sykeisuke/asic_rd/docs/HANDOFF.md

# Project handoff — design-team onboarding

Date: 2026-09-18 (architecture revision; first version 2026-08-31)

Audience: new design-team members joining the Tape-out 1 effort (first
reader: the first design-team member starting September 2026).

## 1. What this project is

A waveform-sampling ASIC prototype with an on-chip Wilkinson ADC on the
GF180MCU 180 nm process, targeting the **wafer.space GF180MCU Run 3** MPW.
Tape-out 1 is deliberately small — the goal is a reproducible end-to-end flow
(spec → schematic → simulation → layout → signoff → fabrication →
measurement), not performance:

```text
1 analog channel
-> 4 bottom-plate sampling cells (54.5 fF MIM each)
-> 1 broadcast ramp applied to the capacitors, 1 comparator per cell
   (fixed-reference trip; no analog MUX)
-> shared 8-bit Gray counter, 4 parallel captures
-> four 8-bit registers
-> 32-bit synchronous serial readout
```

The long-term objective (multi-GSa/s, 8 channels, 12-bit — an IRSX-class
sampler for physics instrumentation) is documented in the specification but
is explicitly **not** a Tape-out 1 pass/fail criterion.

## 2. Hard deadlines (wafer.space Run 3, reconfirm at purchase)

| Milestone | Date |
| --- | --- |
| Early-bird pricing | missed (2026-09-30) — slot changed to `1x0.5`, $6,500 incl. COB (2026-10-02) |
| Slot purchase deadline | 2026-12-09 |
| Clean-GDS submission deadline | **2026-12-16** |
| Silicon delivered | Q2 2027 |

## 3. Read these, in this order

1. [`PROTOTYPE_SPECIFICATION.md`](PROTOTYPE_SPECIFICATION.md) — the controlled
   scope: architecture, Must/Target/Stretch requirements, frozen technology
   choices.
2. [`lecture/ASIC_Lab_Handbook_EN.md`](lecture/ASIC_Lab_Handbook_EN.md) — the
   hands-on lab sequence. **Start at Lab 0 and satisfy each acceptance check
   before moving on**; it walks through the exact tools and circuits of this
   project.
3. [`VERIFICATION_MATRIX.md`](VERIFICATION_MATRIX.md) — what is verified and
   the exact `make` target that reproduces each result.
4. [`ROADMAP.md`](ROADMAP.md) — phase status; Phase 0 (external constraints)
   is essentially closed, Phases 2–3 are where design work continues.
5. [`PDK_PAD_SUPPLY_FREEZE.md`](PDK_PAD_SUPPLY_FREEZE.md) — frozen technology
   baseline (PDK commit, 3.3 V libraries, pads) and how each provider
   question was resolved.
6. [`TAPEOUT_BLOCKERS.md`](TAPEOUT_BLOCKERS.md) — the non-optional work
   between here and tape-out.
7. [`decisions/`](decisions/) — why each major choice was made (ADR style).

## 4. State of the project (2026-09-18)

**Architecture revision 2026-09-18** (design review with the collaborating
IC-design group; spec 0.6-draft): analog MUX removed, comparator per cell
with parallel conversion, 54.5 fF MIM hold capacitor, bottom-plate sampling
with the ramp applied to the capacitor, 8-bit ADC. The RTL and its tests are
updated (`make parallel-controller`, `make digital-top`); a transistor-level
cell method study on the exploration branch `keisuke/analog-explore` established that the comparator must
sense the plate whose switch opened first (constant pedestal, no parasitic
gain error) — see that branch's `simulations/gf180_bottom_plate_cell/RESULTS.md`. The
analog blocks (cell, comparator, ramp) are being re-derived against the new
spec; the v0.5 blocks listed below remain as legacy references.

**Done and reproducible** (all pre-layout, typical corner):

- GF180 transistor-level simulations of the v0.5 analog blocks (legacy):
  sampling cell, 4-cell array, analog MUX, ramp generator, comparator (NMOS
  and PMOS variants), single Wilkinson slice, 8-point transfer, and 4-cell
  sequential conversion. Each has a numeric pass/fail check and a `make`
  target. New (0.6): the bottom-plate 54.5 fF cell study.
- Synthesizable RTL (0.6): shared 8-bit Gray counter with four
  comparator-edge capture channels and parallel controller, 32-bit serial
  readout, integrated `asic_digital_top` — self-checking testbenches, GF180
  mapping, 20 MHz pre-layout STA. The sequential 6-bit controller is kept for
  the legacy co-simulations.
- File-based mixed-signal co-verification: measured SPICE comparator timings
  drive the real RTL; a ±2 ns clock-phase sweep identified cell 2 as having
  only ~500 ps of CDC margin (known open issue).
- A complete RTL-to-GDS LibreLane flow of the 8-bit digital top with zero
  DRC/LVS/timing/antenna violations at 3.3 V (`gf180mcu_as_sc_mcu7t3v3`).
- CI (GitHub Actions): every PR runs the RTL/co-simulation suite in the
  pinned container; the full analog regression runs weekly and on demand.

**Gate A (provider constraints) — resolved 2026-08:**

- wafer.space issues no written confirmations and no design support; the
  authority is the automated precheck and CoB checks on
  <https://platform.wafer.space>. Community help: the provider Discord
  (public archive at <https://discord.wafer.space>).
- Frozen baseline (revised 2026-11-01): PDK/Ciel commit `792ef670`, template release 1.6.0 (`d99f6e1b`),
  `gf180mcu_as_sc_mcu7t3v3` cells + `gf180mcu_ocd_io` pads, everything 3.3 V,
  `1x0.5` slot + chip-on-board (COB) packaging (changed from `0.5x1` on
  2026-10-02 when the other slots sold out; ADR 0004 addendum).
- **All grounds are common on the default COB breakout** → only `AVDD` can be
  separately measured. A padring experiment (template fork, branch
  `avdd-core-pair-experiment`) re-typed two bidir positions into a second
  core `vdd/vss` pair and **passed the platform's CoB pad-mask check and all
  DRC** (platform Check #800; the "Not Manufacturable" verdict is only the
  empty-core minimum-density artifact, resolved by fill in a real build).
  Experiment GDS: [release `padring-experiment-v1`](https://github.com/sykeisuke/asic_rd/releases/tag/padring-experiment-v1).
- Analog pad ESD: `asig` pads carry HBM diodes to DVDD/DVSS only. Design
  rule adopted from the GF180 DRM: add local CDM secondary protection (diode
  perimeter > 25 um, series poly R > 50 ohm) at every gate-connected pad.
- Platform project exists: Manufacturing ID `G803UHWS` (0.5x1, CoB, private) — to be re-created for `1x0.5`.

## 5. Highest-priority open work (proposed order)

0. **Pin list, top-level schematic and test plan first** (review 2026-10-02):
   fix the chip context before fine-grained block design. Then keep a script
   that generates the full-chip GDS at any time, with dummy blocks where
   needed, and run it as a nightly regression (`mixed_signal/top_placement`
   is the intended home). Missing commits matter: `main` must build.

1. ~~Retarget the digital physical flow to 3.3 V~~ — done 2026-09-25: every
   digital script and the physical flow use `gf180mcu_as_sc_mcu7t3v3`
   (fetched into `.eda-tools/pdk` by `make pdk`; the container image ships
   only the 5 V cells). `make digital-physical` is clean at 3.3 V.
2. **Comparator re-derivation for the fixed-reference trip** (design team;
   review guidance 2026-10-02: matched current sources, balanced output
   inverter, ~5 um fingers, width parameter is per finger, fix the delay
   result, expected offset sigma ~5 mV; latch the output inside the cell)
   — with the ramp
   applied to the capacitor, offset accuracy across 0.5-2.0 V is no longer
   required; the pair must stay functional while the sensed node moves to the
   ~2.0 V trip (spec 5.3). Re-derive the spec (noise via **transient-noise**
   simulation against kT/C = 275 uV at 54.5 fF, delay spread, power, area),
   then Monte Carlo and PVT on the chosen topology. The v0.5 NMOS/PMOS
   variants and the widened-window sweep on the exploration branch `keisuke/analog-explore` are reference material.
3. **Dense transfer test** before any no-missing-code claim.
4. **Analog layout** (bottom-plate cells with the on-chip switch-order
   delay, four comparators, ramp driving the cell bus, VREF, bias, test
   access) with DRC/LVS/PEX and post-layout simulation — the critical-path
   item for the December deadline. The v0.5 block layouts on
   `keisuke/analog-explore` (see its EXPLAINER) are reference material for
   the generators and the DRC/LVS flow, not for the circuit. Layout generation uses **gdsfactory**
   (in the pinned container, with the `gf180mcu` PDK plugin installed by
   `make tools`) so layouts are parametric Python under version control;
   signoff stays on the frozen PDK's KLayout DRC, Magic DRC, Netgen LVS, and
   Magic PEX. Pilot block: the sampling cell.
5. **Test-MUX truth table freeze** — the logical interface exceeds the six
   true analog pads; monitor/bias functions must be multiplexed (see
   [`TOP_LEVEL_INTERFACE.md`](TOP_LEVEL_INTERFACE.md)).
6. ~~Gray-capture metastability characterization~~ — no longer needed in
   the digital block (synchronous capture); the latch's aperture is
   characterized in `mixed_signal/latch` (SPEC S7).
7. **Ramp generator** for the capacitor load (4 x ~60 fF now, tens of pF to
   nF in later tape-outs), kept simple for Tape-out 1 (current source into a
   capacitor, possibly external); together with `V_BL`/`VREF`, ramp range and
   direction under the over-voltage constraint (spec 5.3).
8. ~~Synchronous capture option~~ — **adopted 2026-10-09, interface fixed
   2026-10-28** (ADR 0010): the digital top now matches
   `mixed_signal/Analog_top` (`q[3:0]` from the cells' `dfxtn_2` latches,
   `cnt_clk`, `ramp_rst` at TS_3 + 300 ns). Since 2026-11-03 (Analog_top
   v7, ADR 0027) the cell switch sequence is made inside the macro by
   `mixed_signal/sample_seq` from the digital top's acquire level `acq`;
   the digital delay lines are retired, which closes the PVT question on
   them. Open: a mixed-signal co-simulation of `tb_analog_top` with the
   RTL (the RTL reproduces the bench's latch rule by construction).
9. **Mixed-signal co-simulation of the new path**: bottom-plate cell crossing
   times into the parallel controller (replacing the legacy MUX co-sim).
10. **Digital-on-top integration** (review recommendation) — two implementations
   now exist and should converge: the design team's
   `mixed_signal/top_placement/` (in this repository: wrapper generator
   `macros.py`, hand-drawn analog pad wires `analog_routes.tcl`, full-chip
   run clean at 5 V / `fd_io`, see its README and RESULTS) and the
   template-fork run described below (3.3 V / `ocd_io`, `bi_a` pads,
   provider precheck). Proposed home: `mixed_signal/top_placement`, with
   the 3.3 V library set and the precheck added. Since PR #17 (2026-10-08)
   `mixed_signal/top_placement` builds from a clean checkout — verified
   2026-10-09 with the nightly sequence `make tools && make layout gf-inverter
   && ./scripts/sim.sh top-placement` (pass, 0 DRC/LVS/antenna/density
   errors, 8-bit digital top, analog pad wires drawn). The nightly CI job
   `nightly-chip` runs the same sequence. `mixed_signal/unit_cell_floorplan`
   still references inputs that are not in `main` (`comparator_unit_cell`,
   `simulations/gf180_sampling_unit_cell`, `EIGHT_BIT_RETARGET.md`). The recipe for
   turning a generator layout into a LibreLane hard macro and the seven
   pitfalls met on the way are recorded in
   `experiments/digital_on_top/RESULTS.md` on the exploration branch
   `keisuke/analog-explore` (clean P&R/DRC/LVS/STA with one
   analog macro, 2026-09-25), and the full-chip version (pad ring, 3.3 V,
   template fork branch `digital-on-top-chip-core`) is clean too. **Watch
   out:** the template's `asig_5p0` analog pads are not routable by the
   digital router and LVS passes even with the macro inputs floating; the
   experiment uses `bi_a` pads with a patched Liberty. Pad type for the real
   chip is an open decision (spec says `asig`). Next: the real cell /
   comparator macros.

## 6. Environment and daily workflow

Everything runs in one pinned Docker container (IIC-OSIC-TOOLS 2026.07,
pinned by tag **and** digest in `scripts/eda-common.sh`) — macOS or Linux
hosts both work; no tool installation beyond Docker:

```sh
./scripts/check-host.sh   # host sanity (macOS)
make check                # verify the pinned EDA environment
make tools                # once per checkout: pinned gdsfactory GF180 PDK plugin into .eda-tools/
make pdk                  # once per checkout: 3.3 V cells + pads not in the image, into .eda-tools/pdk
make nmos-dc              # first GF180 simulation (Lab 0)
make course-regression    # everything pre-layout
make vnc                  # browser-based Xschem/Magic desktop (see README)
```

Workflow rules (see README "Working agreement"):

- The English specification is the controlled scope; update the verification
  matrix when a requirement changes.
- Develop on a branch; merge to `main` only through a reviewed PR. CI must
  be green.
- Every change ships with its reproducing command, acceptance criterion, and
  evidence.
- Never commit PDK files, `work/`, `runs/`, RAW files, or credentials.
- The repository is released under Apache-2.0 (decided 2026-08-31, full open
  publication); contributions are accepted under the same license.

## 7. Channels

- GitHub issues/PRs in this repository — primary technical record.
- wafer.space Discord (<https://discord.gg/43y2t53jpE>): `#cob`, `#analog`,
  `#digital`, `#questions`, `#project-template`. Searchable public archive:
  <https://discord.wafer.space>. Two questions are currently posted (pad
  re-typing precedent in `#cob`; `asig_5p0` silicon experience in `#analog`).
- platform.wafer.space — automated precheck/CoB checks (the project lead
  holds the account).
