sykeisuke/asic_rd/mixed_signal/unit_cell_floorplan/physical/final_views/report.html

gf180mcuD · slope-ADC unit cell · comparator sized into its own hold capacitor · DCIC layout rules · DRC clean · no routing · 2026-09-18

# Re-sizing the comparator into a small hold capacitor shrinks the cell and makes it worse. The MIM still rides free; the MOM now costs 20 %.

Four to-scale floorplans of switch + hold capacitor + comparator for the per-cell-comparator slope ADC, each built around a 5T comparator re-sized into that cell's own capacitor by the same gm/Id tool that produced the recorded design, then measured on a mux-free bench. Laid out to the matching rules of Pretl's Design of Complex ICs and signed off on the PDK's KLayout deck.

UC_MIM · 54.5 fF over the tail

627

µm² · was 716 with the 1 pF-sized comparator · DRC 0

UC_MOM · 15.6 fF band under the p-well row

753

µm² · +20 % vs UC_MIM · DRC 0

UC_MIM_125 · 125 fF over the tail

614

µm² · was 716 · DRC 0

UC_MOM_125 · 8 × MOMU beside

922

µm² · +50 % vs UC_MIM_125 · DRC 0

Calibrated residual, best

0.059

LSB8 · the 1 pF-sized comparator on 54.5 fF · re-sized: 0.44

## 0 · What is being designed, against which spec

The project replicates the IRSX signal path — a switched-capacitor sampling array in which every storage cell carries its own comparator and one Wilkinson ramp converts all cells in parallel — scaled down for a first tape-out and meant to grow back to the IRSX class.

| Tape-out 1 as frozen | Studied here (8-bit retarget) | IRSX-class target
Resolution | 6 bit | 8 bit, 1 LSB = 5.859 mV | 12 bit, 1 LSB = 366 µV
Input range | 0.4–1.6 V | 0.5–2.0 V, the IRSX conversion window | same window
Sampling rate | 25 MSa/s | 25 MSa/s baseline; 100 MHz is the most the 8-bit cell holds; 200 MHz drawn | multi-GSa/s, 2.2 GSa/s quoted, 500 MHz analog bandwidth
Storage cell | 4 cells behind a mux | comparator per cell, no mux | 128+ cells × 8 channels
Hold capacitor | 1 pF | smallest that works: MIM floor 54.5 fF or MOM 15.6 fF | IRSX used 14 fF at 12 bits; here 125 fF for kT/C ≤ ½ LSB12
Comparator | shared, sized into 1 pF | re-sized into the cell's capacitor (this revision) | a 12-bit per-cell comparator, different design

## 1 · The comparator, sized into its own capacitor

comparator/size_p5t.py samples 40 000 gm/Id operating points and derives every width as current over current density from the gm/Id tables. Its kickback proxy is calibrated to the reference design's measured kick into 1 pF, so the hold capacitance cancels out of it and the proxy reads "millivolts into 1 pF" for any geometry. Sizing into another capacitor is therefore one budget change, made in ../comparator_unit_cell/size_uc.py without touching the tool: KICK_BUDGET = 1.465 mV × C_hold / 1 pF, the quarter-LSB as charge. Everything else — range, clock, headroom margin, drift and spread budgets, seed — is the tool's own.

Sized into | Input pair | Mirror load | Tail | Bias | C_in of the pair | Predicted kick into C_hold
17 fF (MOMU + its substrate plate) · mom16 | 12.4 µm / 0.4, nf 3, gm/Id 18.7 | 21.4 µm / 0.6, nf 5, gm/Id 22.1 | 49.6 µm / 1.0, nf 12 | 2.31 µA · I_REF 1.87 µA · 2.48:1 | 18.1 fF | 28.34 mV = 4.84 LSB
54.5 fF (5 × 5 µm MIM) · mim55 | 12.4 µm / 0.4, nf 3, gm/Id 18.7 | 21.4 µm / 0.6, nf 5, gm/Id 22.1 | 49.6 µm / 1.0, nf 12 | 2.31 µA · I_REF 1.87 µA · 2.48:1 | 18.1 fF | 8.85 mV = 1.51 LSB
125 fF (12-bit capacitor) · mim125 | 8.9 µm / 0.5, nf 2, gm/Id 16.7 | 4.5 µm / 0.5, nf 1, gm/Id 18.6 | 74.1 µm / 1.0, nf 19 | 2.30 µA · I_REF 1.24 µA · 3.70:1 | 15.9 fF | 3.89 mV = 0.66 LSB
1 pF (recorded cmp_p5t_8b) | 30.8 µm / 0.5, nf 8, gm/Id 17.5 | 12.4 µm / 0.5, nf 3, gm/Id 18.6 | 90.5 µm / 1.0, nf 20 | 6.30 µA · I_REF 2.78 µA · 4.52:1 | ≈ 45 fF | 1.59 mV into 1 pF

### Why the devices came out this way

- The tool found no feasible design at any capacitor and fell back to its minimax rule, the design whose worst budget ratio is smallest: 19× (kick) at 17 fF, 6× (kick) at 54.5 fF, 2.8× (spread) at 125 fF. Kickback ∝ W_in and delay spread ∝ 1/(W_in · I_D/W): the pair's width serves both budgeted terms in opposite directions, so the topology has no feasible point.
- At 17 and 54.5 fF the pair went to the matching floor and stopped: 12.4 µm at L = 0.4 µm is the narrowest device satisfying the tool's 4 µm² gate-area floor at the shortest L in its grid, where I_D/W is highest and the width for a given current smallest. Both capacitors get the same design because once kick dominates the minimax its argmin does not depend on the budget's scale. The kick charge floor of this topology is about 0.45 fC.
- The mirror load went wide (21.4 µm, gm/Id 22) at 17–54.5 fF: a higher (gm/Id)_load lowers the diode-node swing that Cgd couples onto the hold node — the second kick lever — at the price of C_outa and speed. The bench exposed the price: 131 ns of spread against a predicted 42 ns; the tool's spread model was validated only up to gm/Id_load ≈ 19.
- At 125 fF the kick ratio no longer dominates and the minimax moves to a balanced design: L = 0.5, a small load (4.5 µm), a longer tail at lower I_REF.
- Finger counts are the tool's nf = clip(round(W / 4 µm), 1, 20): 4 µm fingers, the DCIC "a few µm" rule. The tail is drawn as two halves of the same finger; BUF2, whose nf = 1 is hard-coded in the tool and whose width follows the sampled inverter ratio, is drawn with the same 4 µm rule (a single 9.9 µm finger would be a 10 µm tall device). BUF1/3/4 are inherited, unchanged.
- Currents fell to 2.3 µA per branch because at fixed gm/Id a narrower device carries less current; the tail followed as a mirror ratio, so the bias reference of mixed_signal/bias_reference (2.78 µA into a 20 µm diode leg) would be re-sized with it.

### Measured on the mux-free bench, five levels 0.5–2.0 V

Each sized-into comparator on its own capacitor, and the 1 pF-sized cmp_p5t_8b on the same capacitors as the control. "Calibrated residual" is what survives the per-cell straight-line (gain + offset) calibration the specification requires; "kick span" is how much the kickback changes with level, the part a constant cannot remove.

Comparator on capacitor | kick, max | kick span | delay spread (budget 12.5 ns) | code error | calibrated residual
mom16 on 17 fF, sized into it | 21.5 mV = 3.67 LSB | 2.35 LSB | 137 ns = 10.9× | 3 | 0.472 LSB
cmp_p5t_8b on 17 fF, sized into 1 pF | 44.4 mV = 7.58 LSB | 5.05 LSB | 33 ns = 2.6× | 1 | 0.085 LSB
mim55 on 54.5 fF, sized into it | 8.5 mV = 1.45 LSB | 0.85 LSB | 131 ns = 10.5× | 3 | 0.437 LSB
cmp_p5t_8b on 54.5 fF | 22.5 mV = 3.84 LSB | 2.36 LSB | 30 ns = 2.4× | 1 | 0.067 LSB
mim125 on 125 fF, sized into it | 4.0 mV = 0.69 LSB | 0.39 LSB | 69 ns = 5.5× | 1 | 0.159 LSB
cmp_p5t_8b on 125 fF | 11.7 mV = 1.99 LSB | 1.15 LSB | 30 ns = 2.4× | 1 | 0.059 LSB

Kickback is mostly calibratable; delay spread is not. On 54.5 fF the 1 pF-sized comparator kicks 3.8 LSB, yet 90 % of that is a constant plus a 0.3 % gain error and its calibrated residual is 0.067 LSB. The re-sized comparator kicks 2.6× less but its crossing delay walks 131 ns across the range, INL that survives the fit as 0.44 LSB. The tool's absolute-kick budget is the wrong objective for a per-cell comparator that will be calibrated; the right objectives are kick span and delay spread. For a calibrated cell, keep cmp_p5t_8b on either capacitor, or change topology (a source follower in front of the pair), not size.

## 2 · The four floorplans

Same placement rules in all four: a matched core on a vertical symmetry axis — tail halves over the ABBA input pair in one n-well, the mirror load under it in one p-well — the switch on the input side, the two inverters on the output side, a wiring channel between the wells, supply rails on the well rings. Device sizes, finger counts, the switch and the capacitor come from the sizing files.

### UC_MIM · 54.5 fF MIM on top

5 × 5 µm FuseTop over TAIL A/B in M4 / FuseTop / M5; hold node 72.7 fF with the pair's 18.1 fF.

22.10 × 28.36 µm = 627 µm² · comparator mim55 · switch WN/WP 0.52/1.04 µm · DRC 0

### UC_MOM · 15.6 fF MOM band under the p-well row

MOMU finger cap, M1–M4, inside the p-well ring; hold node 35.2 fF: the pair's 18.1 fF doubles the capacitor.

22.14 × 34.02 µm = 753 µm² · comparator mom16 · switch WN/WP 0.25/0.50 µm · DRC 0

### UC_MIM_125 · 125 fF MIM on top

7.69 × 7.69 µm FuseTop over the tail, inside the PMOS block's outline; hold node 141 fF.

22.34 × 27.50 µm = 614 µm² · comparator mim125 · switch WN/WP 1.00/2.00 µm · DRC 0

### UC_MOM_125 · 8 × MOM beside

Two abutted rows of four MOMU, a band under the p-well row; hold node 152 fF.

23.74 × 38.82 µm = 922 µm² · comparator mim125 · switch WN/WP 1.00/2.00 µm · DRC 0

PMOS, one n-wellNMOS, one p-wellhold capacitorsupply rail on the well ringwell outline · MIM keep-out · symmetry axis

## 3 · Where the silicon goes

Bars on a common scale, silicon only. The MIM's M4/M5 plate and keep-out (78 µm² at 54.5 fF, 133 µm² at 125 fF) is not on the bar because it costs no silicon; it costs the routing layers over the tail.

UC_MIM

269

353

627 µm²

UC_MOM

269

453

753 µm²

UC_MIM_125

260

347

614 µm²

UC_MOM_125

260

220

434

922 µm²

comparator devices (incl. 4 dummy fingers)switchcapacitor on siliconrings, wells, channel, slack

| UC_MIM | UC_MOM | UC_MIM_125 | UC_MOM_125
Comparator | mim55 | mom16 | mim125 | mim125
Hold capacitor | 5 × 5 µm MIM, 54.5 fF | 1 MOMU, 15.62 fF | 7.69 µm MIM, 125 fF | 8 MOMU, 125 fF
Hold node incl. the pair's gate | 72.7 fF | 35.2 fF | 141 fF | 152 fF
Capacitor silicon | 0 | 27.5 µm², band under the p-well row | 0 | 219.6 µm²
M4/M5 footprint with keep-out | 77.9 µm² | — | 132.7 µm² | —
Switch WN/WP, 200 MHz, 8 bits | 0.52 / 1.04 µm | 0.25 / 0.50 µm | 1.00 / 2.00 µm | 1.00 / 2.00 µm
Device area, 10 devices + dummies | 273.9 | 272.8 | 267.5 | 267.5
Cell, PR boundary | 22.10 × 28.36 = 626.8 µm² | 22.14 × 34.02 = 753.2 | 22.34 × 27.50 = 614.4 | 23.74 × 38.82 = 921.6
Same cell around the 1 pF-sized comparator | 716 µm² | 735 | 716 | 1048
MOM / MIM | | 1.202 (+126 µm²) | | 1.500 (+307 µm²)
kT/C at 300 K, on C_hold | 276 µV · 0.047 LSB8 · 0.75 LSB12 | 515 µV · 0.088 LSB8 · 1.41 LSB12 | 182 µV · 0.031 LSB8 · 0.50 LSB12 | same
DRC, gf180mcu.drc minus density | 0 | 0 | 0 | 0

### What the numbers say

1. The smaller comparator shrinks the cell 12 % and takes the MOM's free ride with it. Around the 1 pF-sized comparator the MOM fit in the p-well row's spare width; around the mim55 comparator the mirror row is the widest thing in the cell and the MOM costs its own 126 µm², 20 %. The MIM is free in every version, at 54.5 fF and at 125 fF.
2. The comparator's own gate is a hold capacitor. 18 fF of pair Cgg on the 17 fF MOM; the "15 fF cell" is a 35 fF node, its switch and its kT/C follow the sum, and the recorded comparator's 45 fF would have made it a 62 fF node.
3. Smaller is not better here. The re-sized comparators halve the kick and quadruple the delay spread, and after calibration leave 5–7× the residual of the 1 pF-sized one on the same capacitors (section 1). The area the resize saves buys nothing the cell can use.
4. At the 12-bit capacitor the MIM wins on area outright: eight MOM units add 307 µm², 50 %, while the 125 fF MIM grows over the tail inside the PMOS block's outline.
5. The switch follows the node, not the capacitor. Sized on C_hold + C_in at 200 MHz: 0.25 µm on the MOM node, 0.52 µm on the 54.5 fF node, 1.00 µm on the 125 fF node; all clamp at 0.22 µm at 25 MHz.

## 4 · The switch, sized on the node

τ = (T_track − T_edge) / ((N+1) ln 2), Ron_max = τ / C_node, WN = 2710 Ω·µm / Ron_max (the measured worst-case Ron·W of the 1:2 gate over 0.5–2.0 V), WP = 2 WN, clamp at 0.22 µm. The last column is the bandwidth view a GSa/s write-window cell sizes to instead, 1 / (2π Ron C_node) ≥ 500 MHz.

Node | C_hold + C_in = C_node | 8 b, 25 MHz | 8 b, 100 MHz | 8 b, 200 MHz (drawn) | 12 b, 200 MHz | 500 MHz bandwidth
MOM, mom16 | 17.0 + 18.1 = 35.2 fF | 0.22* | 0.22* | 0.25 | 0.36 | 0.30
MIM 54.5 fF, mim55 | 54.5 + 18.1 = 72.7 fF | 0.22* | 0.26 | 0.52 | 0.74 | 0.62
MIM 125 fF, mim125 | 125.0 + 15.9 = 140.9 fF | 0.22* | 0.49 | 1.00 | 1.44 | 1.20

WN in µm; * clamped at the minimum. At 2.2 GSa/s half-period settling would ask for 2–7 µm gates whose injection the sampling study already ruled out at 200 MHz; the GSa/s cell tracks over a long write window and is sized to bandwidth.

## 5 · The floorplan, rule by rule

From section 4.5 of Design of Complex ICs (iic-jku.github.io/design-complex-ic). The book's sentence, then what the floorplan does with it.

DCIC | In this floorplan
4.5.1 "A transistor with a large W should be split into multiple parallel devices (fingers) … of limited length (a few µm)" | the tool's 4 µm fingers, kept; BUF2 fingered by the same rule
4.5.2 "The devices are constructed from identical unit devices … of equal width (and equal L)" | INP/INN: one diffusion row of identical fingers; LOADD/LOADM: one diffusion row of identical fingers
"oriented in the same direction, and the current flow in all matched devices has the same direction — avoid mirroring" | every finger vertical, every row's current top to bottom; the tail halves stacked, not mirrored
"surrounded by similar structures; for edge devices, spend dummy elements (fig. 50)" | one dummy finger at each end of the pair and of the mirror, each with its own tie pad
"M1 and M2 share the centre source diffusion … directly usable as a differential pair or a current mirror" | the pair's tail node and the mirror's vss are the shared diffusions of their rows
"use common-centroid arrangements (fig. 52 b, linear ABBA)" | pair fingers DABBAABD (odd counts get the closest mirror-symmetric order), A gates on a top bar, B gates on a bottom bar; the mirror shares one gate net, so its A/B split is in the drain straps
"avoid low-level metal routing over sensitive devices" | the MIM sits over the tail halves, never over the pair
4.5.3 "Locations of pins and interfaces; distribution of VDD and VSS; wiring channels for signal buses" | input side left (TG N under TG P), output side right (BUF2/BUF4 over BUF1/BUF3), ramp to the pair's right end, pbias from the top; VDD rail on the n-well ring, VSS rail on the p-well ring; a 2 µm channel between the wells
4.3.4 MOM: "the lower metal layers should be skipped if the parasitic capacitance to the substrate is a concern" | MOMU is the M1–M4 unit as characterized (8 % of its charge to substrate)
4.3.4 MIM: "higher specific capacitance and low parasitics at extra cost" | 2.0 fF/µm² against 0.57; the cost here is M4/M5 over the tail

History of this cell: dense placement of the 1 pF-sized comparator, no matching rules, 615 µm² for either capacitor; DCIC rules around the same comparator, 716 µm² (+16 %); DCIC rules around the comparator sized into its capacitor, 627 µm² for the MIM cell — smaller, and electrically worse.

## 6 · Does the cell carry to 12 bits and 2.2 GSa/s?

Term | 8 bits, 25–100 MHz, now | 12 bits, GSa/s, target
kT/C | irrelevant at any C here (≤ 0.09 LSB8) | 15.6 fF: 1.41 LSB12; 54.5 fF: 0.75; 125 fF: 0.50. IRSX's 14 fF at 12 bits is counter resolution, not accuracy
Capacitor area | MOM +20 %, MIM 0 | MIM 0, MOM +50 %
Switch | 0.22–0.52 µm on the node | bandwidth-sized 0.3–1.2 µm, write-window timing; injection becomes a per-cell pedestal to calibrate
Comparator | the 1 pF-sized 5T, calibrated residual 0.06–0.09 LSB8 on 17–125 fF; the re-sized one 0.16–0.47 | a 12-bit per-cell comparator is a different design; a source follower in front of the pair removes the kick-charge floor; the rows and channel carry over, the widths will not
Array | — | 128 × 8 × 83 µW = 85 mW of comparators always on; power gating or a lower tail current, and the tail shrinks with it
Upper metals | MIM takes 78–133 µm² of M4/M5 per cell, both plates out through M5 (MIMTM.10) | array buses route around a MIM per cell; MOM leaves M5 free but takes M1–M4 of its own footprint

Verdict for the IRSX-class cell: MIM, 125 fF, over the tail, with the comparator selected on kick span and delay spread rather than absolute kick. No silicon for the capacitor at either resolution, a switch under 1.2 µm, and the only cost to the array is M4/M5 over 22 % of the cell.

## 7 · What had to be fixed to reach zero violations

Every violation found on the way was inside the PDK's transistor generator or in a placement collision, and each is now handled in floorplan.py; drc_devices.py checks every primitive standalone so a failure is attributed to a device, not a cell.

- M1.3, M1.2a · the generator's poly-contact M1 caps are under the M1 minimum area and, on L = 0.28 µm devices, 0.175 µm from the S/D M1 → the generator draws fingers and S/D contacts only, and the gate bars (poly, contacts, M1) are drawn here, 0.24 µm clear of the active.
- M1.3 on the switch · S/D pads on a 0.22–0.52 µm finger under the minimum area → stretched to 0.15 µm².
- OFFGRID · a 2.5 nm bbox half-extent moved whole instances off the 5 nm grid → every move snapped.
- CO.4 · a ring size on the 5 nm grid left one bar 0.065 µm over its contacts → ring sizes a multiple of 10 nm.
- PL.3a · on the ABBA pair the other net's poly ends sit 0.085 µm from a gate bar → two-bar devices place their bars 0.40 µm clear.
- CO.1/CO.3/CO.7/NP.5a/PL.4 · with the small comparator the mirror row is wider than the pair row and the switch NMOS, placed under the switch PMOS, landed on the mirror → it now stands clear of the mirror as well.
- The plugin's cap_mim draws the MIM-A stack on M2/M3 whatever its arguments say; the MIM is drawn from the MIMTM rules.

## 8 · Open

- No routing. Placement, wells, rings and gate bars only; the areas are floors.
- Re-state the sizing objective as kick span + delay spread and re-run; the tool computes everything needed except the span. That edit belongs to the comparator block.
- Topology: a source follower between the hold node and the pair (sfbuf) removes the 0.45 fC kick floor; its floorplan adds one PMOS row.
- Bias reference: the re-sized designs want 1.2–1.9 µA into the 20 µm diode leg; bias_reference was sized for 2.78 µA.
- LVS needs a routed netlist; the MIM's device recognition needs its MIM_L_MK checked; the MOM has no device.
- One corner, no mismatch, no PEX, ideal ramp, ideal reference. The negative result does not depend on any of those; the 125 fF numbers do.

Built by mixed_signal/unit_cell_floorplan/run.sh and mixed_signal/comparator_unit_cell/run.sh: gdsfactory 9.40.2 + gf180mcu 1.0.0 device generator, KLayout gf180mcu.drc variant gf180mcuD deep, ngspice 46; reusing comparator/size_p5t.py, analog_layout/mom_cap.py, analog_layout/signoff.py and the switch rule of gf180_sampling_unit_cell/design_cell.py by path.
