sykeisuke/asic_rd/chip_integration/flow/fig11_digital_on_top.png

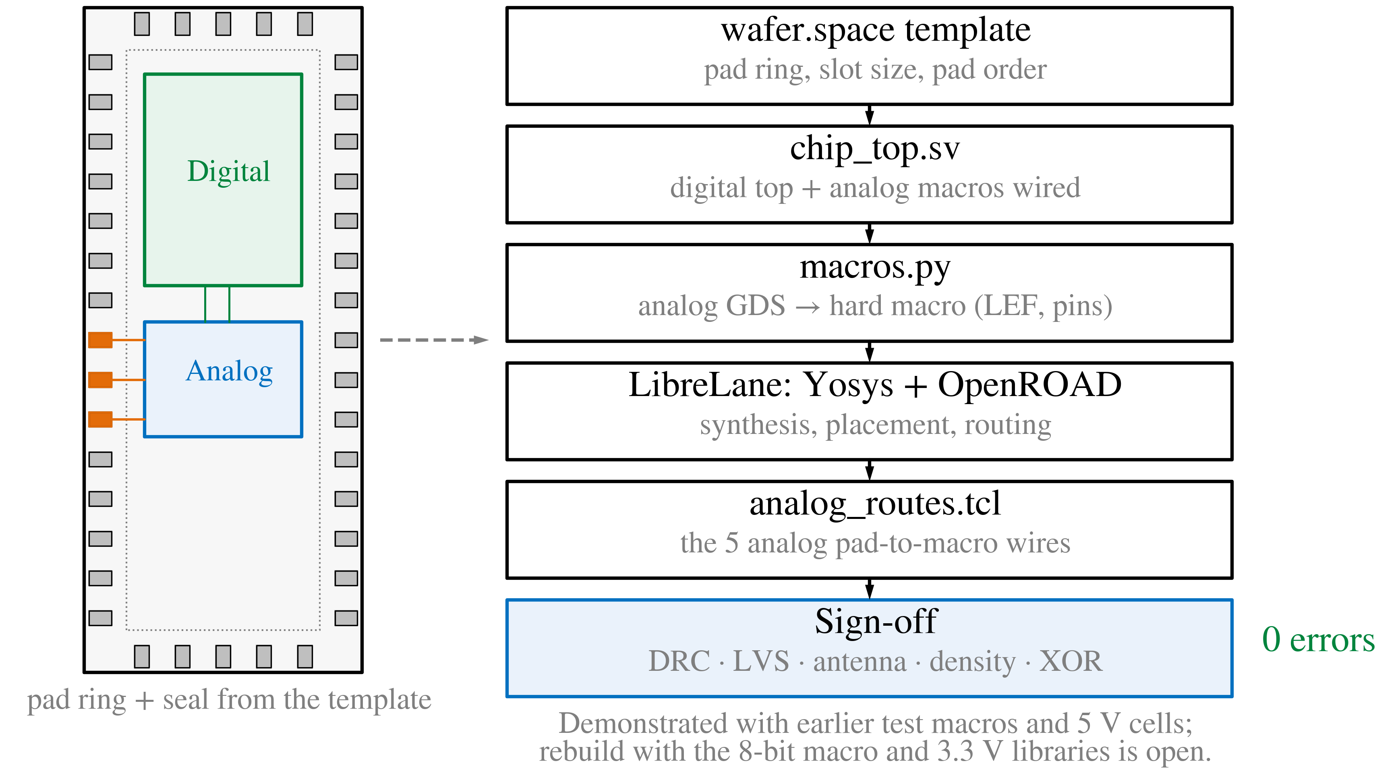
chip_integration/flow/fig11_digital_on_top.png
