sykeisuke/asic_rd/chip_integration/renders/00a_input_analog_gds.png

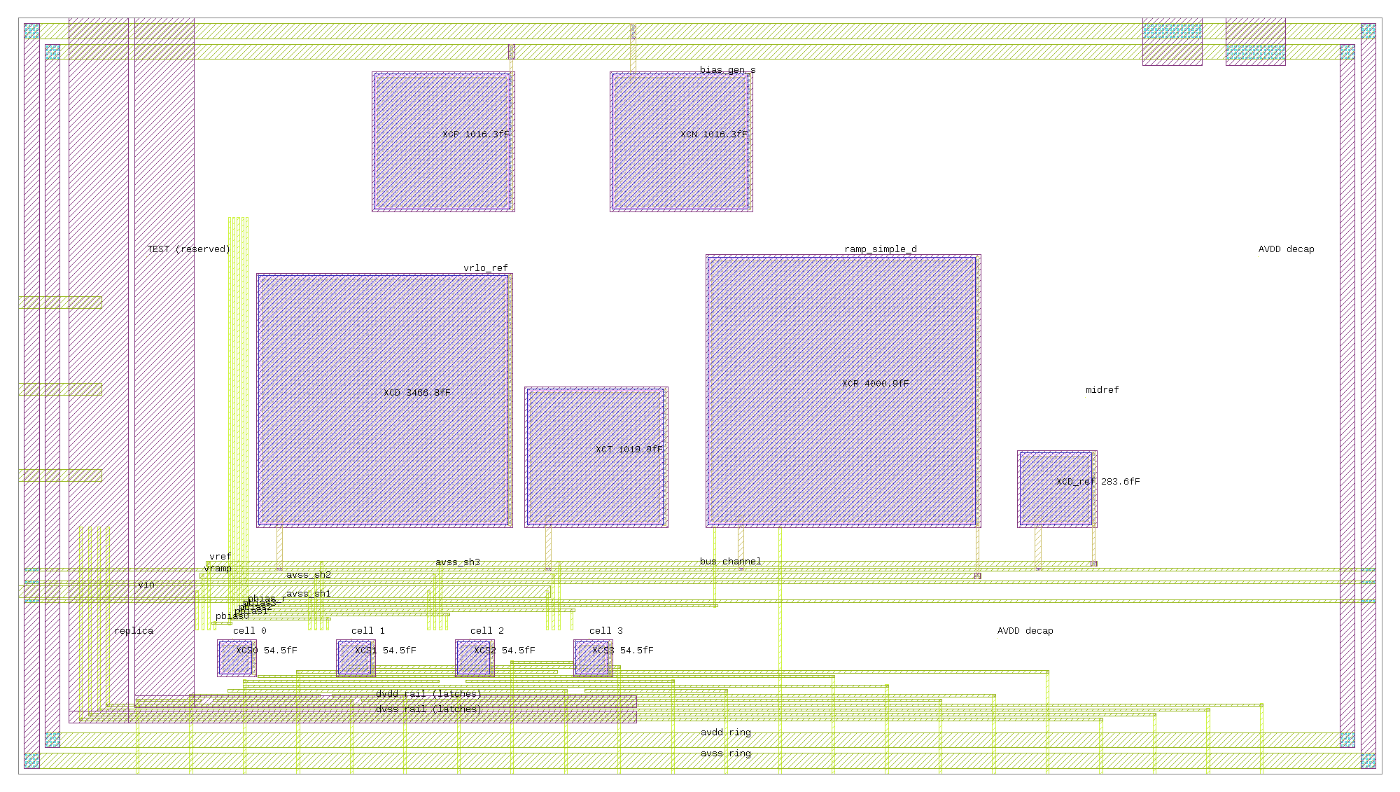
chip_integration/renders/00a_input_analog_gds.png
