sykeisuke/asic_rd/chip_integration/renders/00c_input_template_ip.png

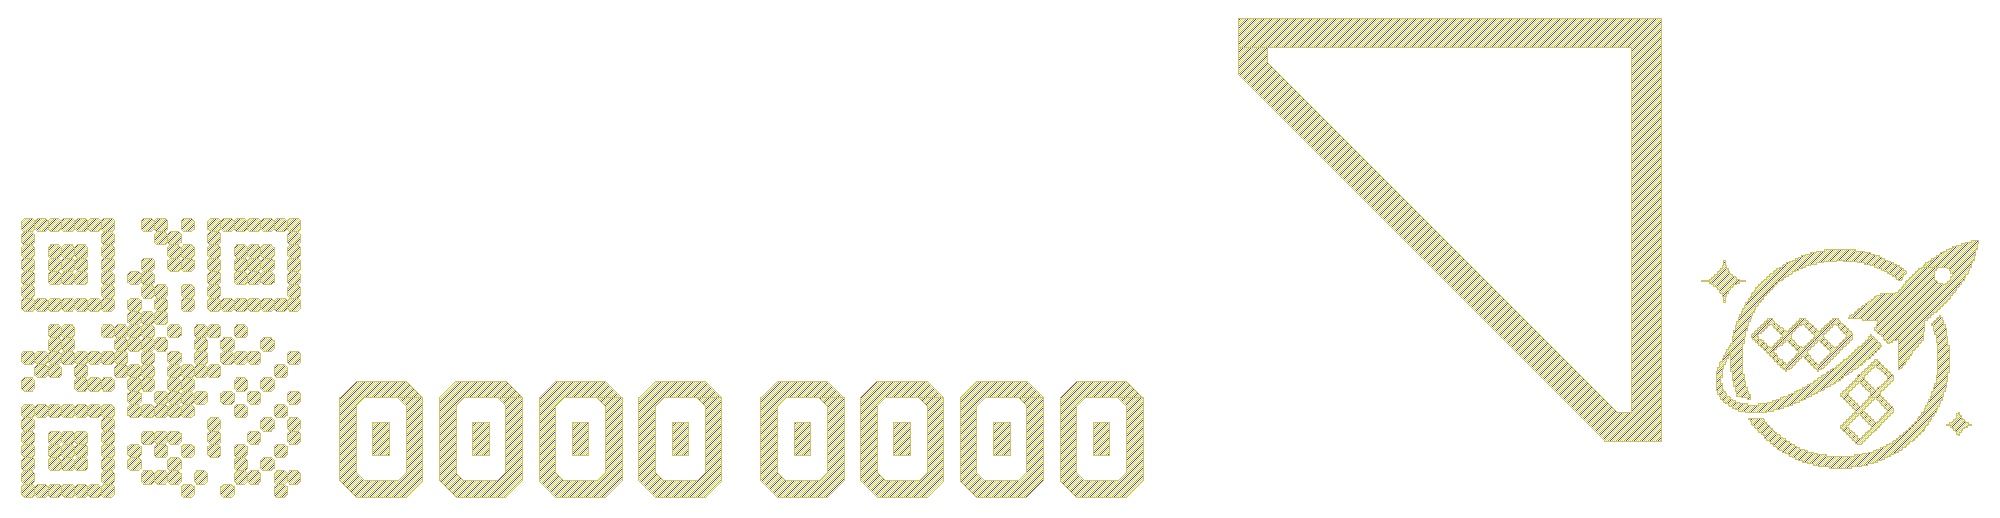
chip_integration/renders/00c_input_template_ip.png
