sykeisuke/asic_rd/chip_integration/renders/03a_analog_macro_lef.png

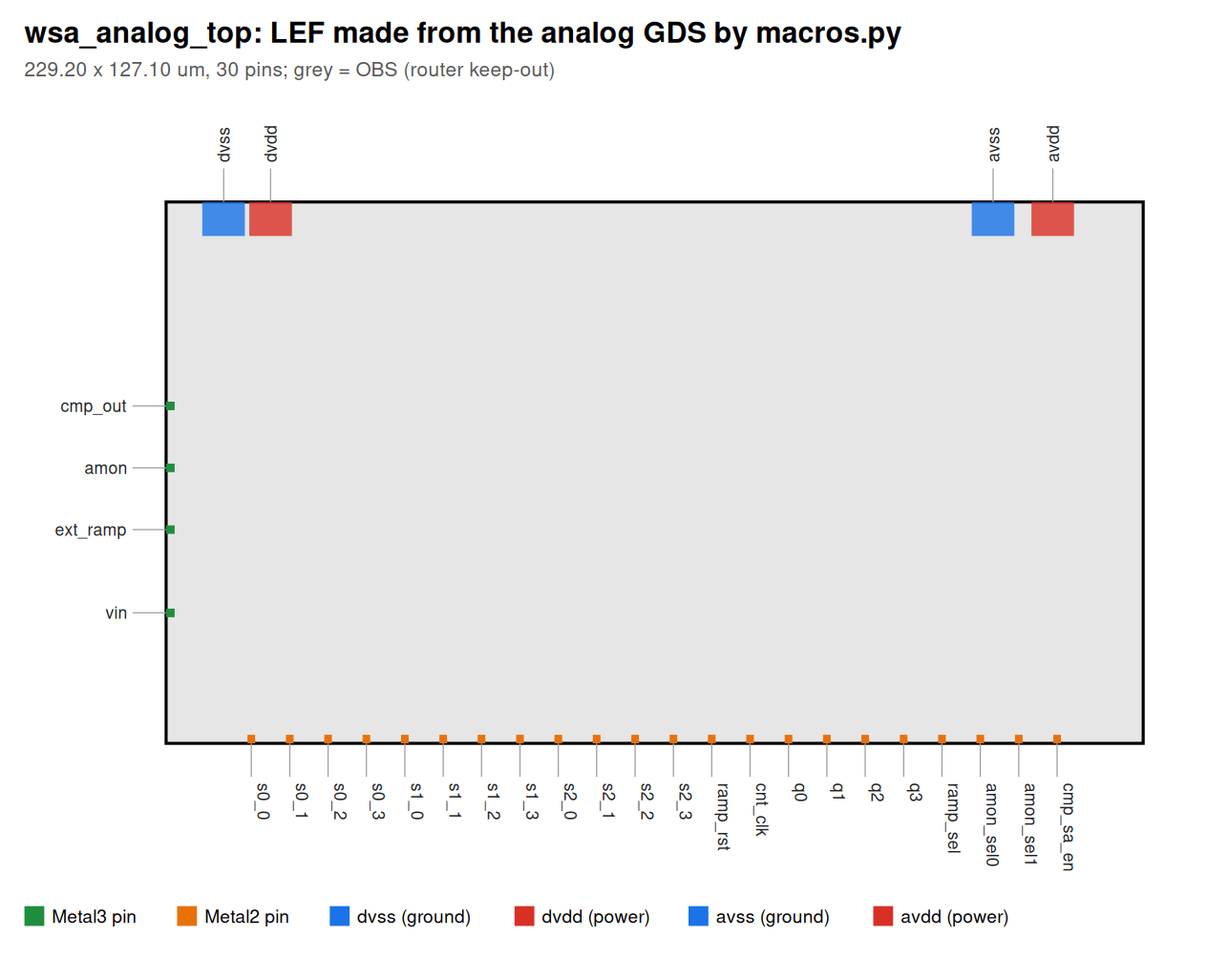
chip_integration/renders/03a_analog_macro_lef.png
