sykeisuke/asic_rd/chip_integration/renders/03b_digital_macro_lef.png

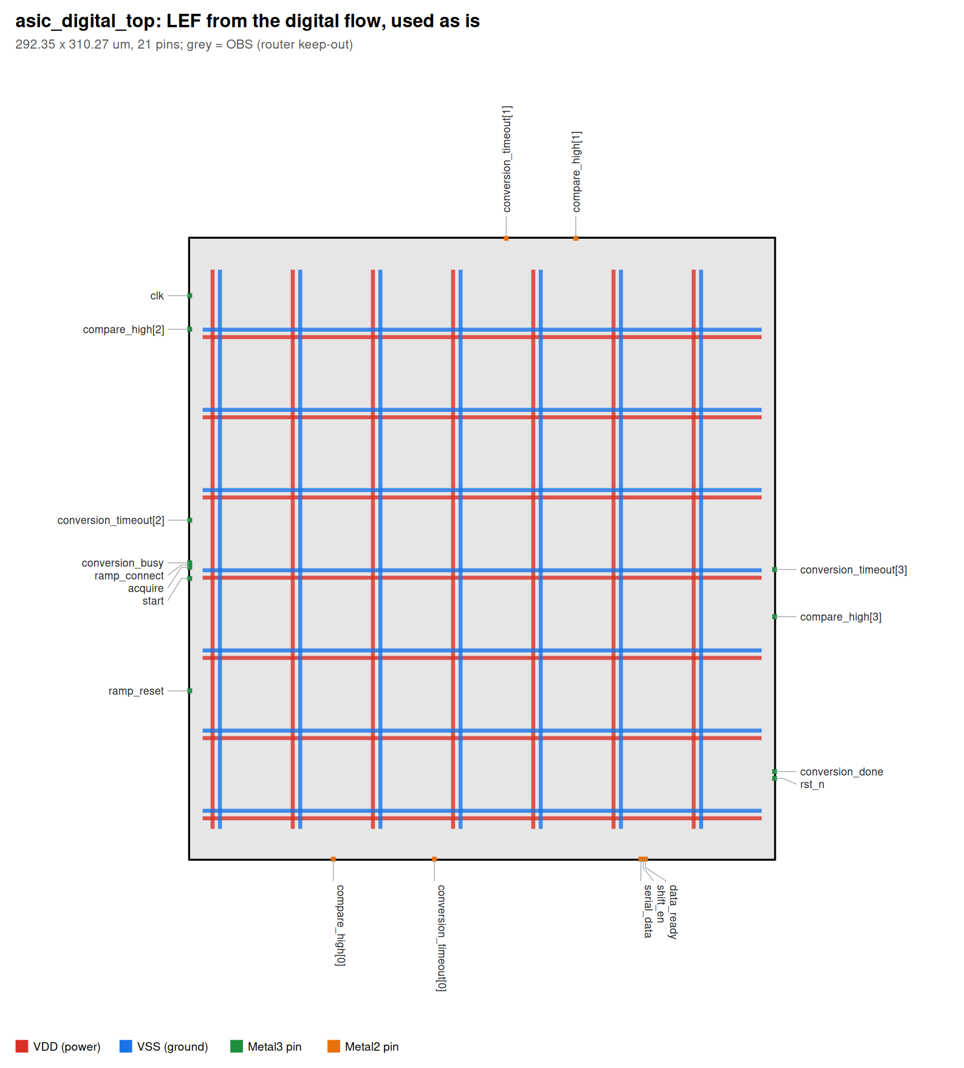
chip_integration/renders/03b_digital_macro_lef.png
