sykeisuke/asic_rd/chip_integration/renders/04c_placement_cts.png

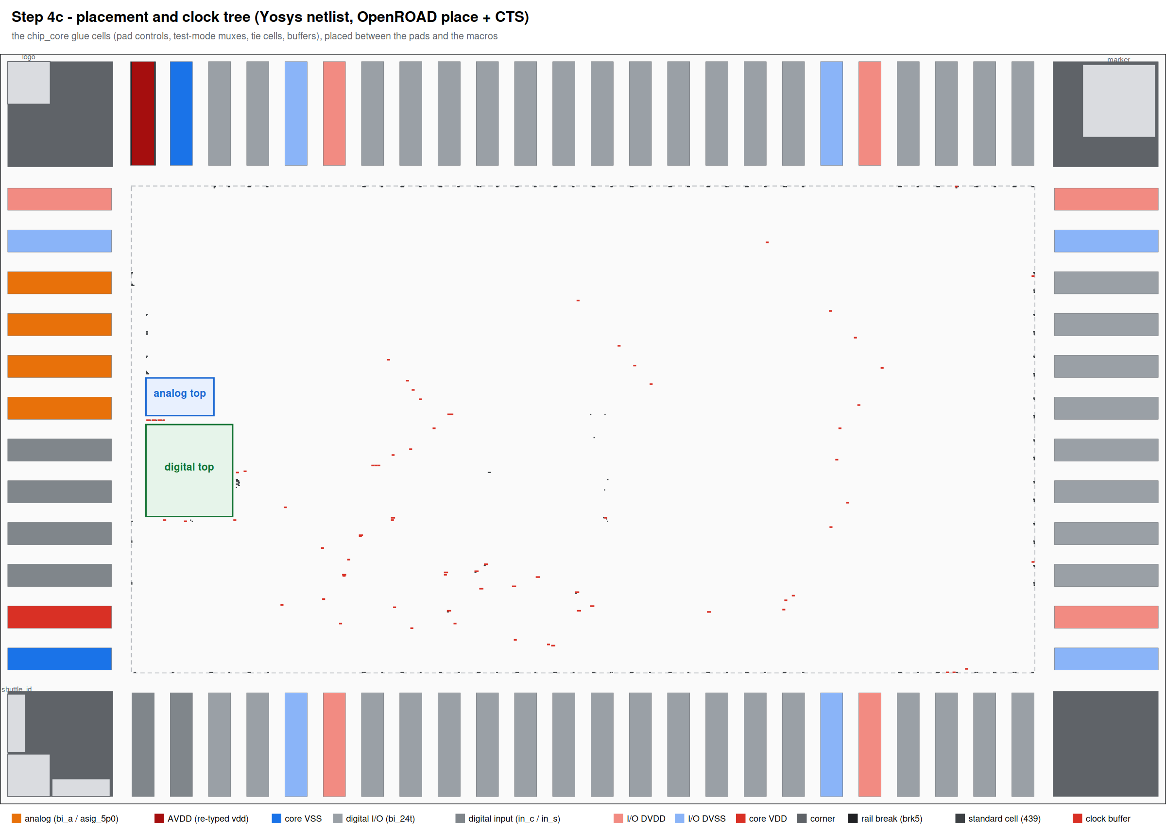
chip_integration/renders/04c_placement_cts.png
