sykeisuke/asic_rd/chip_integration/renders/06c_chip_analog_wires_zoom.png

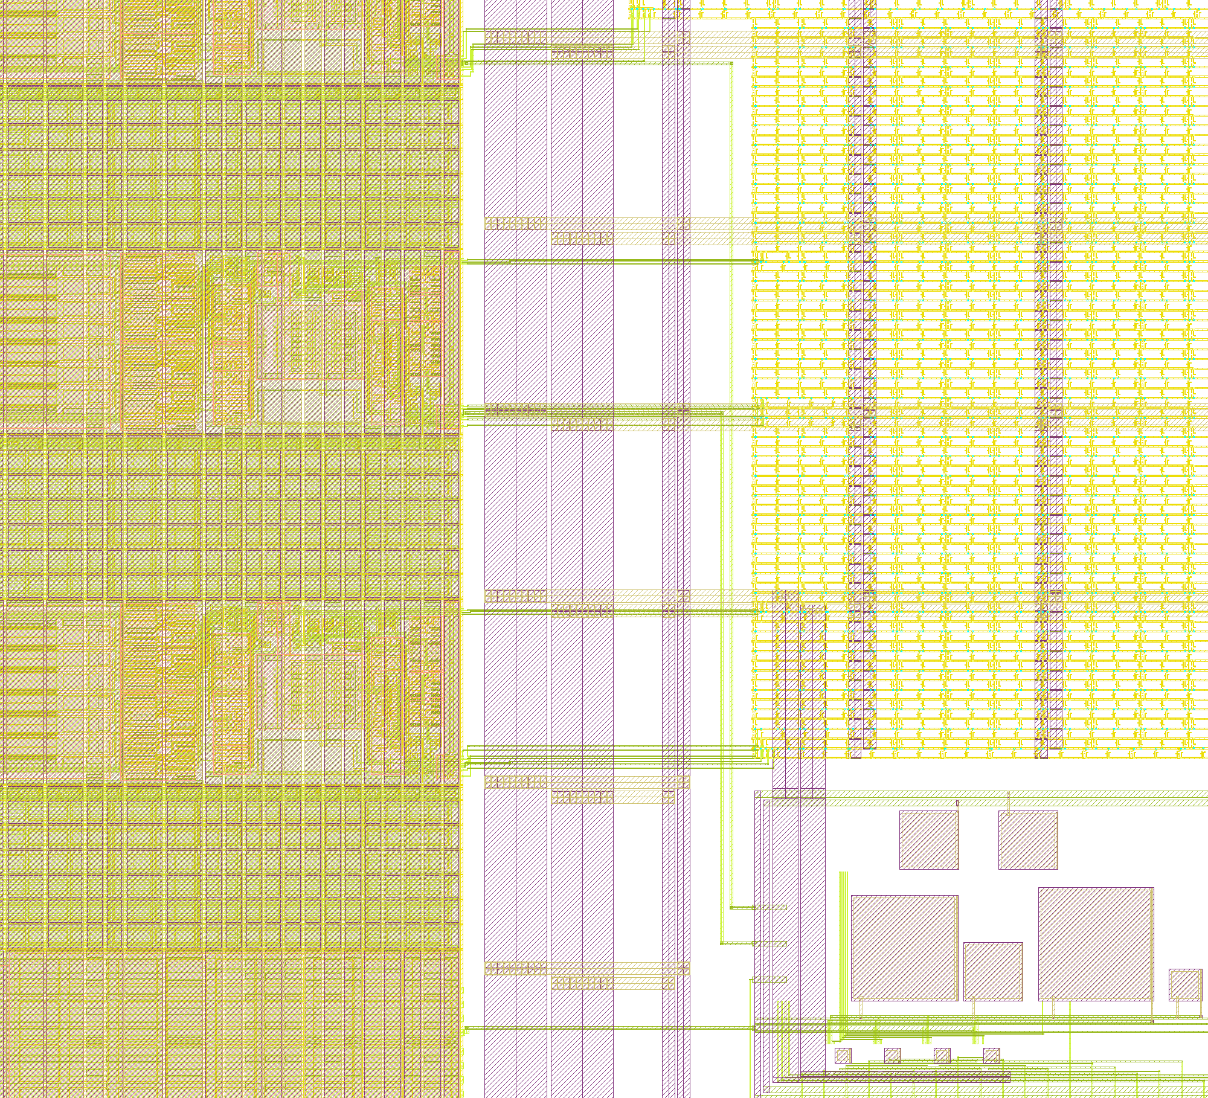
chip_integration/renders/06c_chip_analog_wires_zoom.png
