sykeisuke/asic_rd/digital/asic_digital_top/physical/final_views/render/asic_digital_top.png

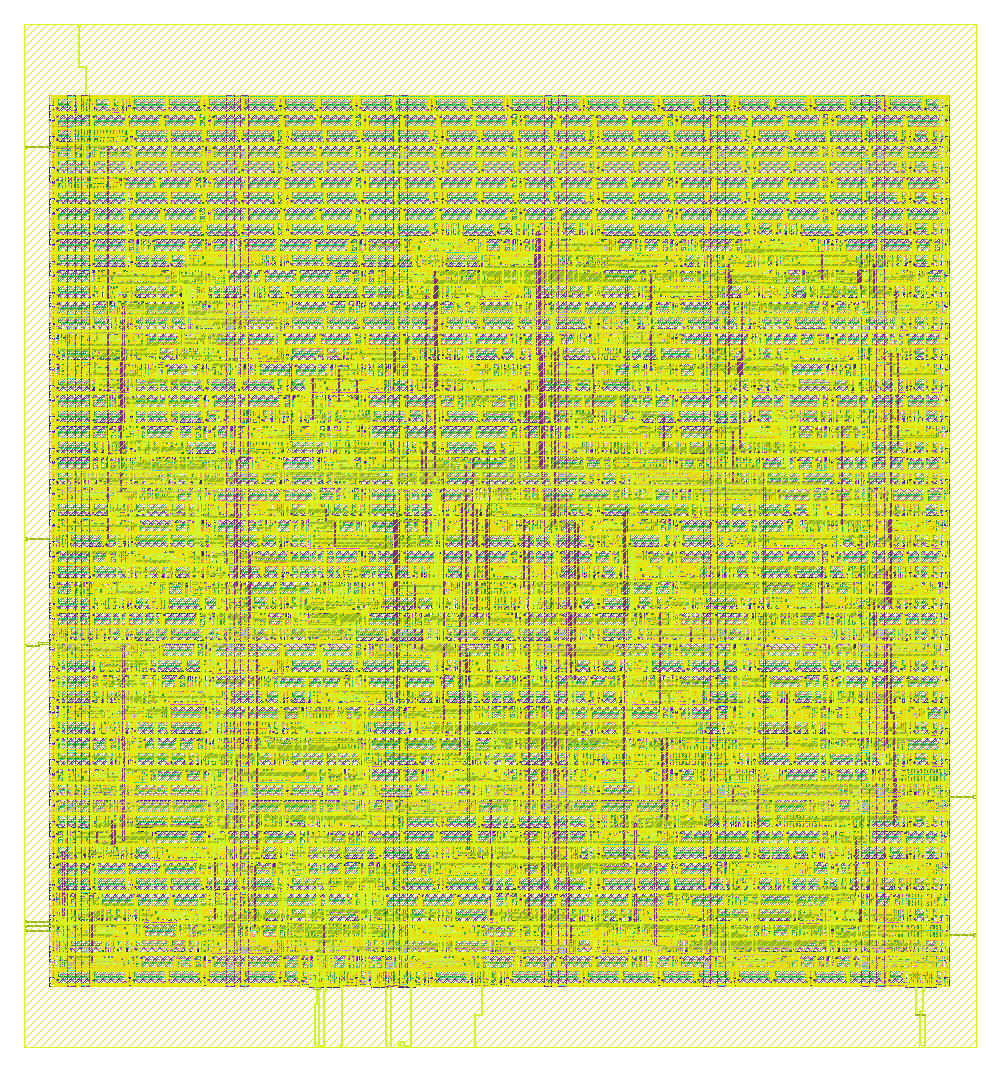
digital/asic_digital_top/physical/final_views/render/asic_digital_top.png
