sykeisuke/asic_rd/mixed_signal/analog_layout/physical/final_views/render/CMP.png

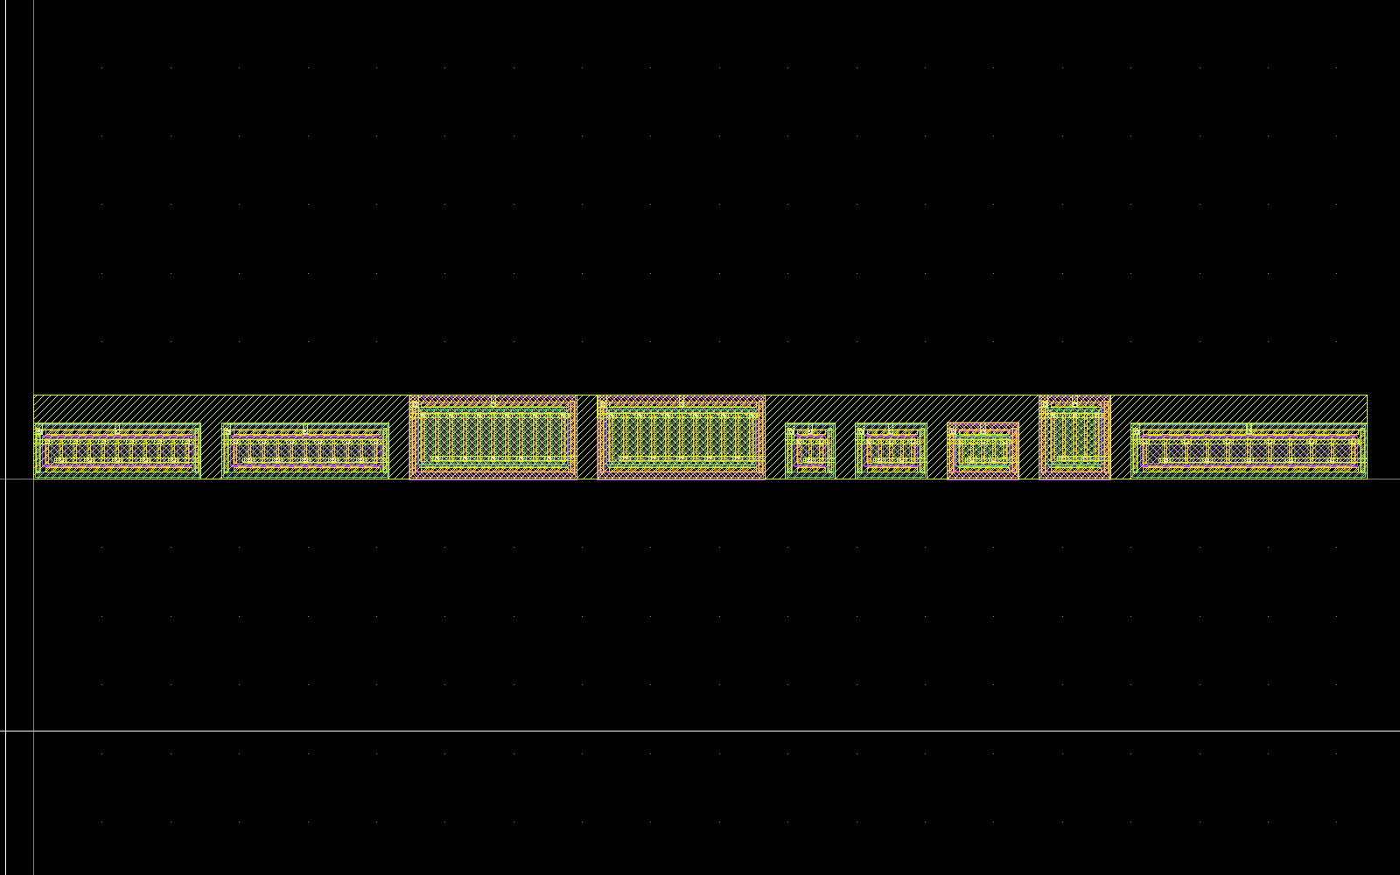
mixed_signal/analog_layout/physical/final_views/render/CMP.png
