sykeisuke/asic_rd/mixed_signal/analog_layout/physical/final_views/render/INV.png

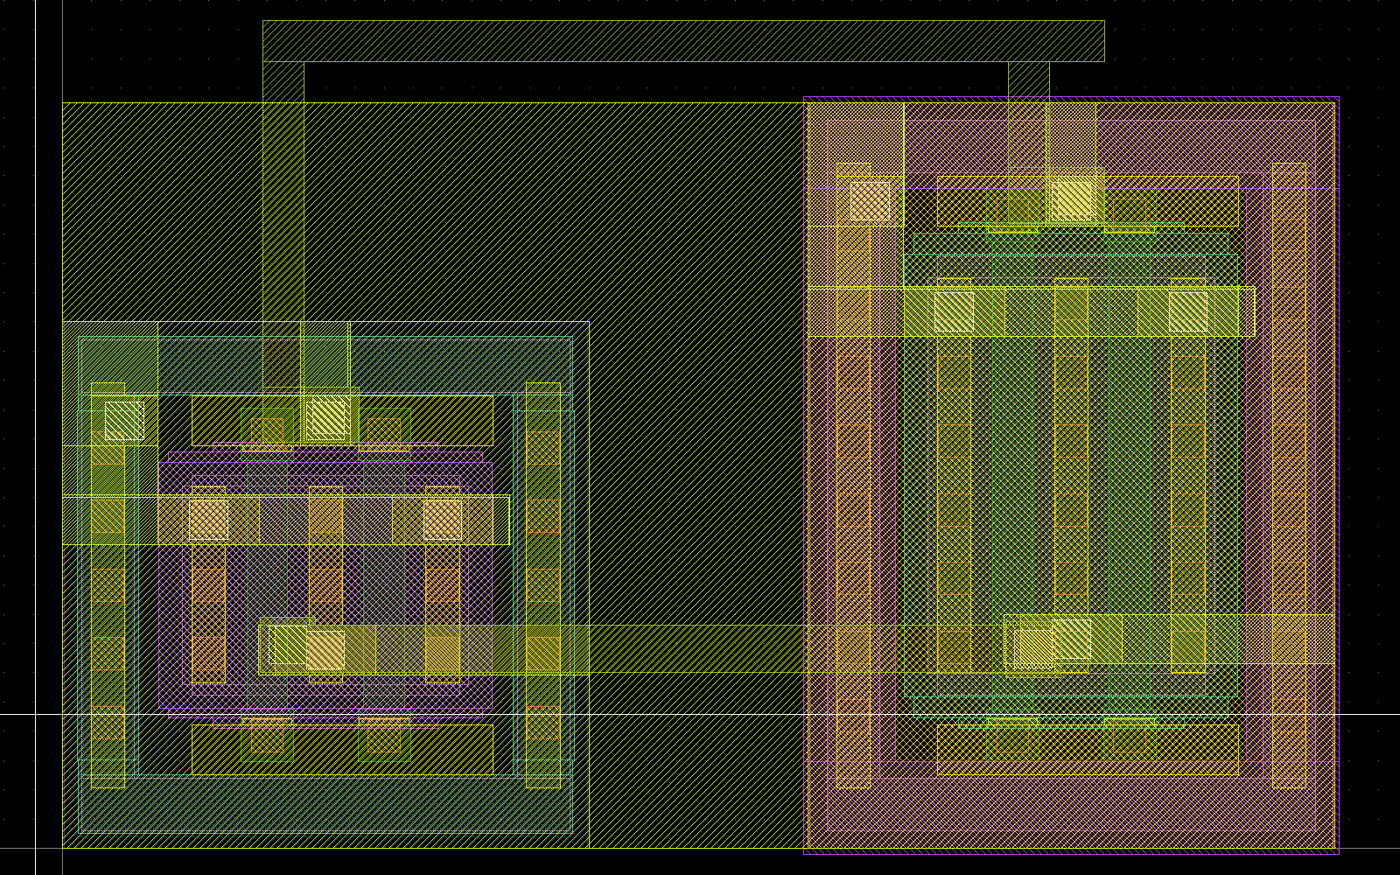
mixed_signal/analog_layout/physical/final_views/render/INV.png
