sykeisuke/asic_rd/mixed_signal/Analog_top/assets/bias_gen_s.png

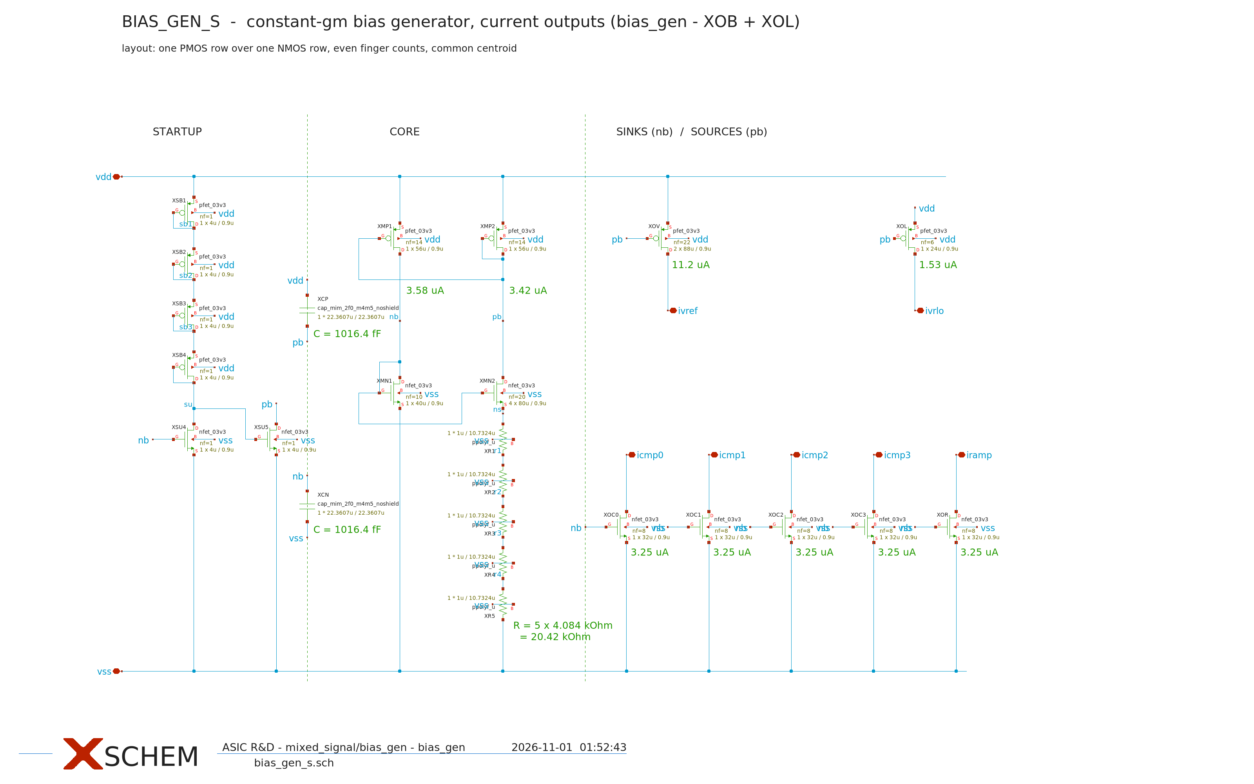
mixed_signal/Analog_top/assets/bias_gen_s.png
