sykeisuke/asic_rd/mixed_signal/Analog_top/assets/func_overview.png

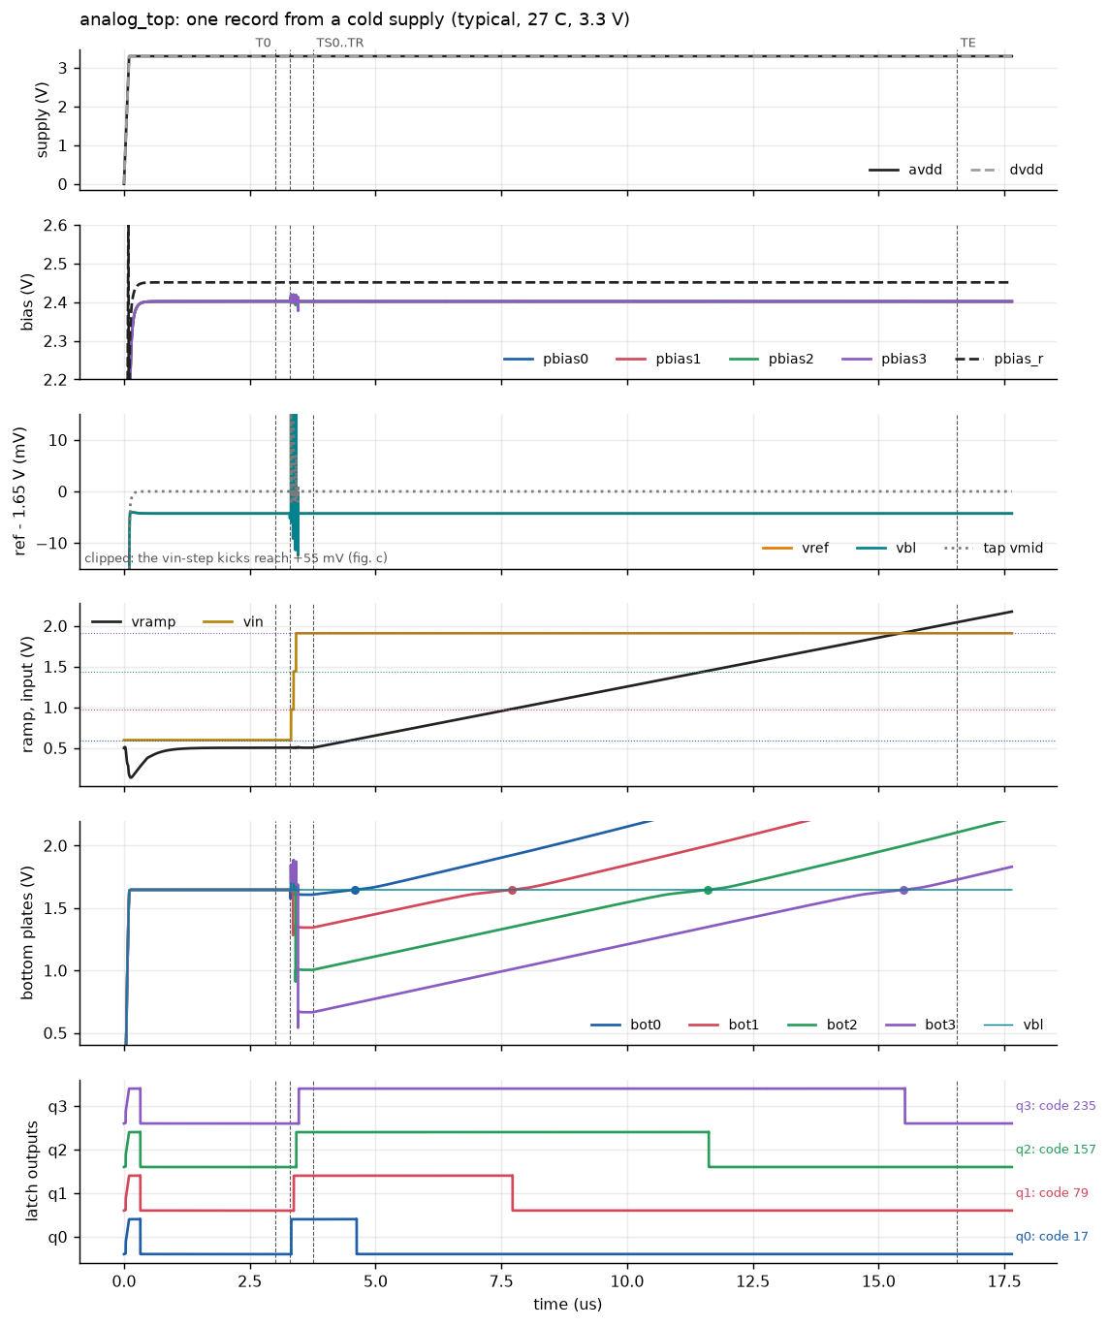
mixed_signal/Analog_top/assets/func_overview.png
