sykeisuke/asic_rd/mixed_signal/Analog_top/assets/func_sampling.png

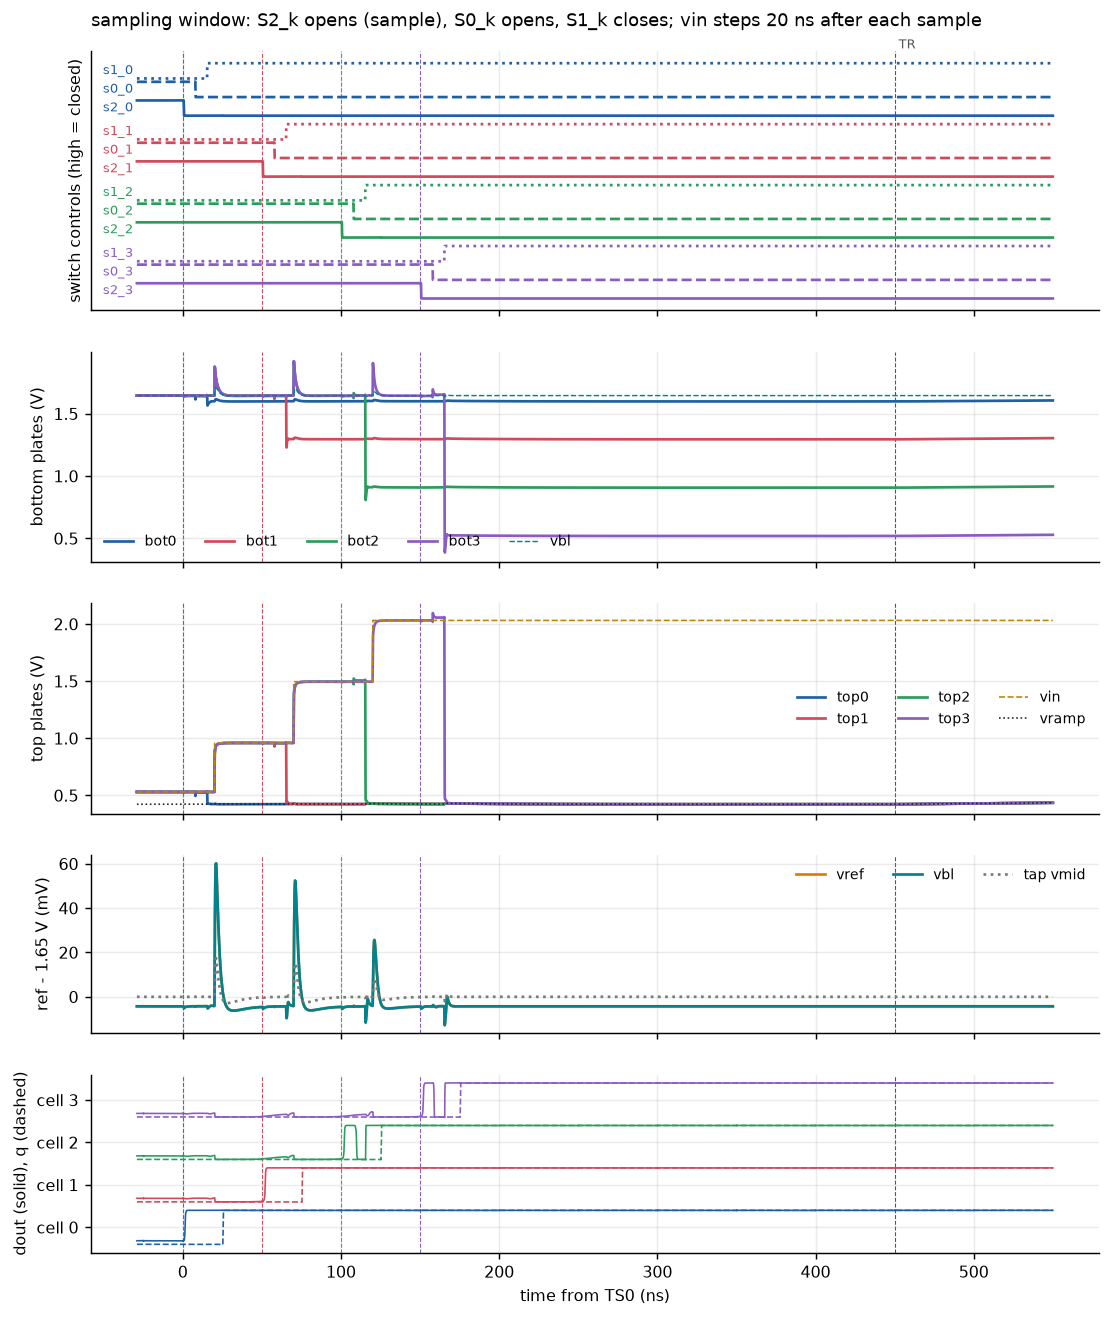
mixed_signal/Analog_top/assets/func_sampling.png
