sykeisuke/asic_rd/mixed_signal/Analog_top/assets/func_trips.png

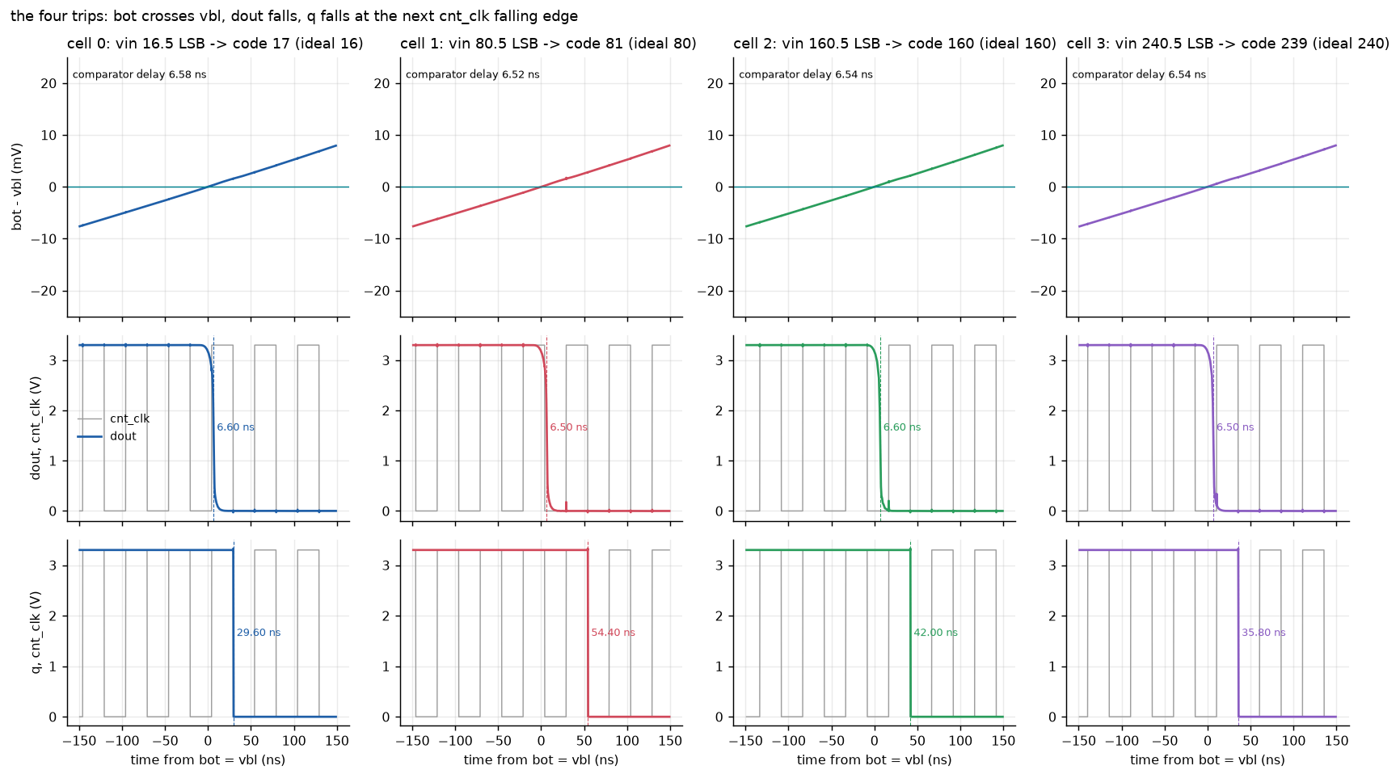
mixed_signal/Analog_top/assets/func_trips.png
