sykeisuke/asic_rd/mixed_signal/Analog_top/assets/pwr_profile.png

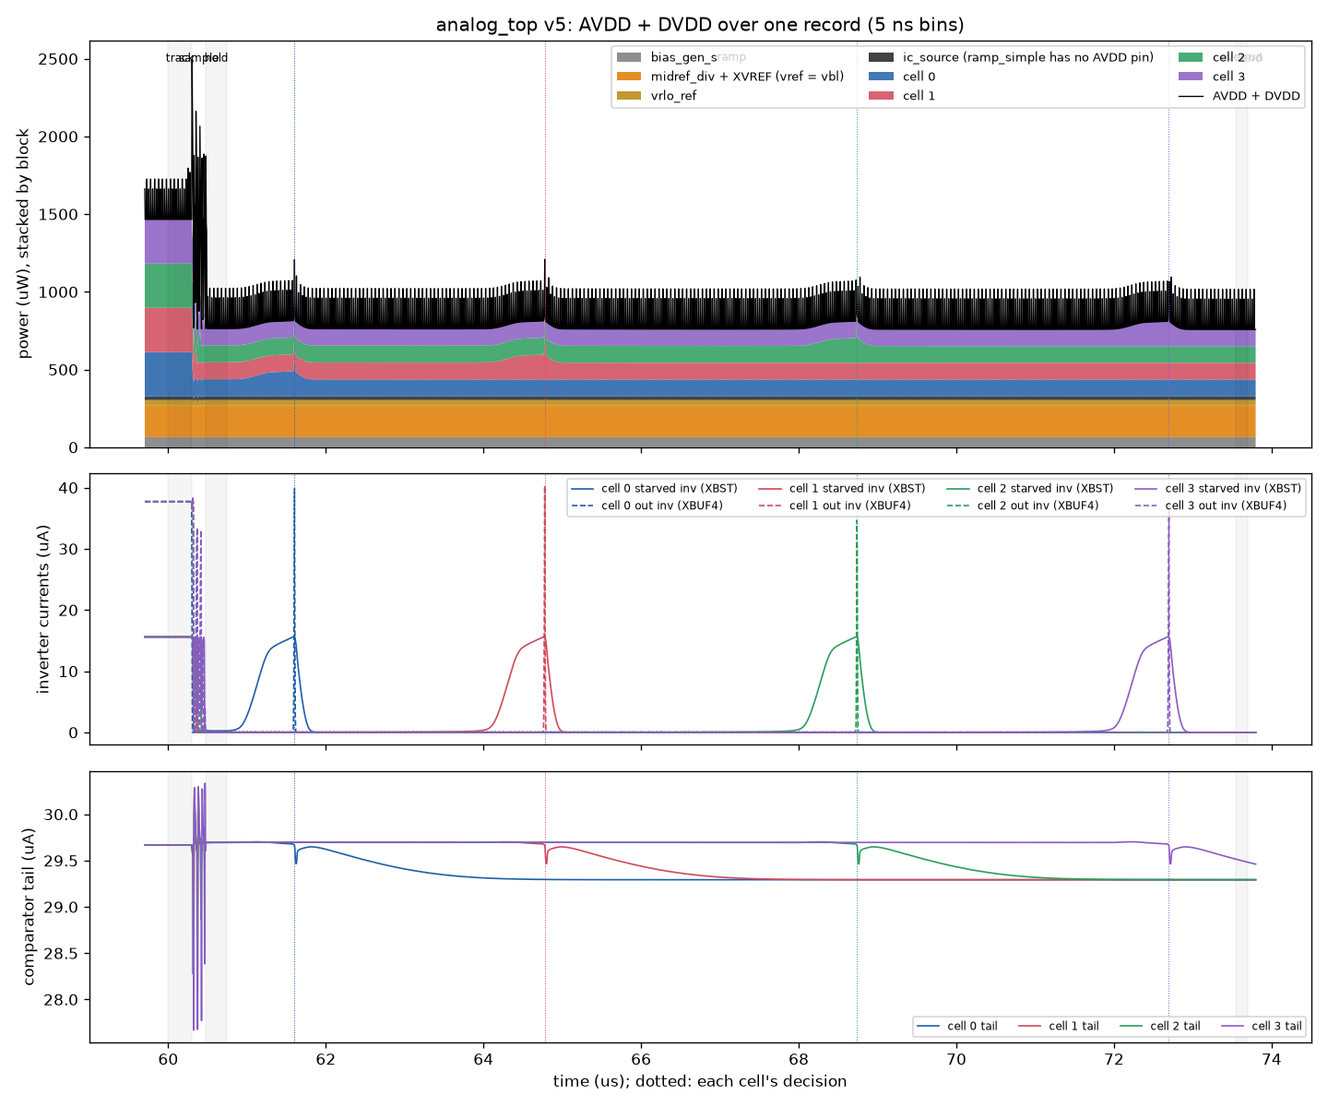
mixed_signal/Analog_top/assets/pwr_profile.png
