sykeisuke/asic_rd/mixed_signal/Analog_top/assets/sw_s0.png

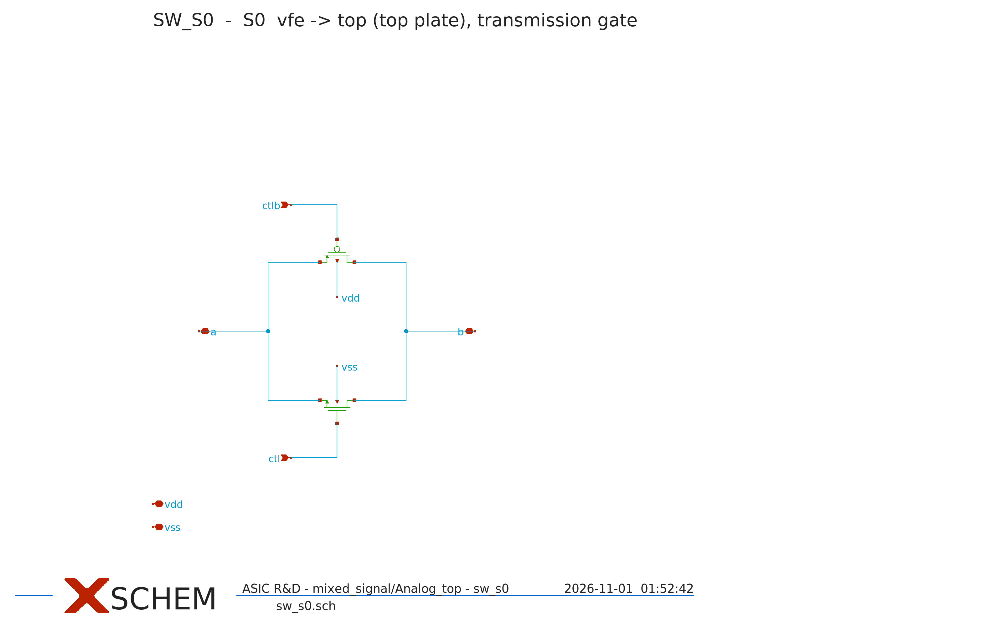
mixed_signal/Analog_top/assets/sw_s0.png
