sykeisuke/asic_rd/mixed_signal/Analog_top/assets/sw_s2.png

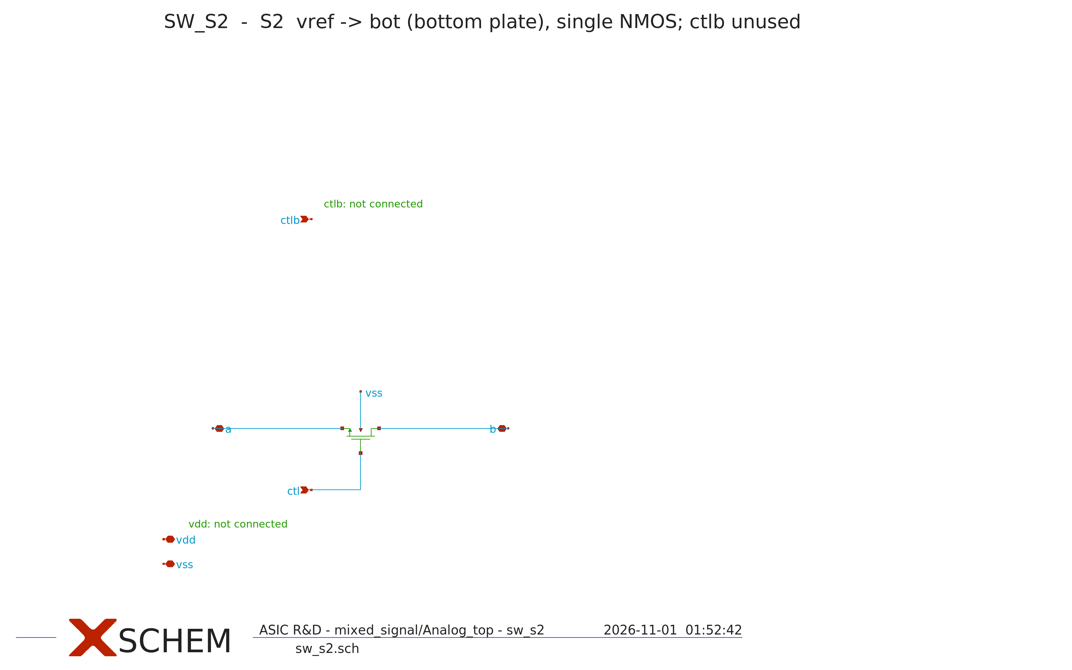
mixed_signal/Analog_top/assets/sw_s2.png
