sykeisuke/asic_rd/mixed_signal/Analog_top/assets/symbol_gallery.png

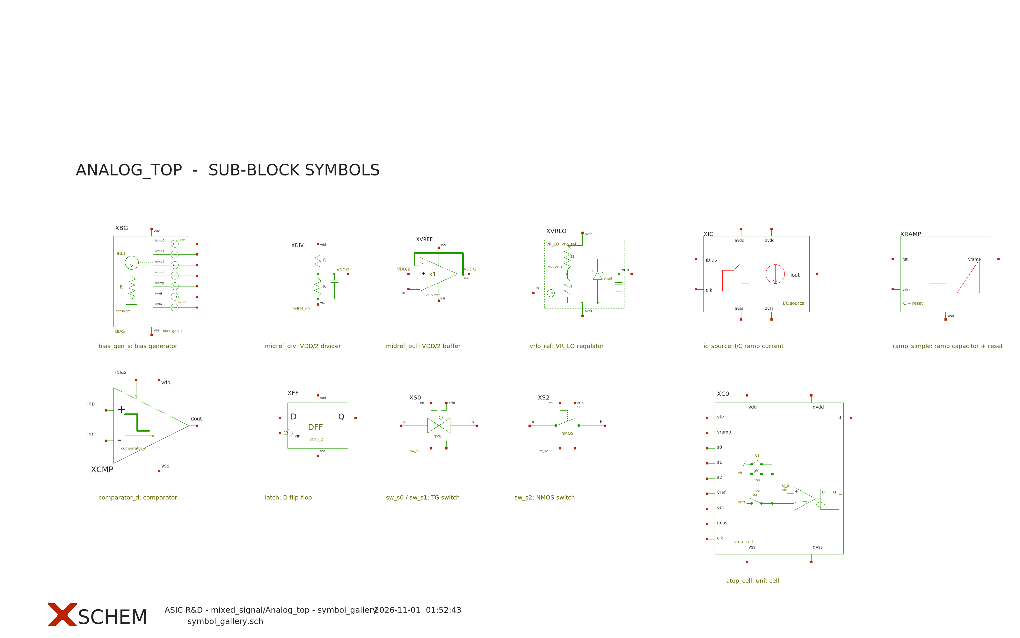
mixed_signal/Analog_top/assets/symbol_gallery.png
