sykeisuke/asic_rd/mixed_signal/Analog_top/assets/tb_analog_top.png

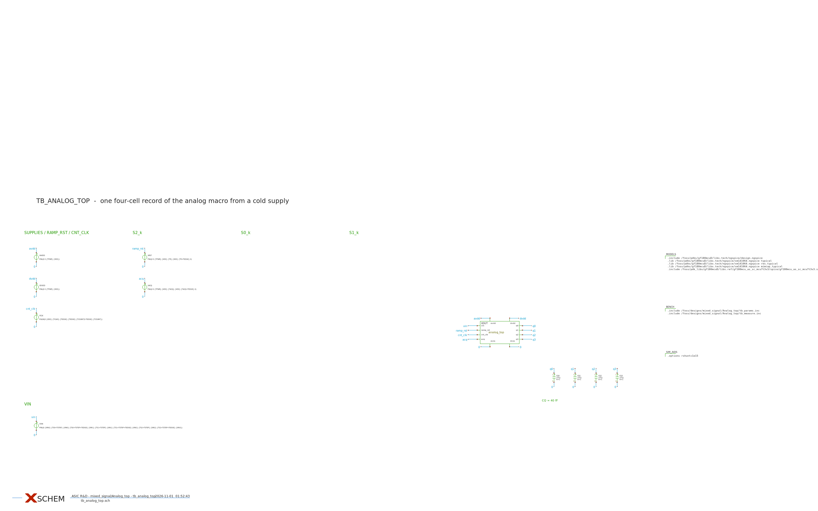
mixed_signal/Analog_top/assets/tb_analog_top.png
