sykeisuke/asic_rd/mixed_signal/bias_gen/assets/tb_mc.png

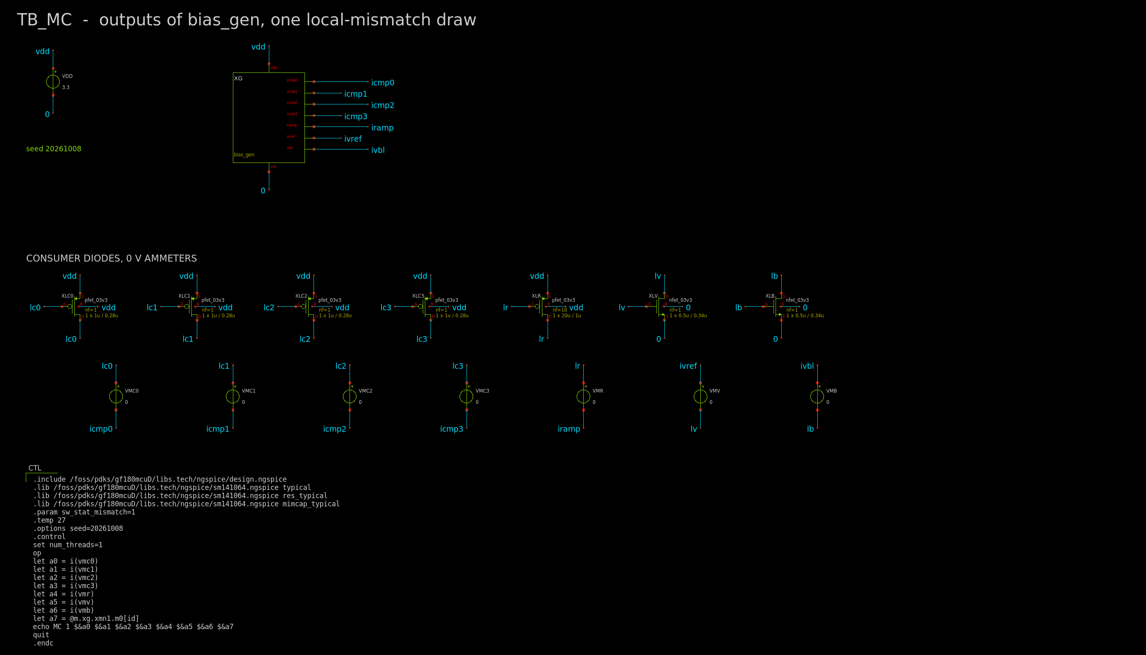
mixed_signal/bias_gen/assets/tb_mc.png
