sykeisuke/asic_rd/mixed_signal/bias_gen/assets/tb_noise.png

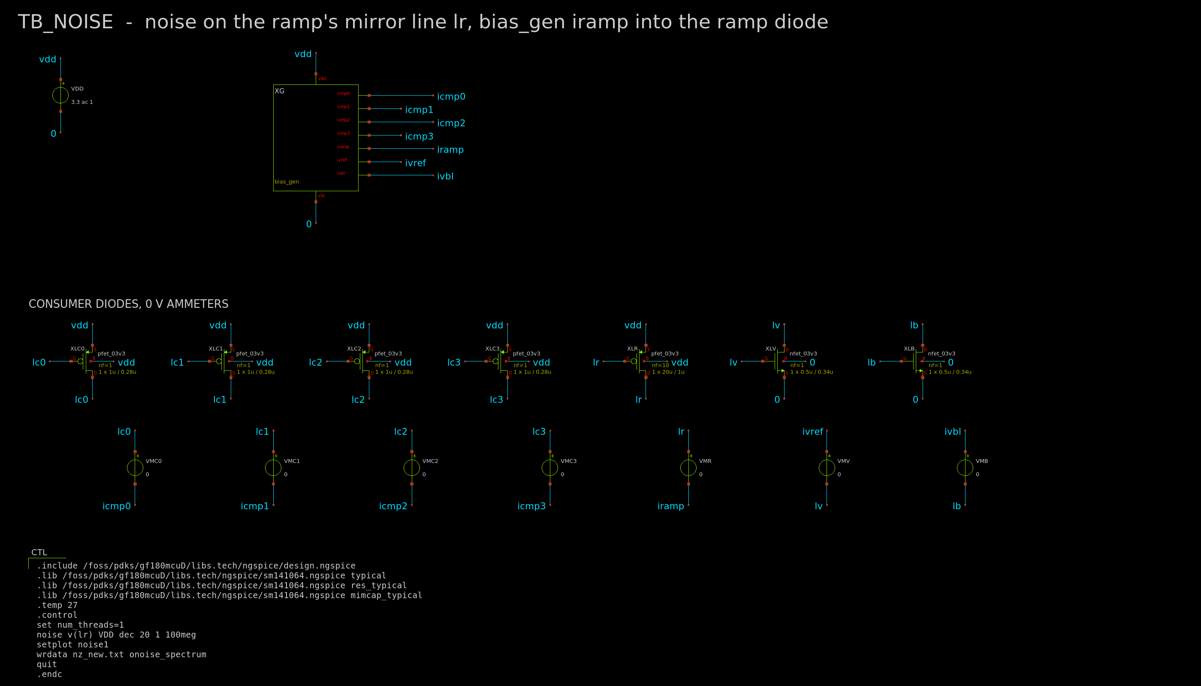
mixed_signal/bias_gen/assets/tb_noise.png
