sykeisuke/asic_rd/mixed_signal/bias_gen/assets/tb_startup.png

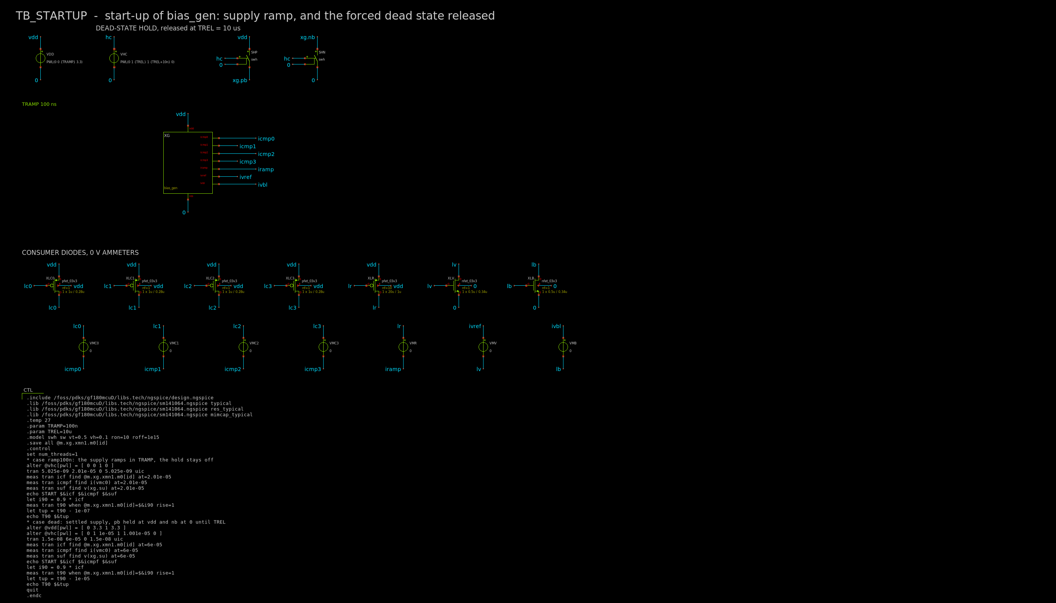
mixed_signal/bias_gen/assets/tb_startup.png
