sykeisuke/asic_rd/mixed_signal/bias_gen/assets/tb_xtalk.png

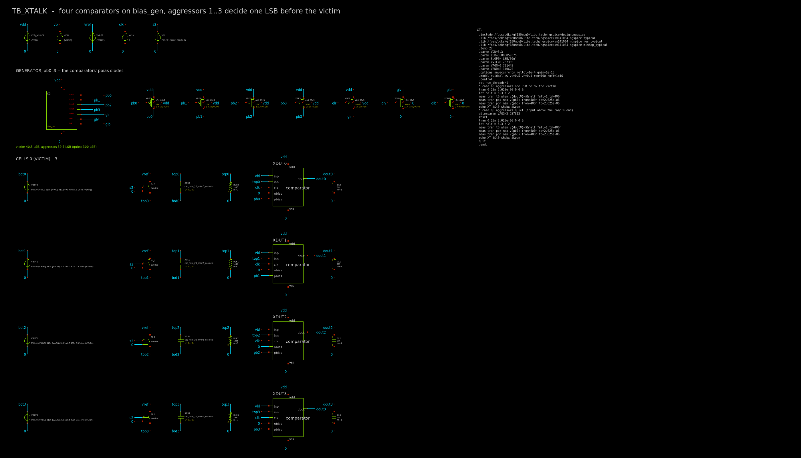
mixed_signal/bias_gen/assets/tb_xtalk.png
