sykeisuke/asic_rd/mixed_signal/cell_trannoise/assets/tb_cell_tn_xschem.png

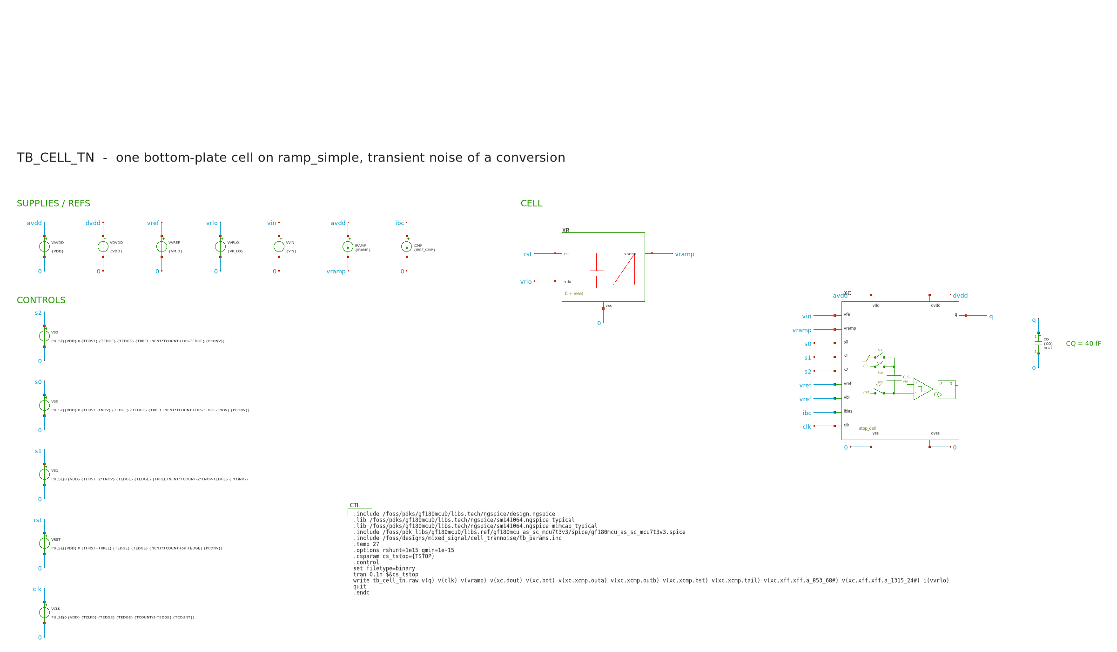
mixed_signal/cell_trannoise/assets/tb_cell_tn_xschem.png
