sykeisuke/asic_rd/mixed_signal/chip_floorplan/assets/chip_floorplan.png

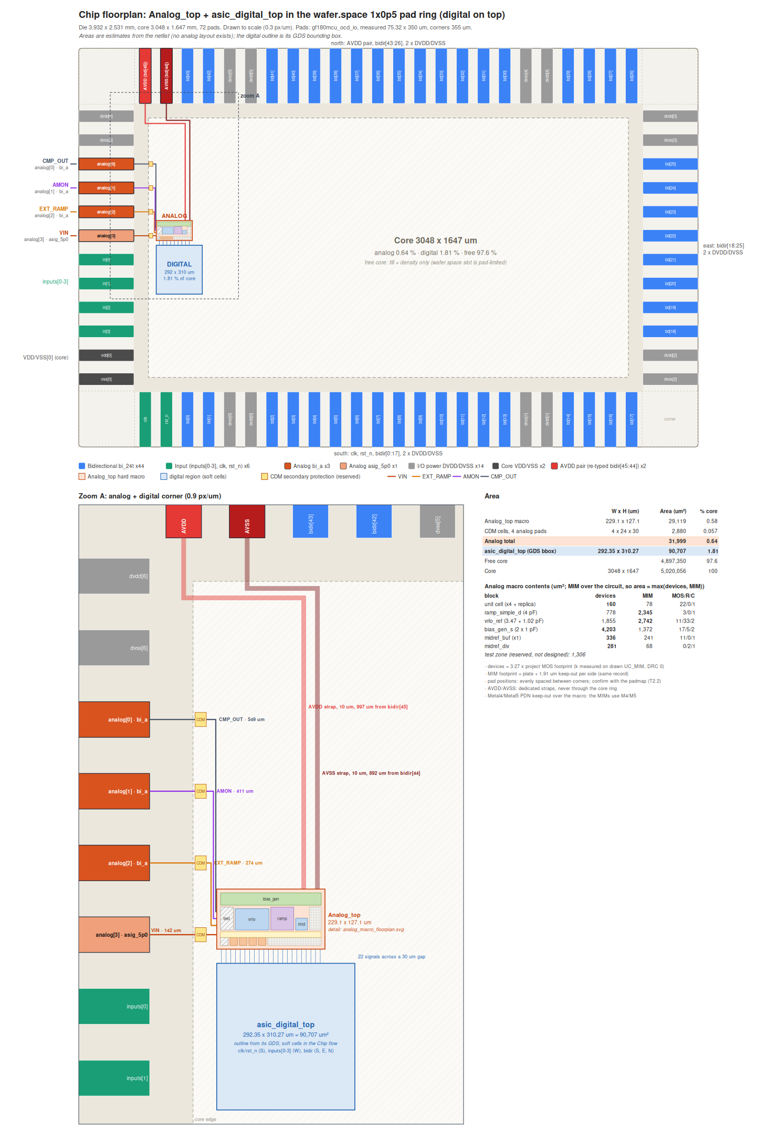
mixed_signal/chip_floorplan/assets/chip_floorplan.png
