sykeisuke/asic_rd/mixed_signal/comparator/assets/comparator_trannoise_psd.png

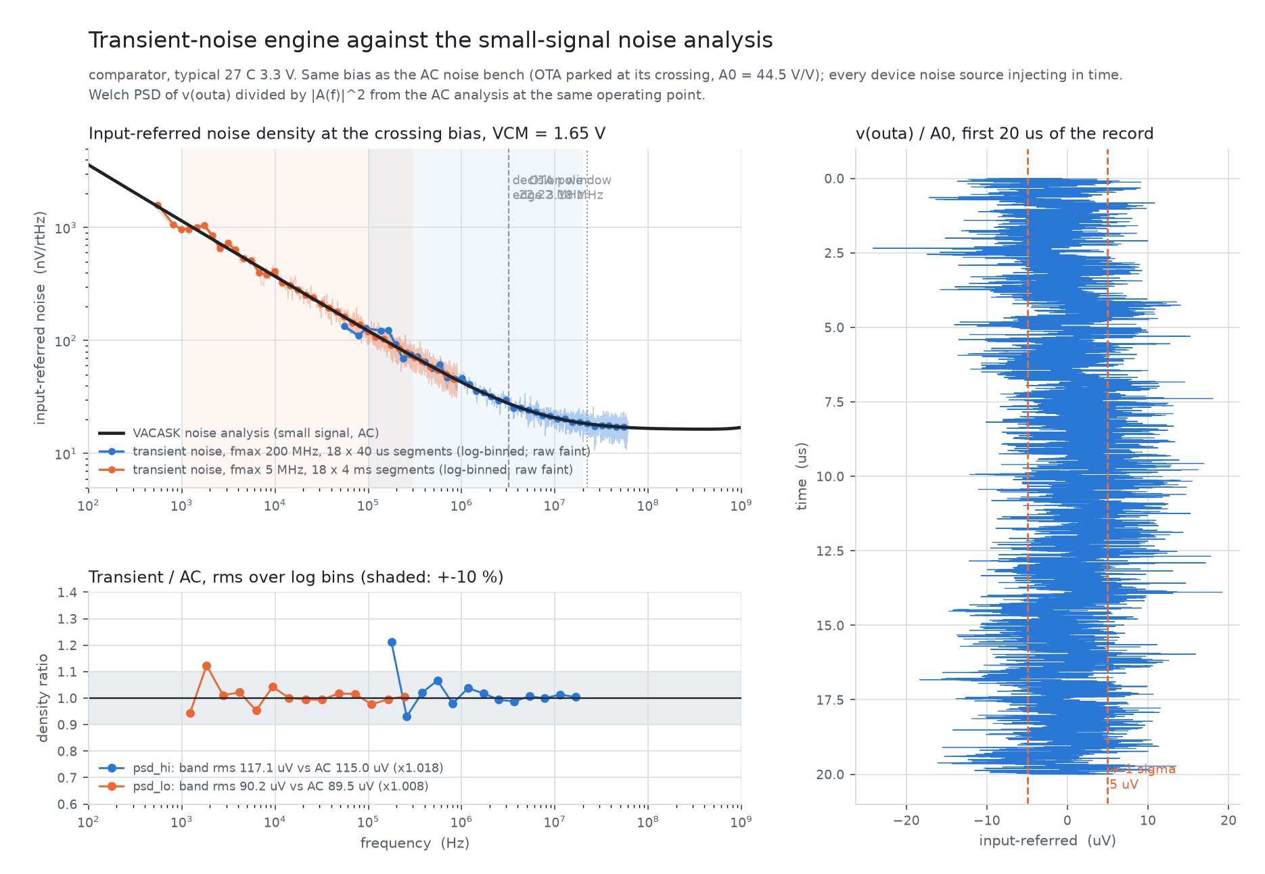
mixed_signal/comparator/assets/comparator_trannoise_psd.png
