sykeisuke/asic_rd/mixed_signal/comparator/assets/comparator_xschem.png

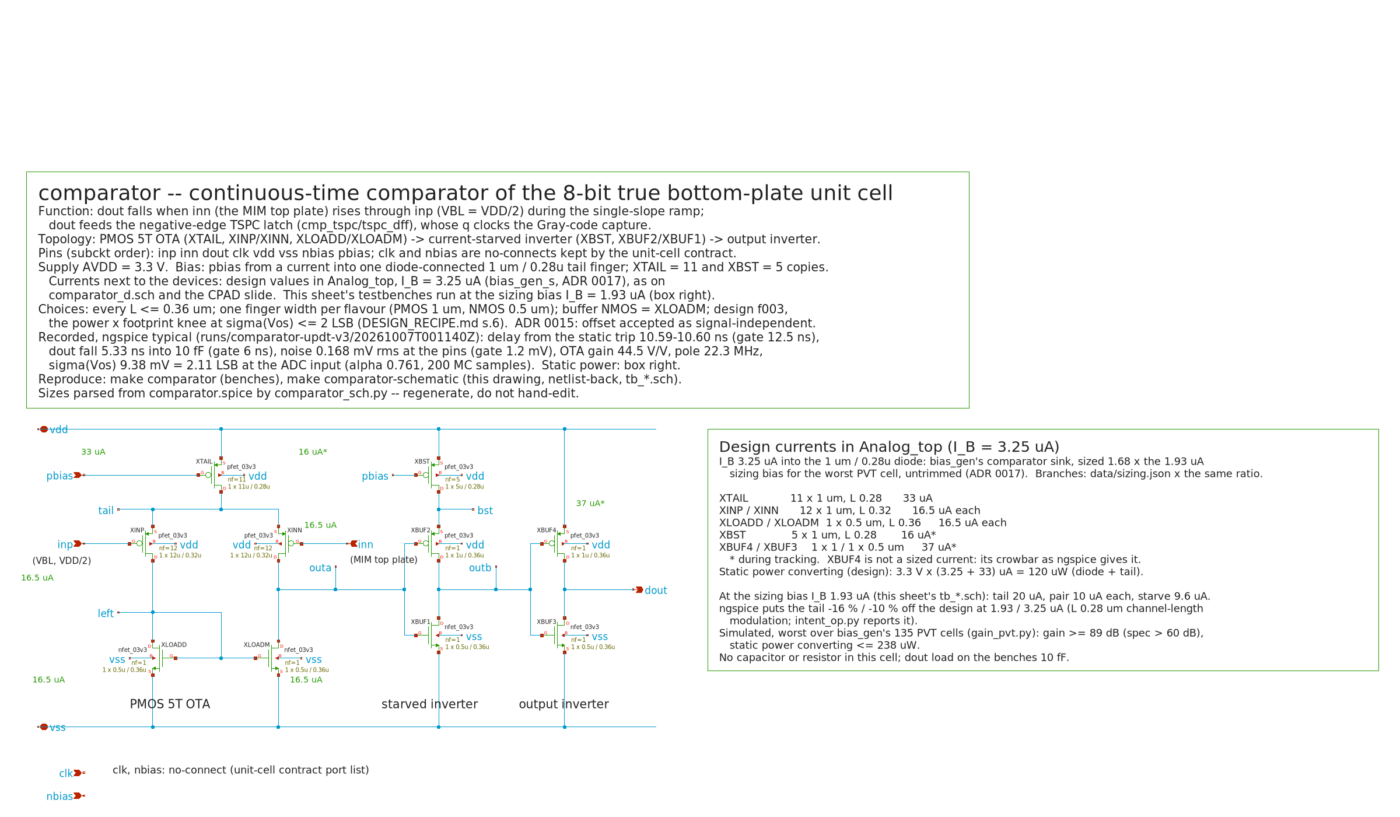
mixed_signal/comparator/assets/comparator_xschem.png
