sykeisuke/asic_rd/mixed_signal/comparator/assets/fig_bias_req.png

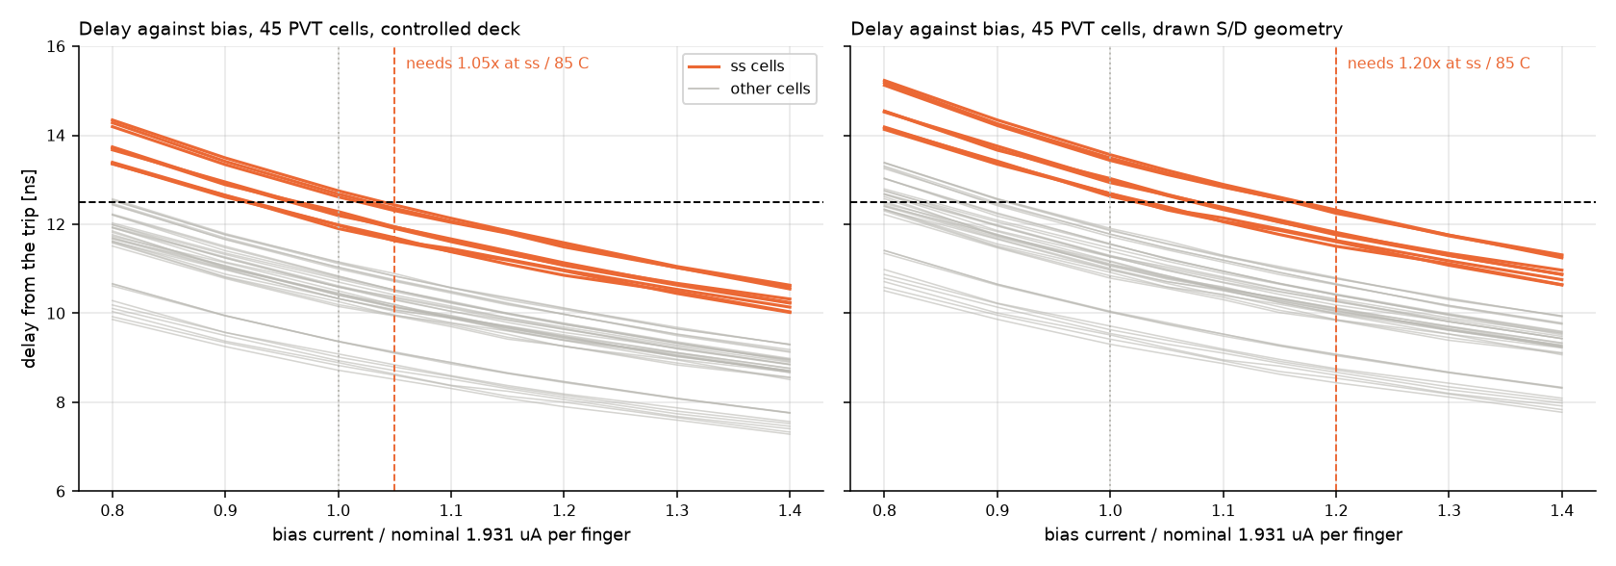
mixed_signal/comparator/assets/fig_bias_req.png
