sykeisuke/asic_rd/mixed_signal/comparator/assets/fig_delay_power.png

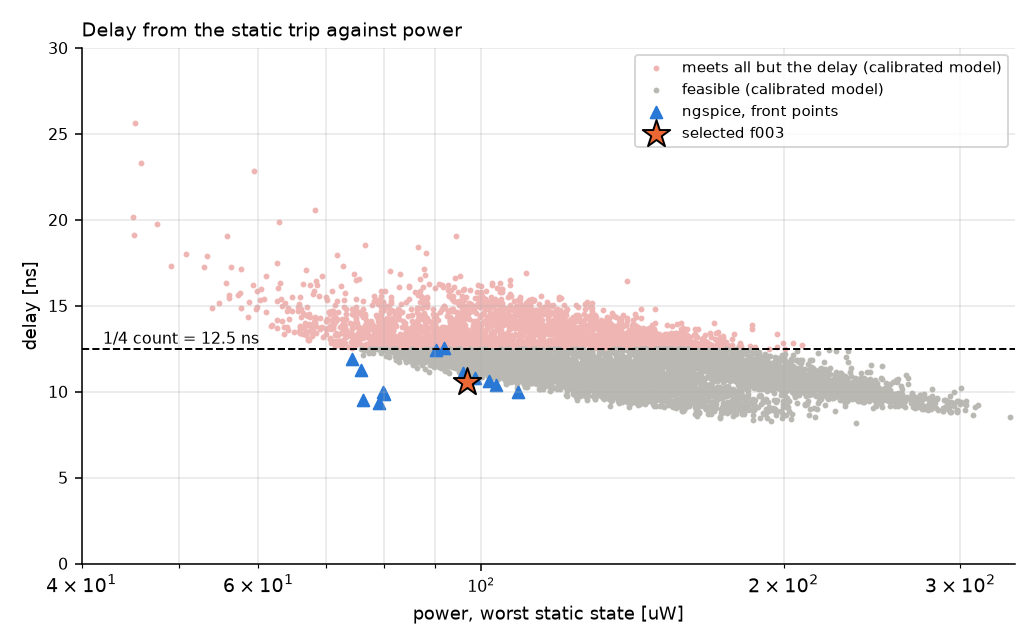
mixed_signal/comparator/assets/fig_delay_power.png
