sykeisuke/asic_rd/mixed_signal/comparator/assets/fig_device_noise.png

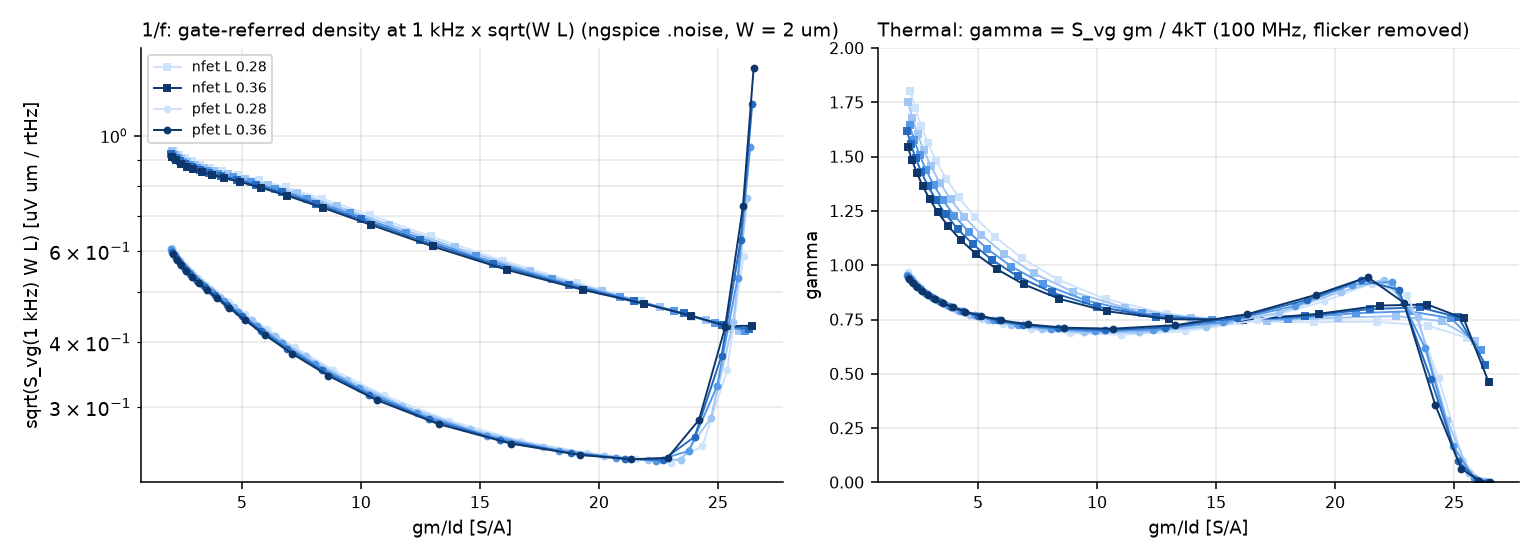
mixed_signal/comparator/assets/fig_device_noise.png
