sykeisuke/asic_rd/mixed_signal/comparator/assets/fig_gmid_sizing.png

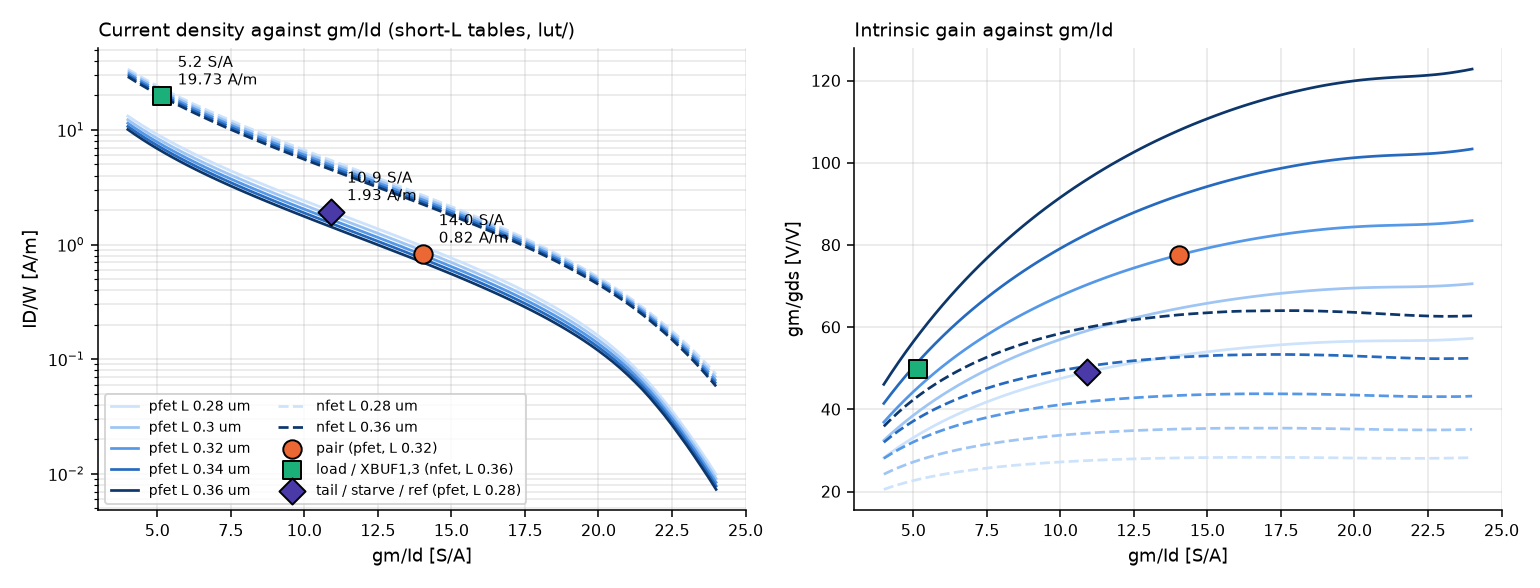
mixed_signal/comparator/assets/fig_gmid_sizing.png
