sykeisuke/asic_rd/mixed_signal/comparator/assets/fig_mc.png

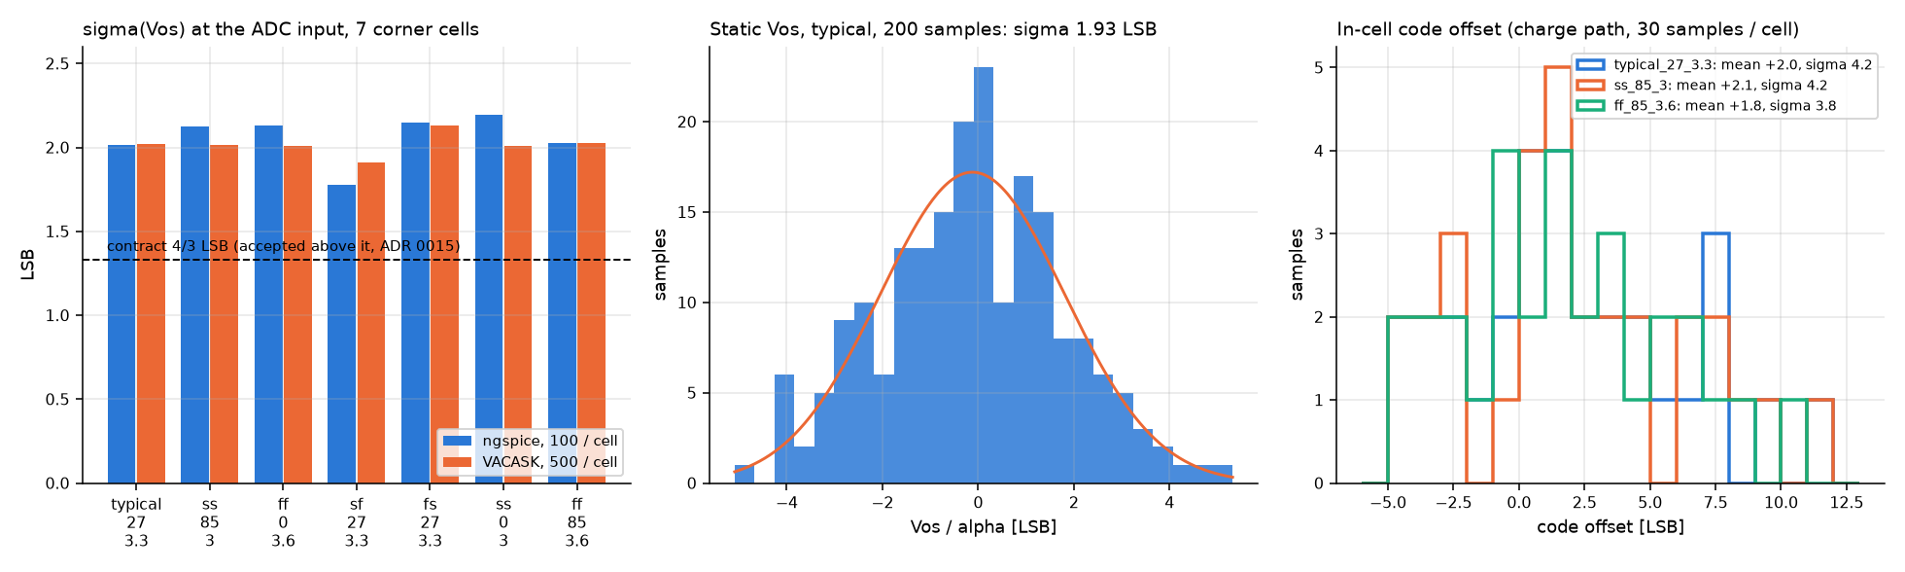
mixed_signal/comparator/assets/fig_mc.png
