sykeisuke/asic_rd/mixed_signal/comparator/assets/fig_offset_lin.png

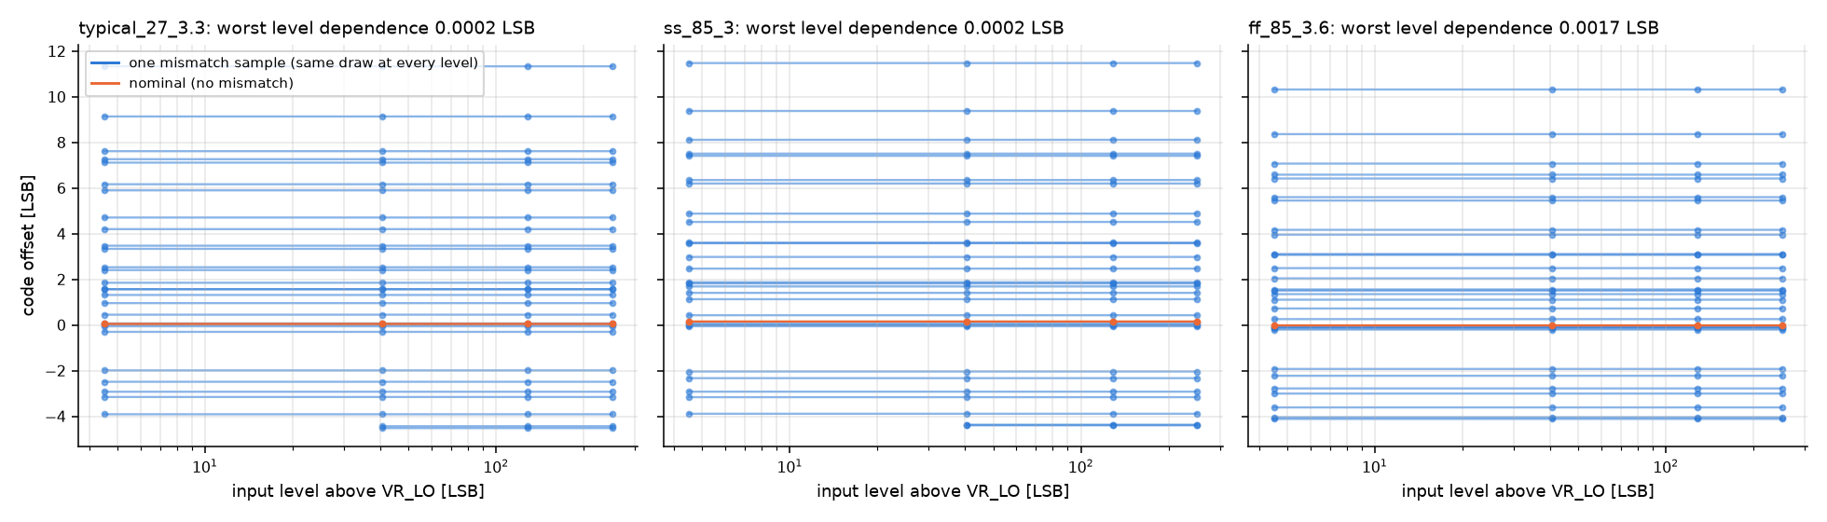
mixed_signal/comparator/assets/fig_offset_lin.png
