sykeisuke/asic_rd/mixed_signal/comparator/assets/pareto_power_area.png

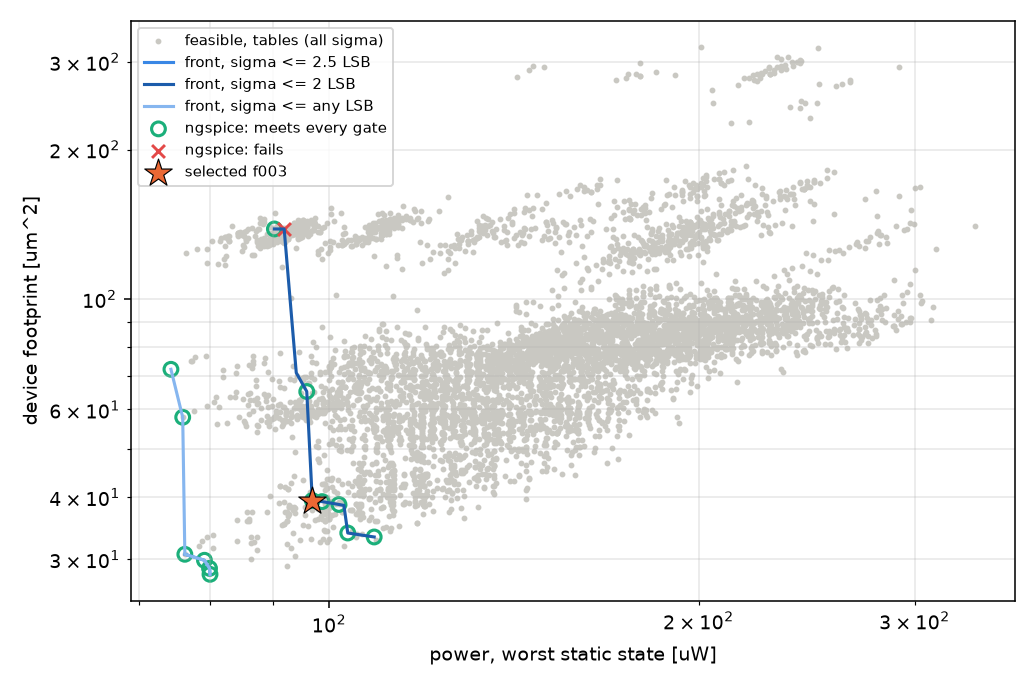
mixed_signal/comparator/assets/pareto_power_area.png
