sykeisuke/asic_rd/mixed_signal/comparator/assets/tb_delay_xschem.png

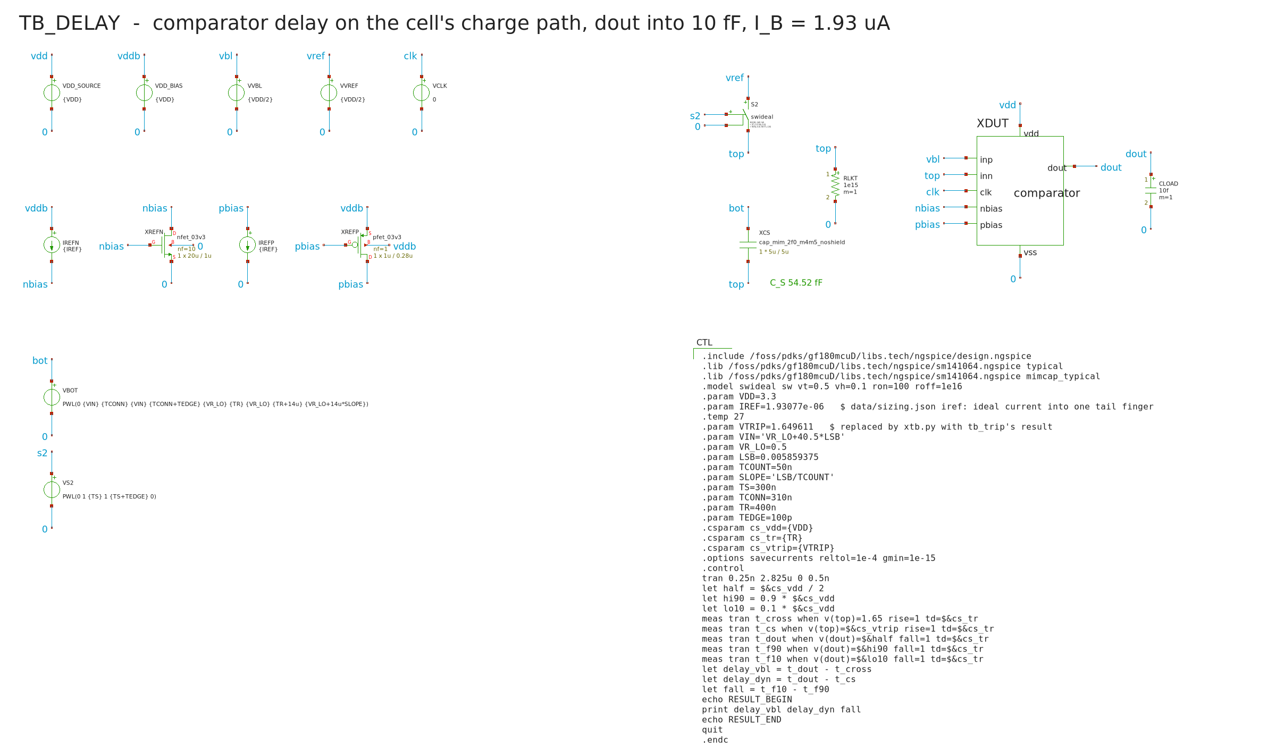
mixed_signal/comparator/assets/tb_delay_xschem.png
