sykeisuke/asic_rd/mixed_signal/comparator/assets/tb_noise_xschem.png

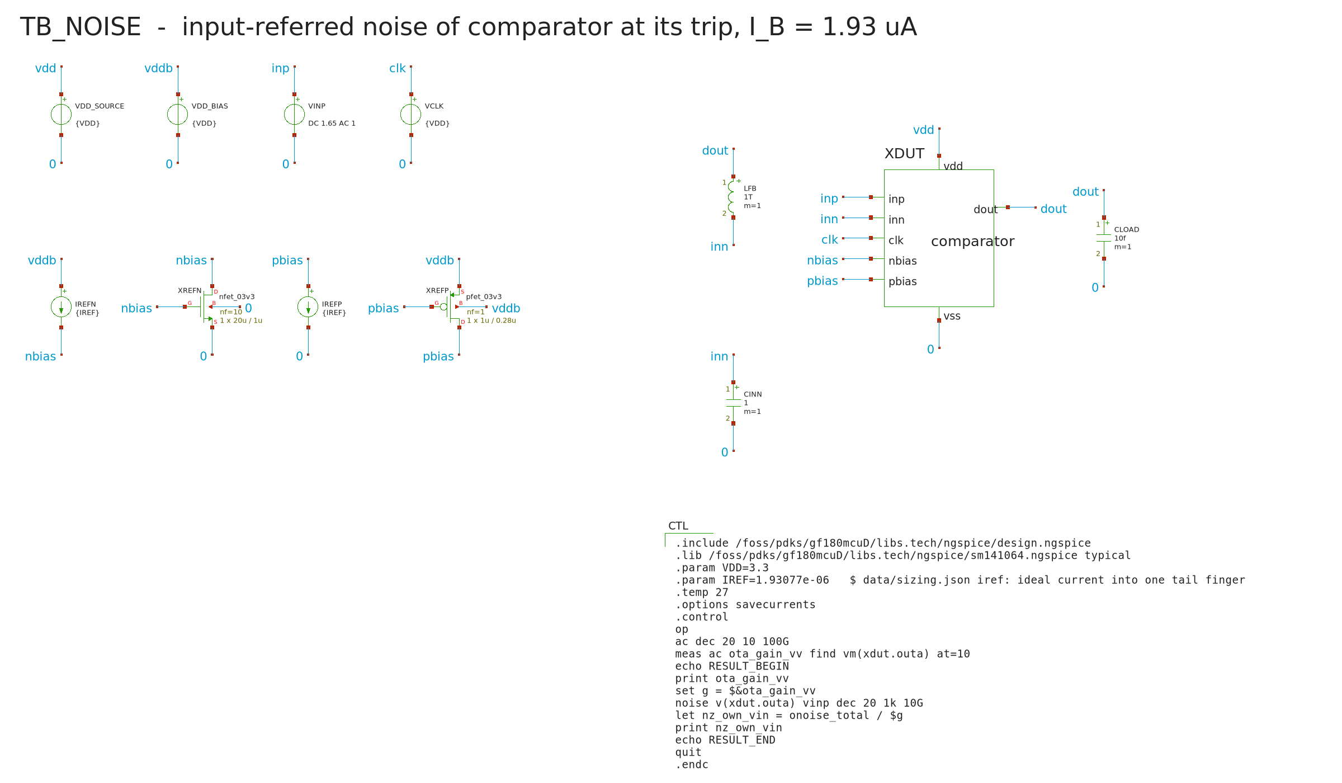
mixed_signal/comparator/assets/tb_noise_xschem.png
