sykeisuke/asic_rd/mixed_signal/comparator/assets/tb_trip_xschem.png

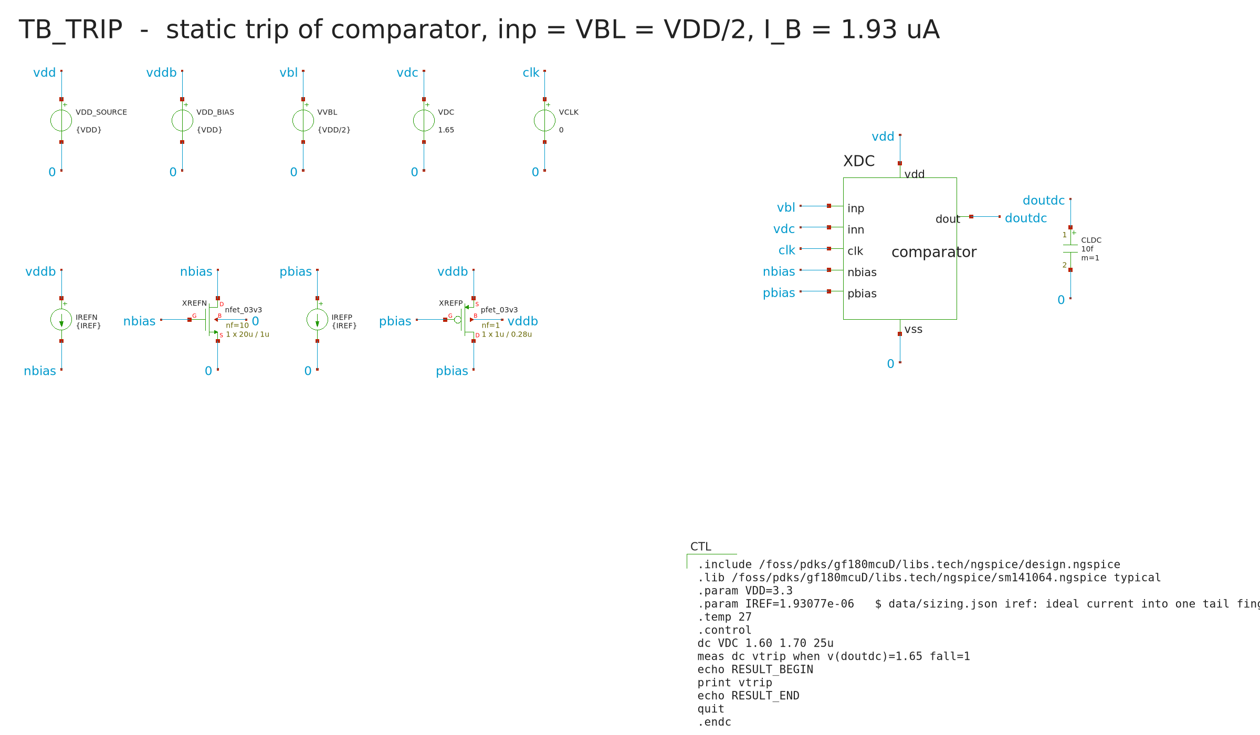
mixed_signal/comparator/assets/tb_trip_xschem.png
