sykeisuke/asic_rd/mixed_signal/ic_source/assets/ic_source_xschem.png

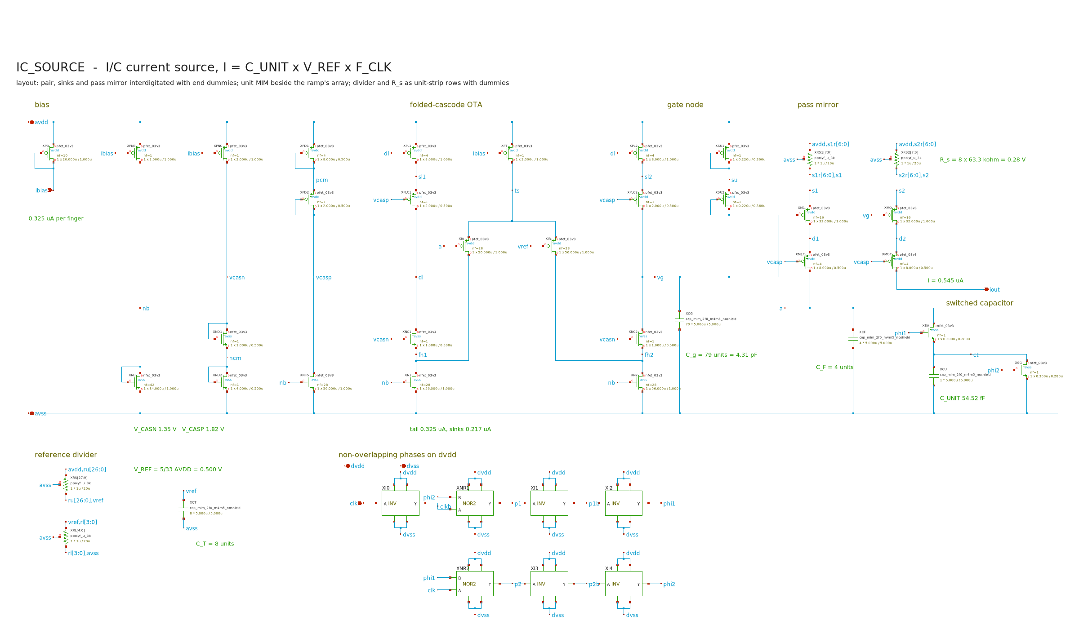
mixed_signal/ic_source/assets/ic_source_xschem.png
