sykeisuke/asic_rd/mixed_signal/ic_source/assets/tb_ic_xschem.png

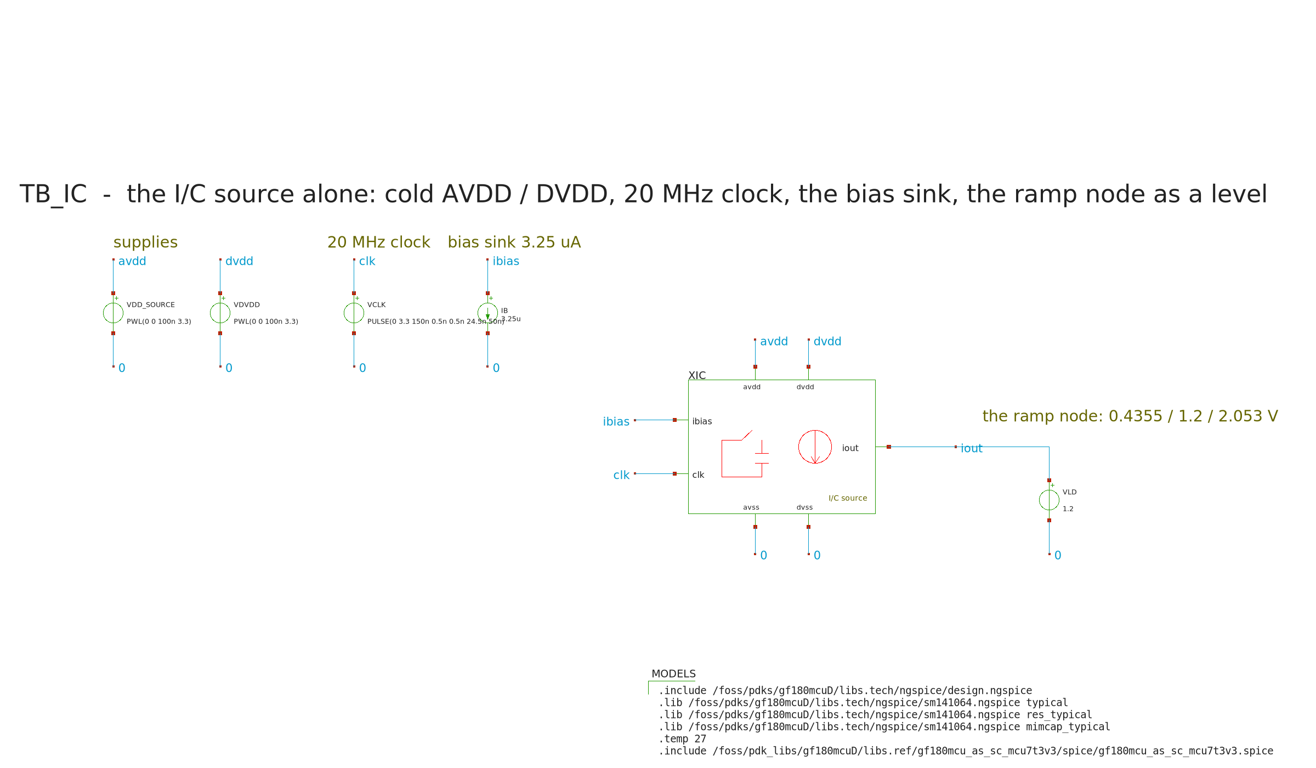
mixed_signal/ic_source/assets/tb_ic_xschem.png
