sykeisuke/asic_rd/mixed_signal/latch/assets/latch_xschem.png

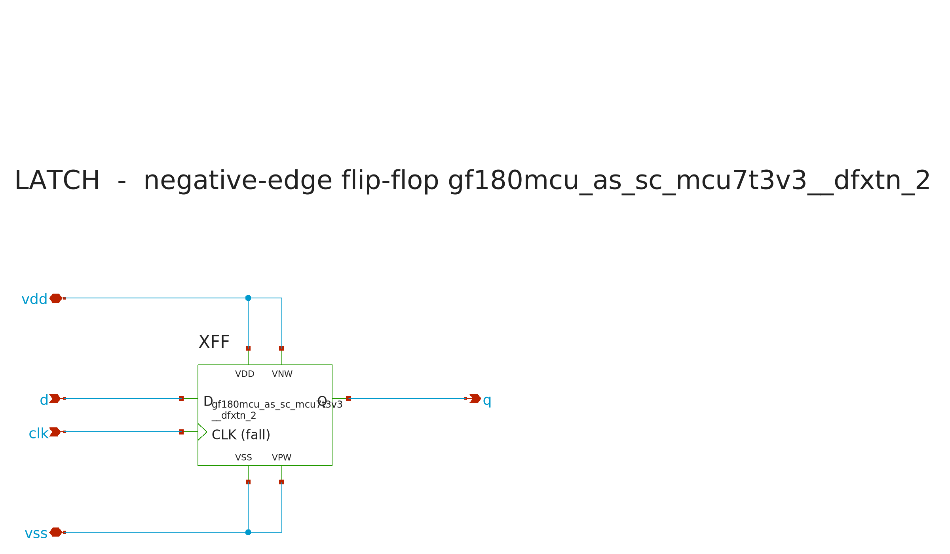
mixed_signal/latch/assets/latch_xschem.png
