sykeisuke/asic_rd/mixed_signal/latch/assets/tb_kick_xschem.png

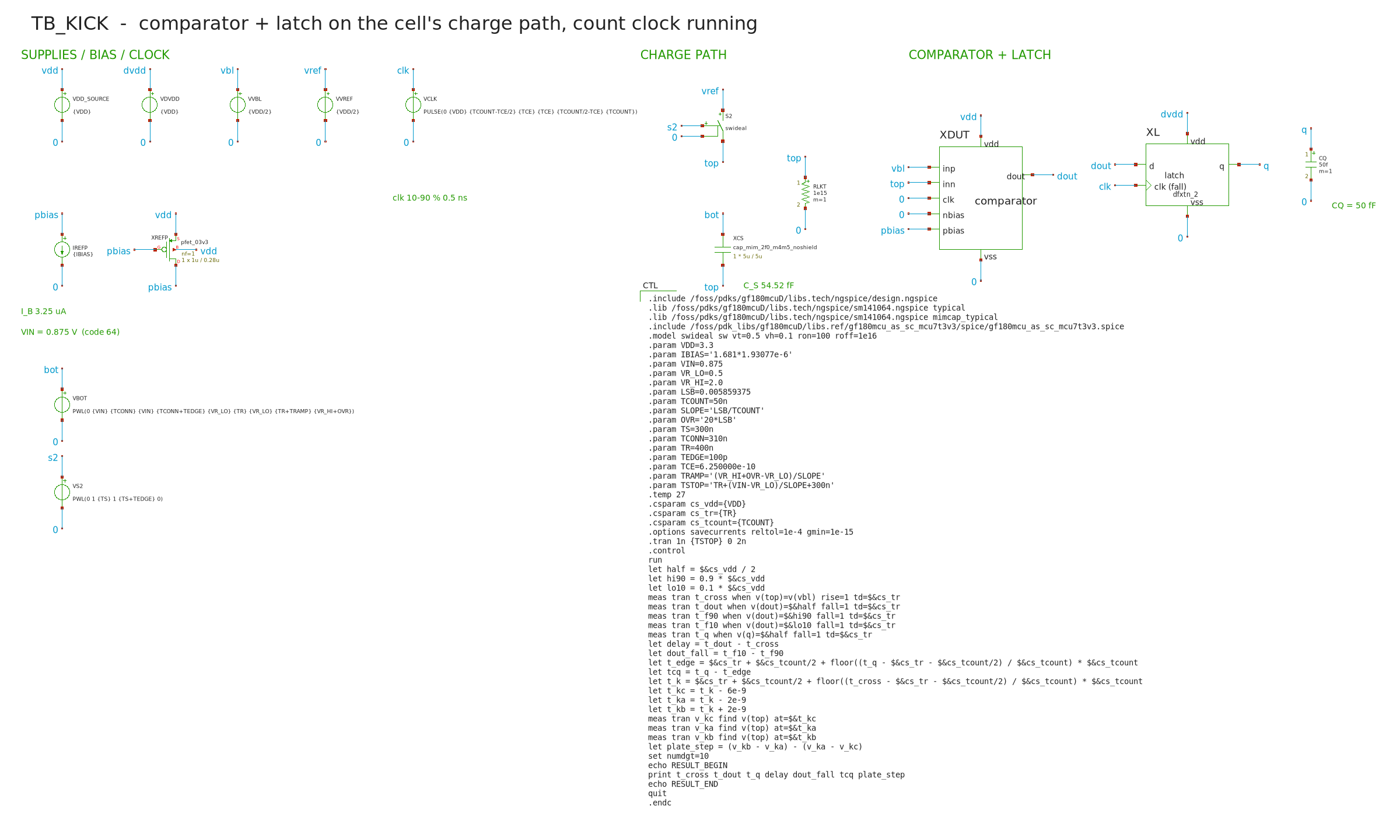
mixed_signal/latch/assets/tb_kick_xschem.png
