sykeisuke/asic_rd/mixed_signal/midrail_ref/assets/tb_cmp.png

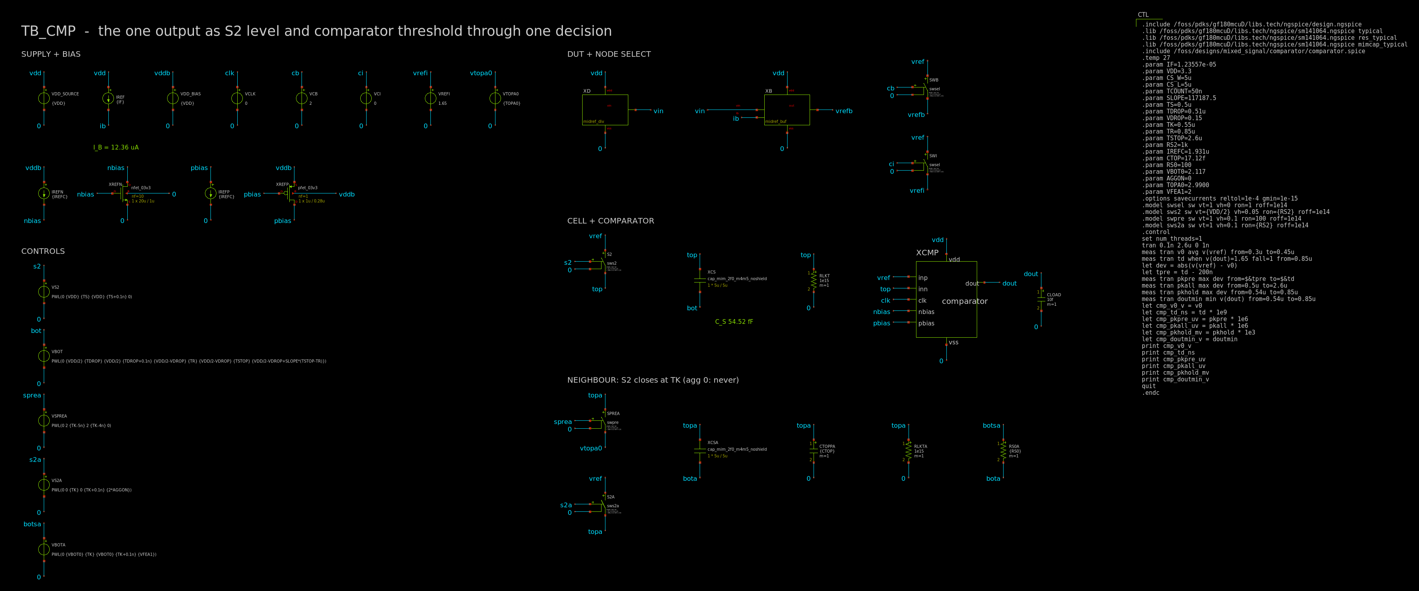
mixed_signal/midrail_ref/assets/tb_cmp.png
