sykeisuke/asic_rd/mixed_signal/midrail_ref/assets/tb_kick.png

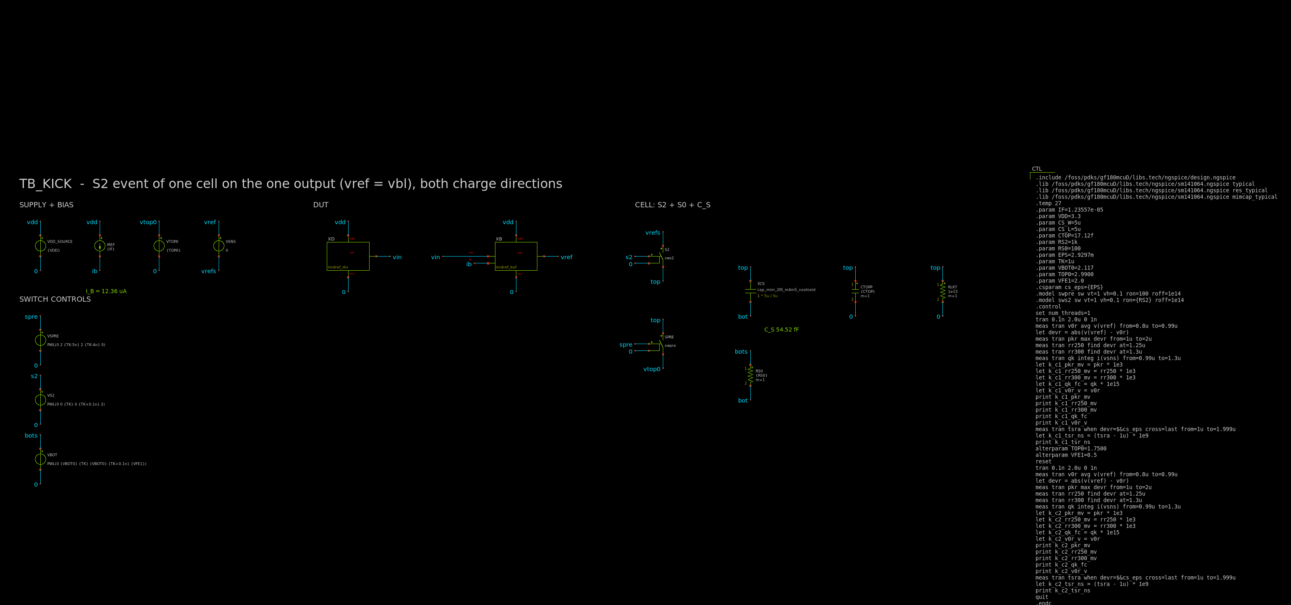
mixed_signal/midrail_ref/assets/tb_kick.png
