sykeisuke/asic_rd/mixed_signal/midrail_ref/assets/tb_noise.png

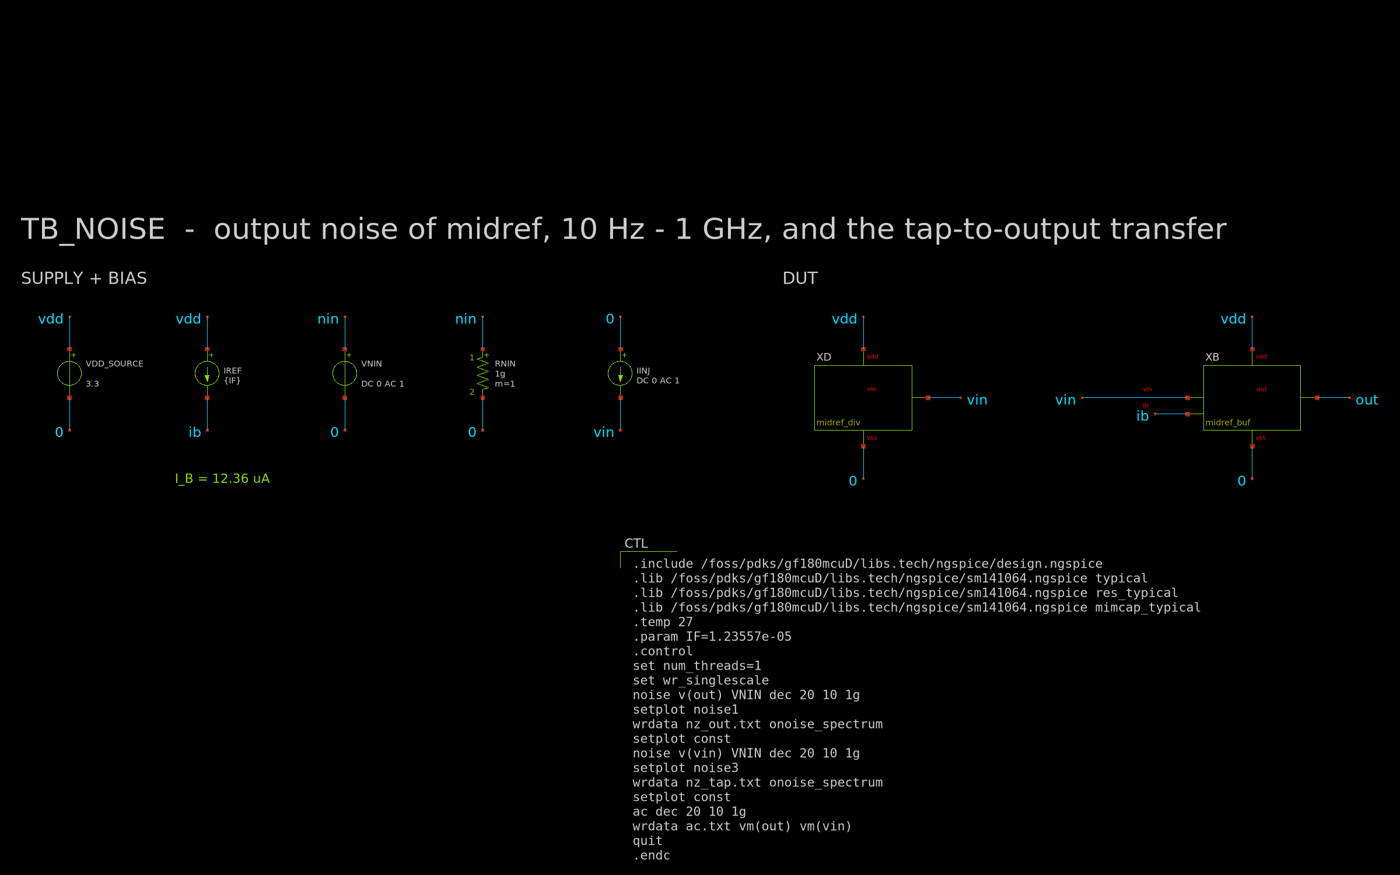
mixed_signal/midrail_ref/assets/tb_noise.png
