sykeisuke/asic_rd/mixed_signal/midrail_ref/assets/tb_op.png

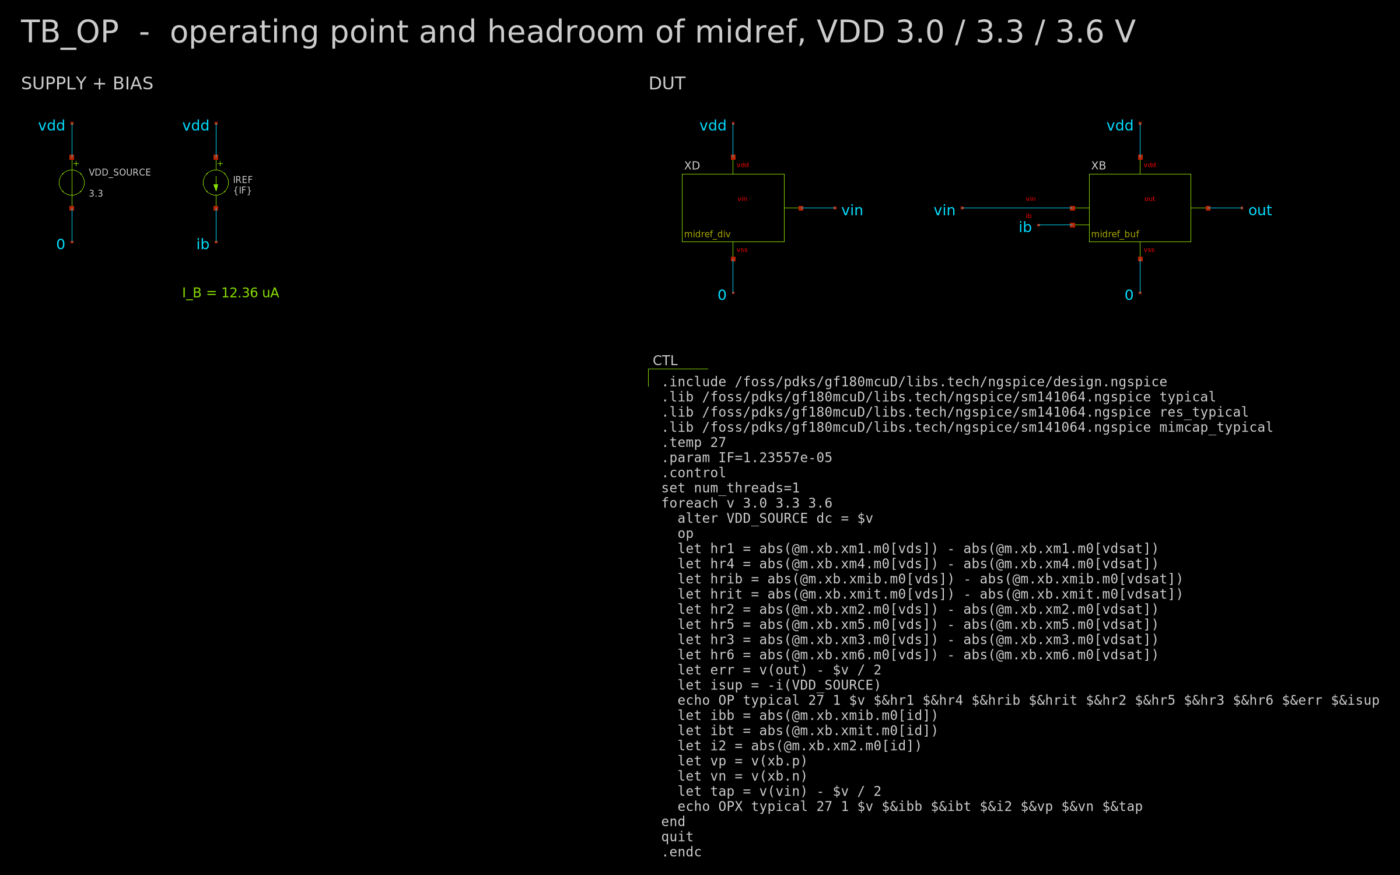
mixed_signal/midrail_ref/assets/tb_op.png
