sykeisuke/asic_rd/mixed_signal/ramp_gen/assets/ramp_adc4_trip.png

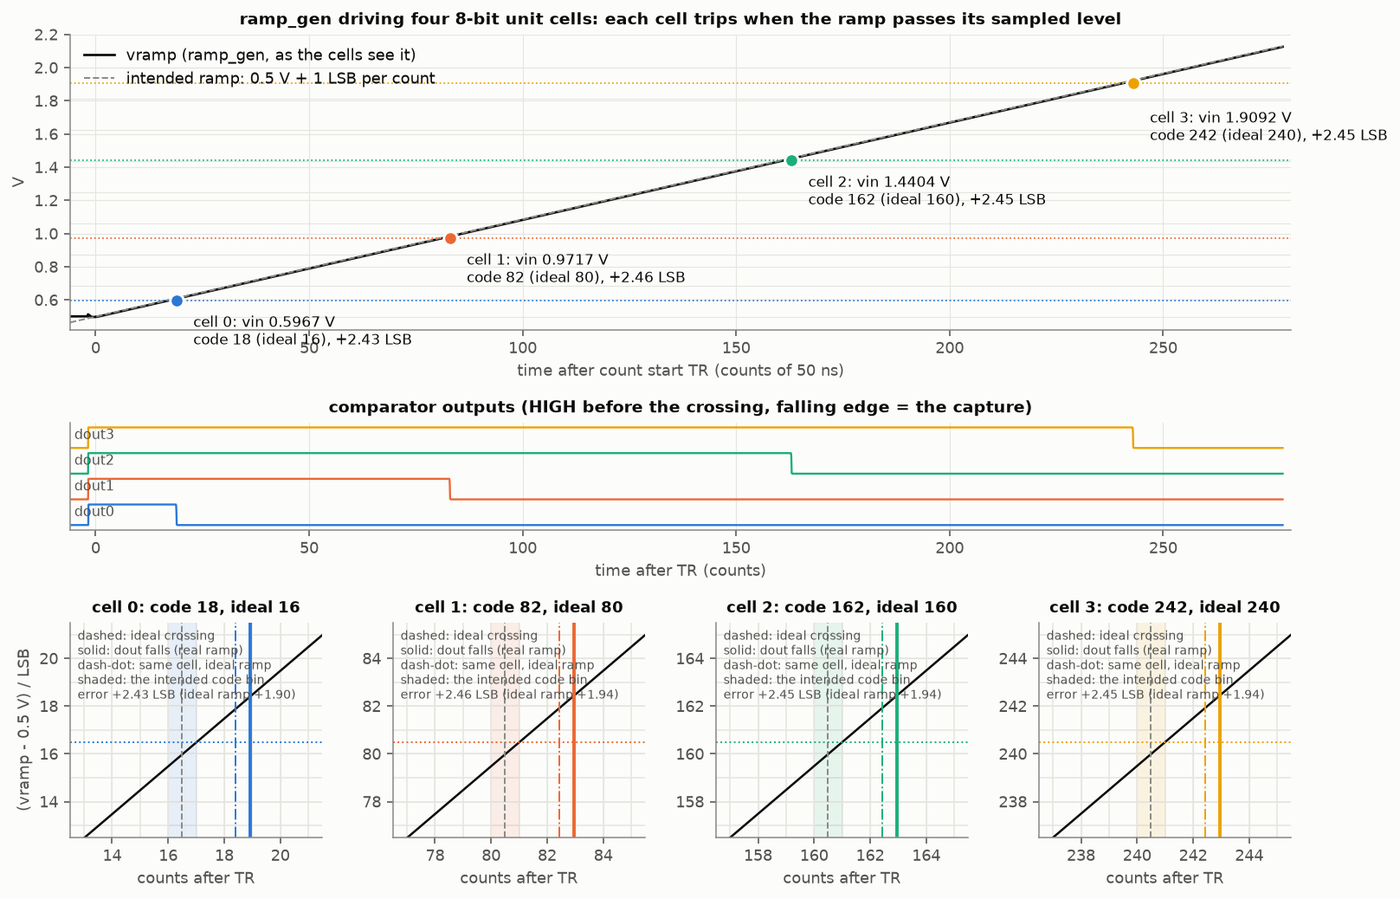
mixed_signal/ramp_gen/assets/ramp_adc4_trip.png
