sykeisuke/asic_rd/mixed_signal/ramp_gen/assets/ramp_compare.png

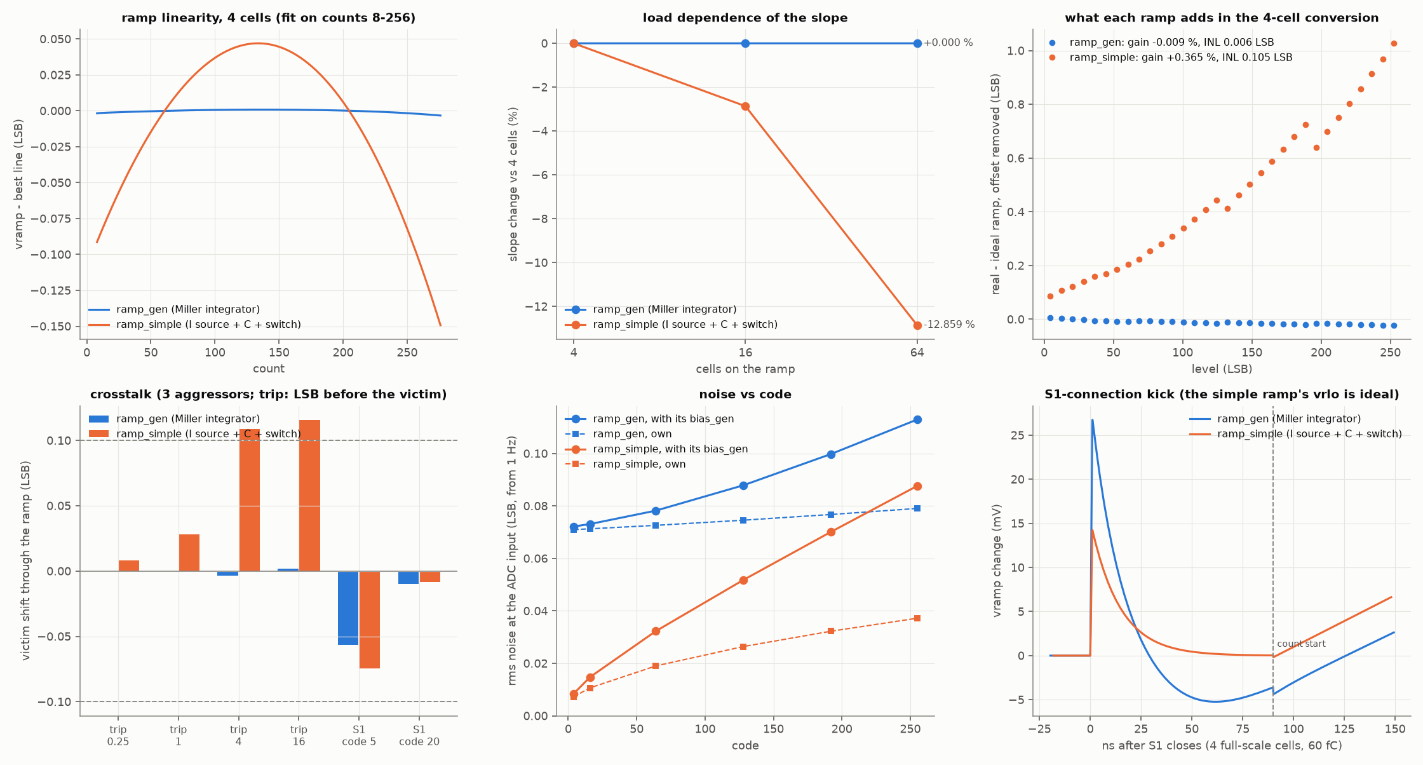
mixed_signal/ramp_gen/assets/ramp_compare.png
