sykeisuke/asic_rd/mixed_signal/ramp_gen/assets/tb_ramp_adc4_xschem.png

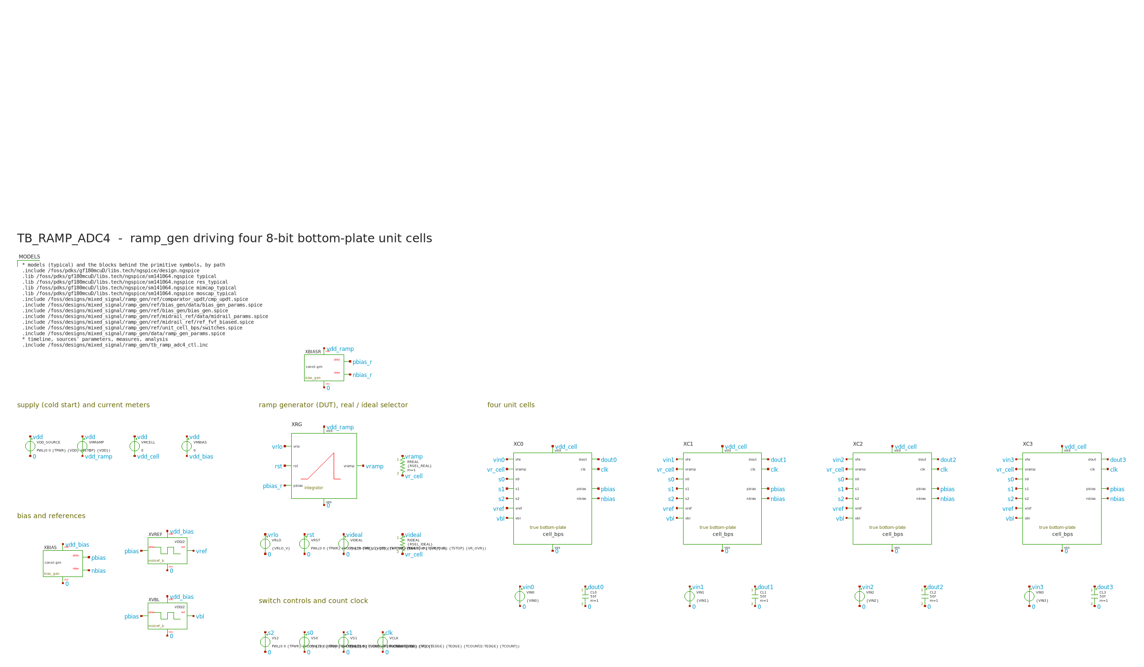
mixed_signal/ramp_gen/assets/tb_ramp_adc4_xschem.png
