sykeisuke/asic_rd/mixed_signal/ramp_gen/assets/tb_ramp_simple_xschem.png

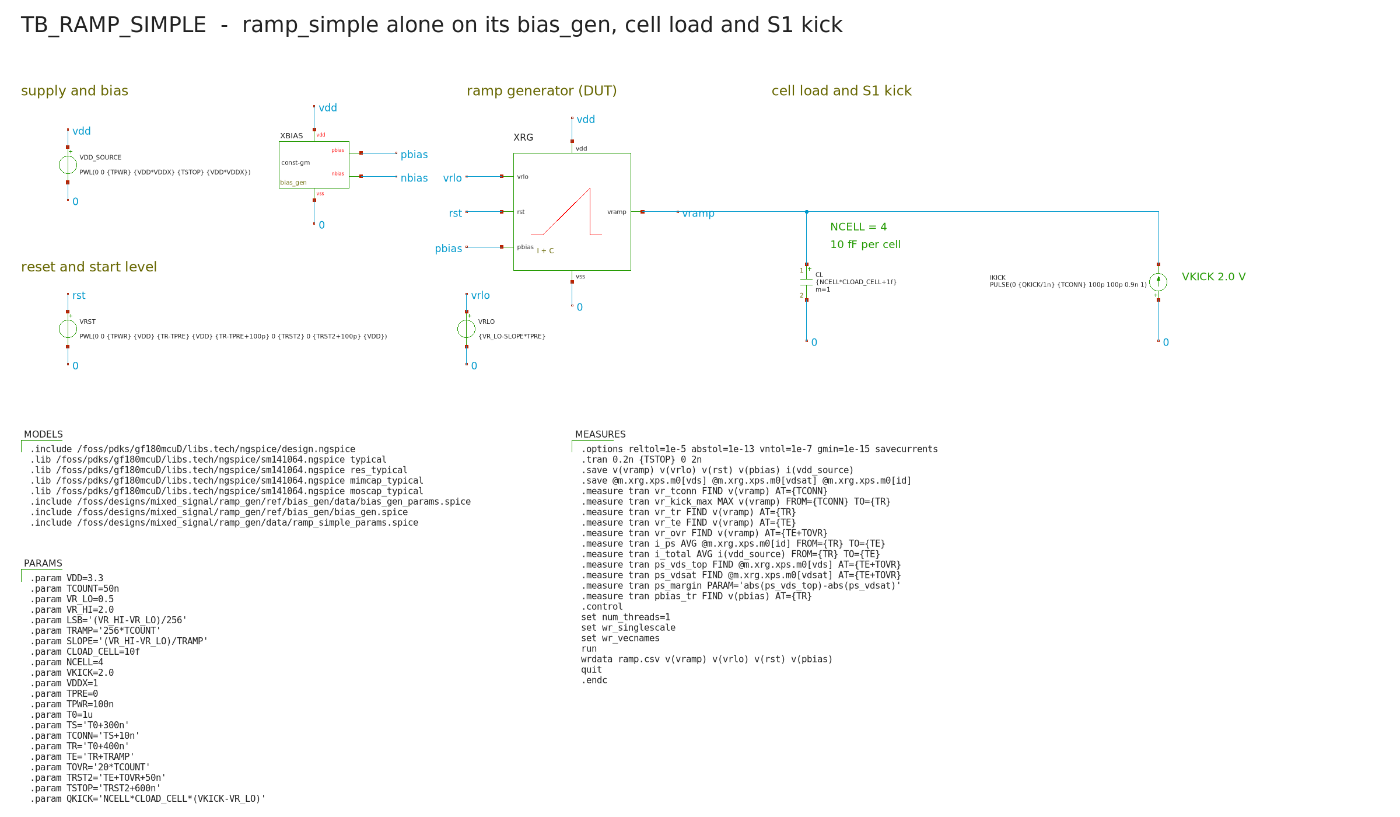
mixed_signal/ramp_gen/assets/tb_ramp_simple_xschem.png
