sykeisuke/asic_rd/mixed_signal/ramp_simple/assets/adc4.png

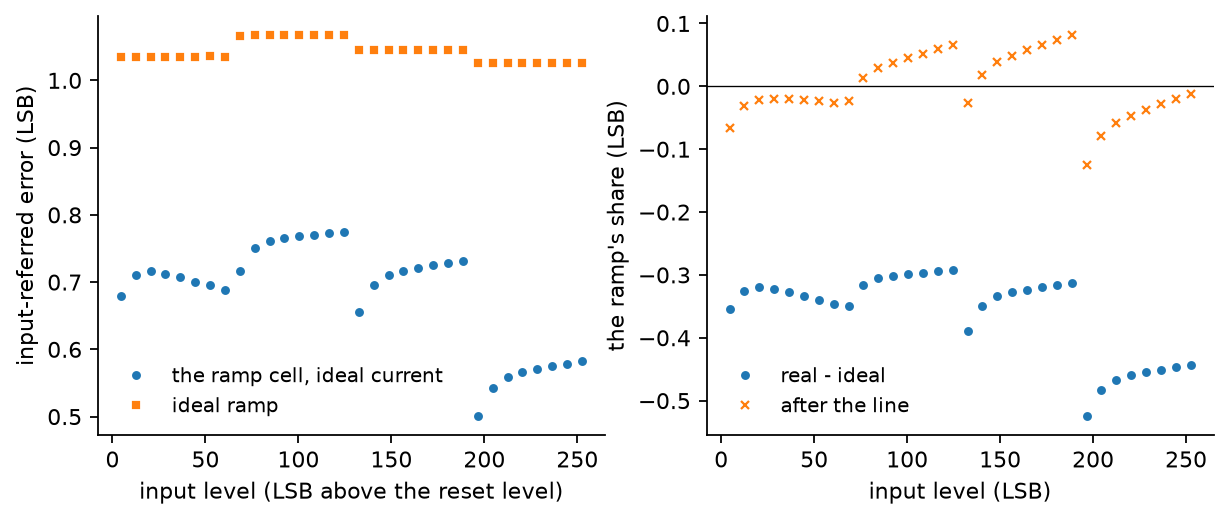
mixed_signal/ramp_simple/assets/adc4.png
