sykeisuke/asic_rd/mixed_signal/sample_seq/assets/sample_seq.png

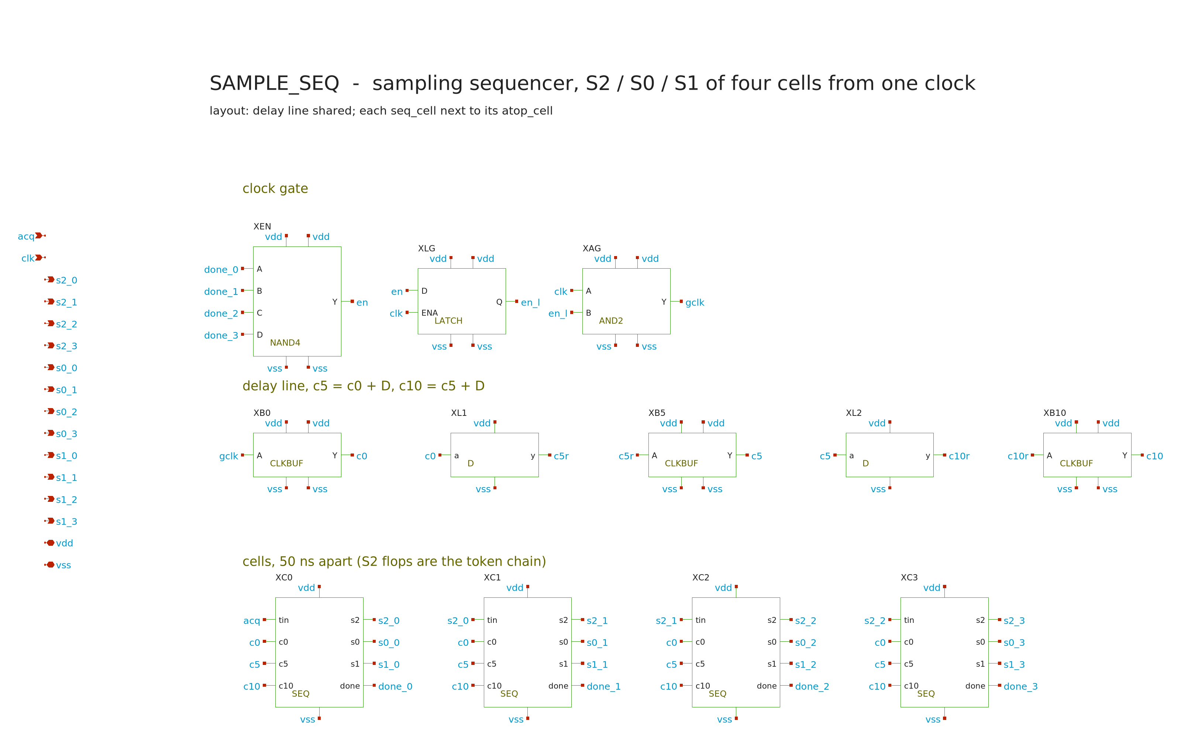
mixed_signal/sample_seq/assets/sample_seq.png
