sykeisuke/asic_rd/mixed_signal/sample_seq/assets/seq_cell.png

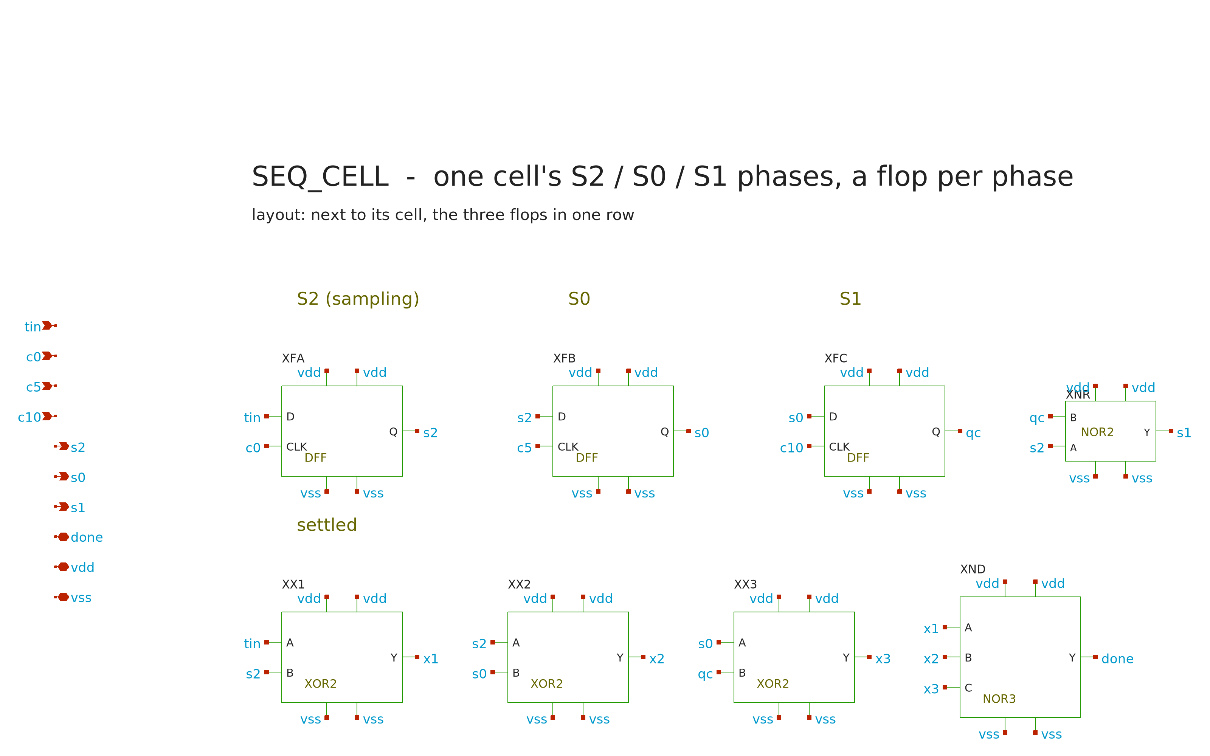
mixed_signal/sample_seq/assets/seq_cell.png
