sykeisuke/asic_rd/mixed_signal/top_placement/physical/final_views/render/chip_top.png

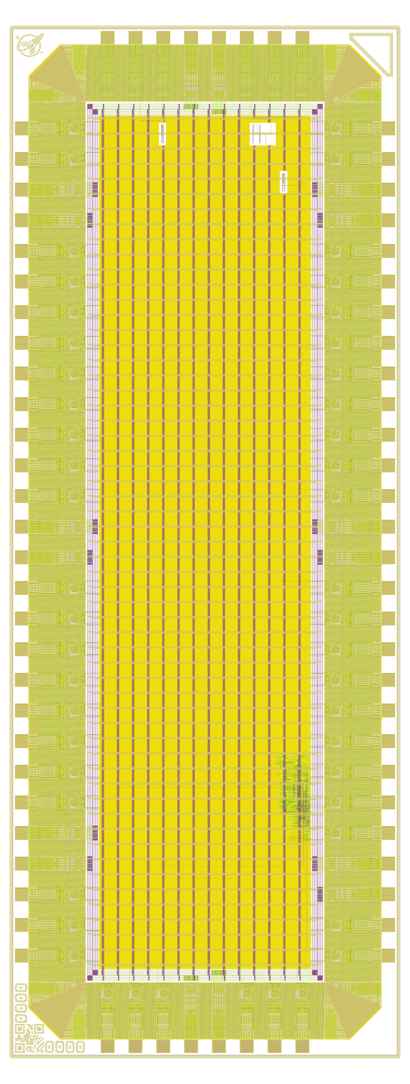
mixed_signal/top_placement/physical/final_views/render/chip_top.png
