sykeisuke/asic_rd/mixed_signal/unit_cell_floorplan/physical/final_views/render/UC_MIM_125.png

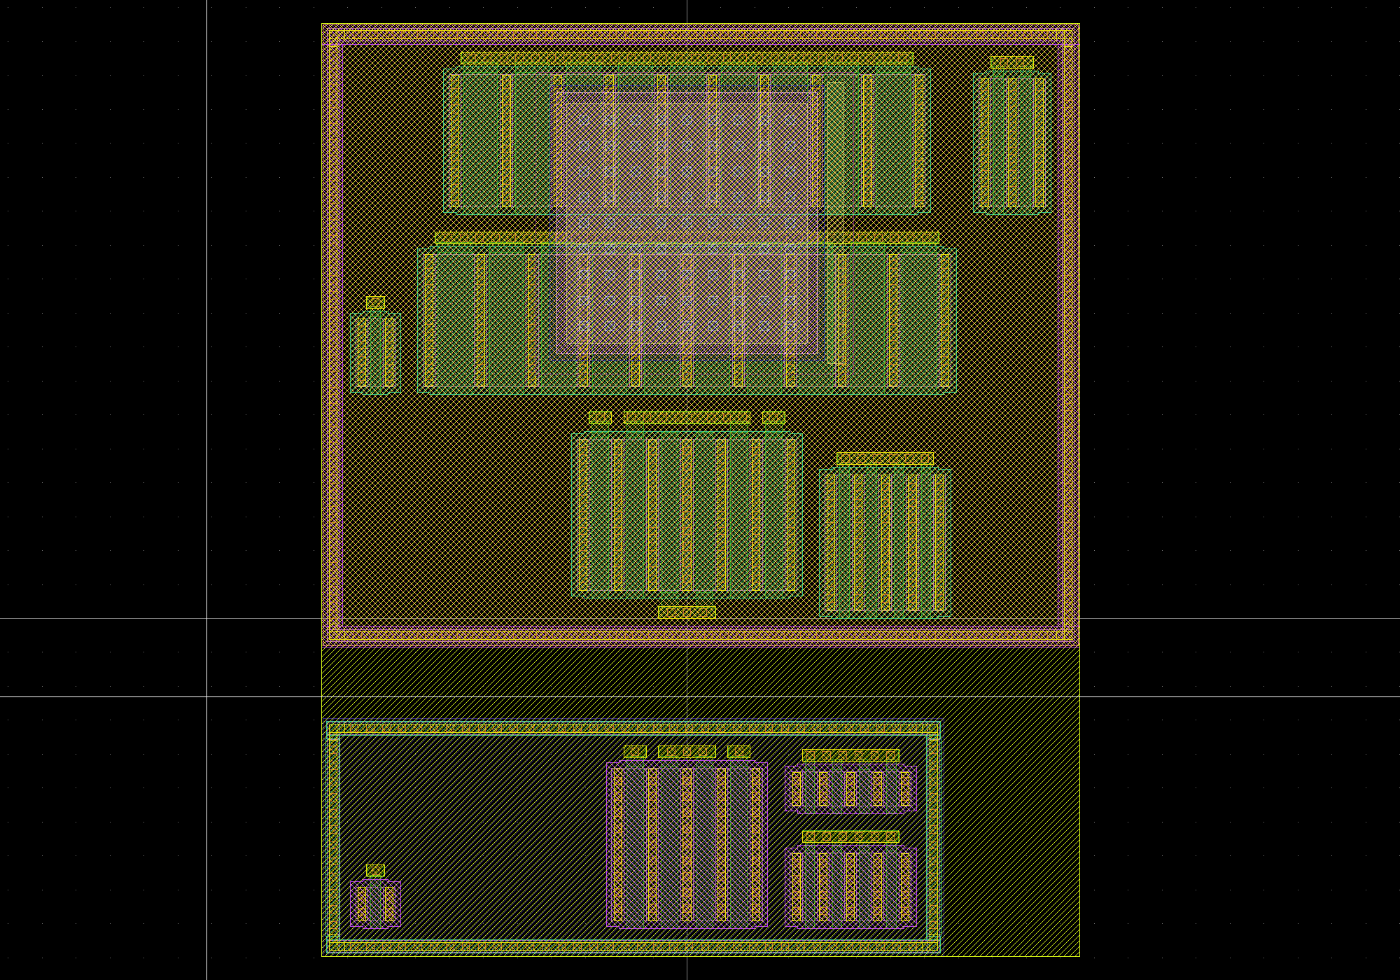
mixed_signal/unit_cell_floorplan/physical/final_views/render/UC_MIM_125.png
