sykeisuke/asic_rd/mixed_signal/vrlo_ref/assets/tb_loop.png

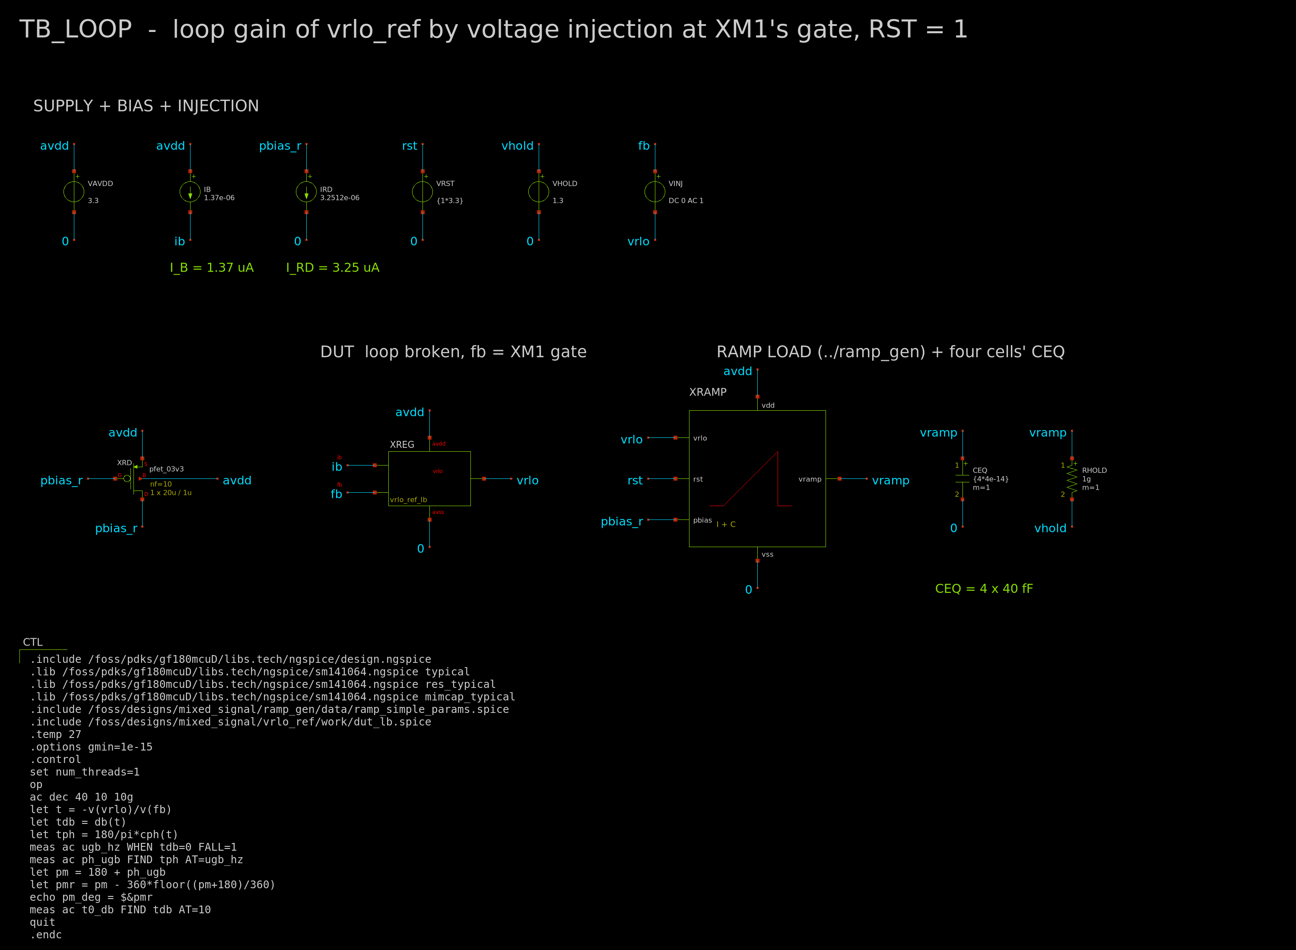
mixed_signal/vrlo_ref/assets/tb_loop.png
