sykeisuke/asic_rd/mixed_signal/vrlo_ref/assets/tb_mc.png

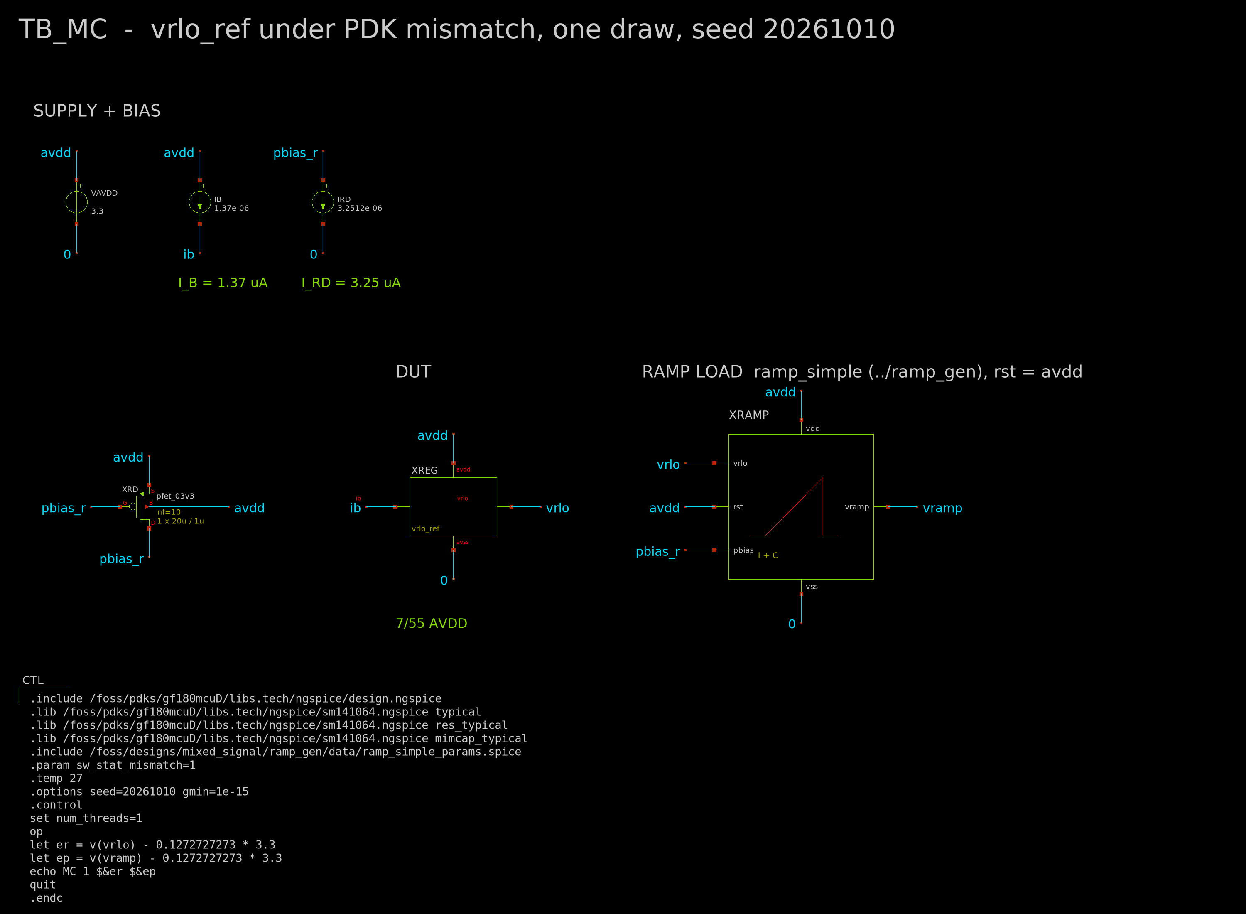
mixed_signal/vrlo_ref/assets/tb_mc.png
