sykeisuke/asic_rd/mixed_signal/vrlo_ref/assets/vrlo_ref.png

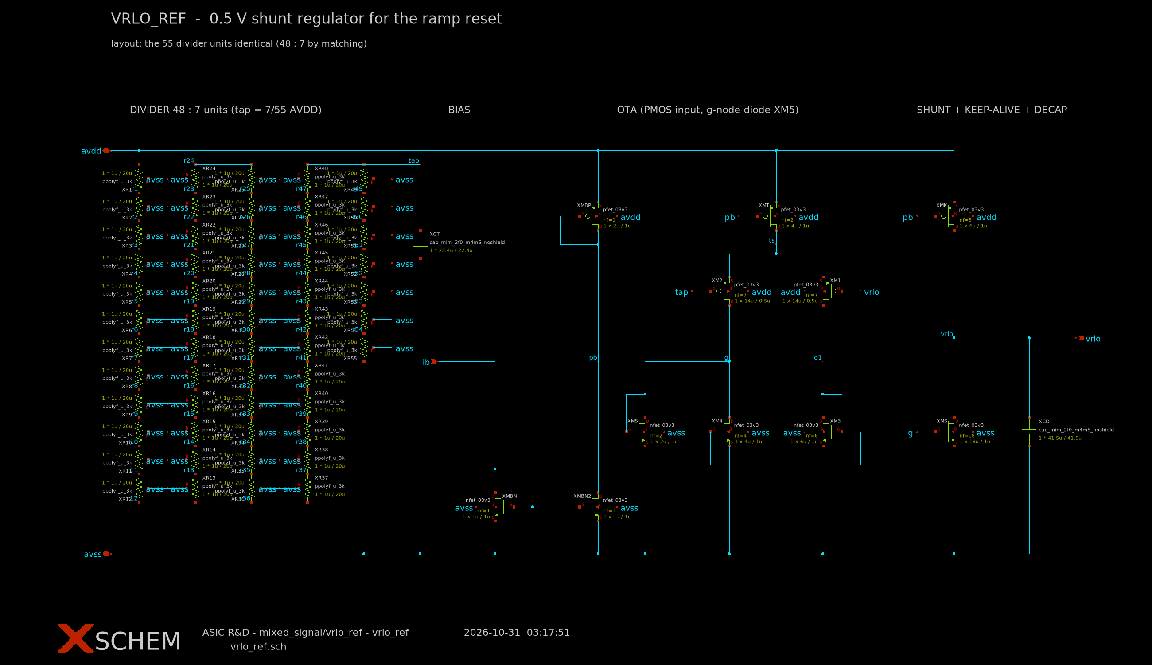
mixed_signal/vrlo_ref/assets/vrlo_ref.png
