sykeisuke/asic_rd/chip_integration/renders/02_chip_top_wiring.png

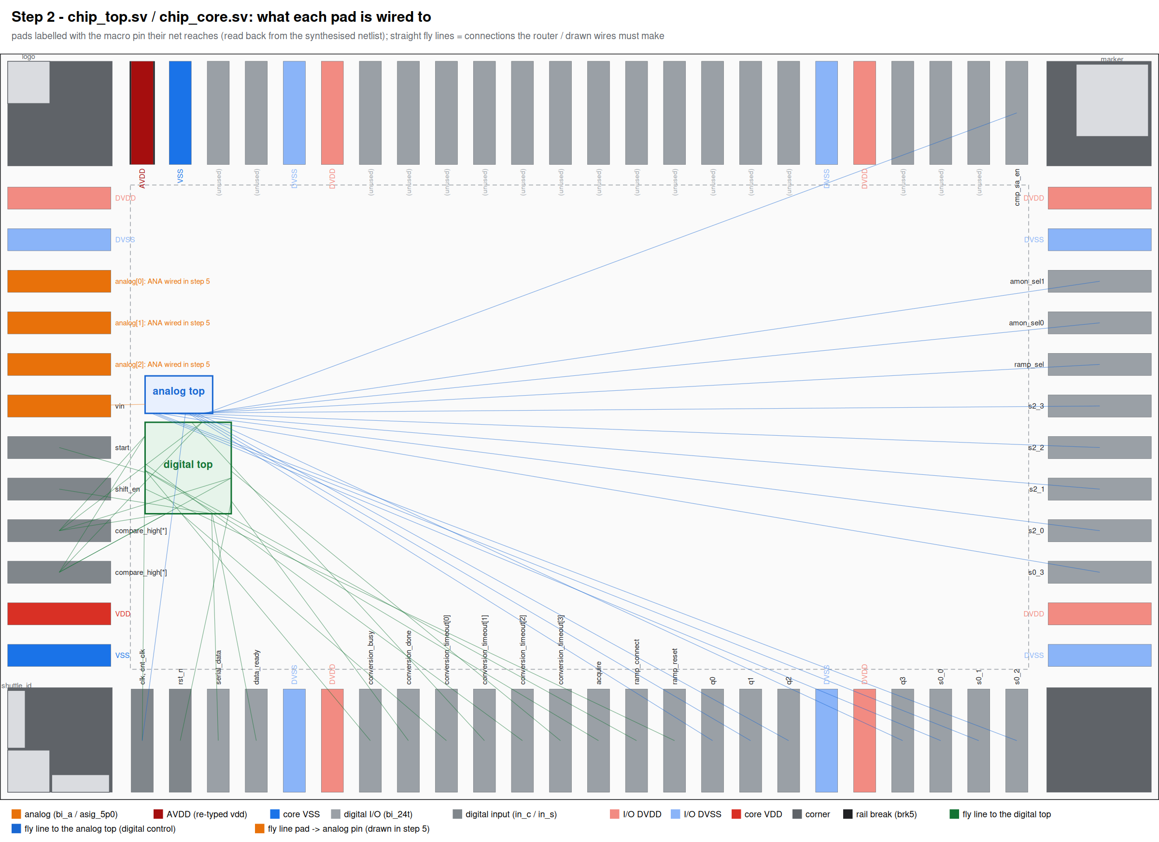
chip_integration/renders/02_chip_top_wiring.png
