sykeisuke/asic_rd/digital/asic_digital_top/RESULTS.md

# Digital top synthesis and timing results

Date: 2026-10-28 (Analog_top interface, synchronous capture; the
2026-09-18 asynchronous-capture top mapped to 625 cells / 19963.1 um^2 at
5 V, the 2026-08-11 6-bit sequential top to 415 cells / 12896.8 um^2)

Functional simulation runs the sampling sequence, converts four cells in
parallel (comparators deciding in counts 16, 20, 27, 200), stores the codes
and reconstructs the packed 32-bit word through the serial output; the
testbench models the cells' negative-edge latches.

| Metric | Result |
| --- | ---: |
| Total mapped cells (`gf180mcu_as_sc_mcu7t3v3`) | 585 (148 of them `dlybuff_2` delay stages) |
| Total Liberty area | 19139.9 um^2 |
| Target conversion clock | 20 MHz |
| Estimated minimum conversion-clock period | 2.40 ns |
| Total negative slack | 0.00 ns |

Single clock; `q[3:0]` are synchronous data inputs (latched in the analog
cell on the falling edge, half a period of margin).
