sykeisuke/asic_rd/mixed_signal/bias_gen/data/verify_cmp.csv

corner | temp | rcorner | vdd | delay_c4 | delay_plat | fall | p_avg
typical | 0 | res_typical | 3 | 8.9177e-09 | 8.919e-09 | 4.391e-09 | 8.218e-05
typical | 0 | res_typical | 3.3 | 8.703e-09 | 8.704e-09 | 5.099e-09 | 0.00010097
typical | 0 | res_typical | 3.6 | 8.5048e-09 | 8.504e-09 | 5.945e-09 | 0.000123764
typical | 0 | res_ss | 3 | 9.8936e-09 | 9.893e-09 | 4.308e-09 | 6.80844e-05
typical | 0 | res_ss | 3.3 | 9.5852e-09 | 9.585e-09 | 4.977e-09 | 8.39327e-05
typical | 0 | res_ss | 3.6 | 9.285e-09 | 9.285e-09 | 5.802e-09 | 0.000103422
typical | 0 | res_ff | 3 | 7.9369e-09 | 7.937e-09 | 4.552e-09 | 0.000103178
typical | 0 | res_ff | 3.3 | 7.752e-09 | 7.751e-09 | 5.28e-09 | 0.000126291
typical | 0 | res_ff | 3.6 | 7.5755e-09 | 7.576e-09 | 6.17e-09 | 0.000153978
typical | 27 | res_typical | 3 | 8.7962e-09 | 8.797e-09 | 4.922e-09 | 9.07657e-05
typical | 27 | res_typical | 3.3 | 8.5919e-09 | 8.592e-09 | 5.711e-09 | 0.000111059
typical | 27 | res_typical | 3.6 | 8.3412e-09 | 8.341e-09 | 6.634e-09 | 0.000135978
typical | 27 | res_ss | 3 | 9.6195e-09 | 9.618e-09 | 4.805e-09 | 7.5446e-05
typical | 27 | res_ss | 3.3 | 9.4179e-09 | 9.417e-09 | 5.557e-09 | 9.26351e-05
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
