sykeisuke/asic_rd/mixed_signal/bias_gen/data/verify_mc.csv

k | icmp0 | icmp1 | icmp2 | icmp3 | iramp | ivref | ivbl | icore
0 | 3.24529e-06 | 3.24529e-06 | 3.24529e-06 | 3.24529e-06 | 3.25653e-06 | 1.11651e-05 | 1.11651e-05 | 3.5772e-06
1 | 2.8837e-06 | 2.92376e-06 | 2.80844e-06 | 2.81801e-06 | 2.97326e-06 | 1.03633e-05 | 1.02354e-05 | 3.30056e-06
2 | 3.07397e-06 | 2.98129e-06 | 2.96095e-06 | 2.94796e-06 | 2.84627e-06 | 1.06483e-05 | 1.0717e-05 | 3.39409e-06
3 | 3.15133e-06 | 3.03996e-06 | 3.18535e-06 | 3.09102e-06 | 3.13116e-06 | 1.08193e-05 | 1.05749e-05 | 3.30649e-06
4 | 3.13668e-06 | 3.13591e-06 | 3.10504e-06 | 3.15799e-06 | 3.133e-06 | 1.09529e-05 | 1.10273e-05 | 3.51183e-06
5 | 2.92056e-06 | 3.05488e-06 | 2.98059e-06 | 3.12467e-06 | 3.09045e-06 | 1.07642e-05 | 1.06454e-05 | 3.36821e-06
6 | 3.04587e-06 | 2.9983e-06 | 3.0052e-06 | 2.98453e-06 | 2.89498e-06 | 1.0361e-05 | 1.05646e-05 | 3.30467e-06
7 | 3.29869e-06 | 3.28626e-06 | 3.28964e-06 | 3.31432e-06 | 3.15363e-06 | 1.08277e-05 | 1.08755e-05 | 3.52717e-06
8 | 3.38882e-06 | 3.35137e-06 | 3.51246e-06 | 3.40735e-06 | 3.51493e-06 | 1.15946e-05 | 1.16423e-05 | 3.76276e-06
9 | 3.28552e-06 | 3.40124e-06 | 3.46808e-06 | 3.33425e-06 | 3.35732e-06 | 1.12193e-05 | 1.13709e-05 | 3.58859e-06
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
