sykeisuke/asic_rd/mixed_signal/bias_gen/data/verify_startup.csv

corner | temp | rcorner | case | icore | icmp | su | t90
typical | 0 | res_typical | ramp100n | 3.29469e-06 | 3.01228e-06 | 7.76889e-06 | -1.08335e-08
typical | 0 | res_typical | ramp10u | 3.29469e-06 | 3.0124e-06 | 7.6535e-06 | -5.14108e-06
typical | 0 | res_typical | ramp1m | 3.29469e-06 | 3.0124e-06 | 4.16214e-06 | -0.000424351
typical | 0 | res_typical | dead | 3.29469e-06 | 2.88825e-06 | 4.46006e-06 | 1.933e-08
typical | 0 | res_ss | ramp100n | 2.73539e-06 | 2.51496e-06 | 9.11297e-06 | -1.0873e-08
typical | 0 | res_ss | ramp10u | 2.73539e-06 | 2.51508e-06 | 8.97752e-06 | -5.14543e-06
typical | 0 | res_ss | ramp1m | 2.73539e-06 | 2.51508e-06 | 4.88188e-06 | -0.000420225
typical | 0 | res_ss | dead | 2.73539e-06 | 2.39083e-06 | 5.24638e-06 | 1.931e-08
typical | 0 | res_ff | ramp100n | 4.13561e-06 | 3.75385e-06 | 6.41812e-06 | -1.07744e-08
typical | 0 | res_ff | ramp10u | 4.13561e-06 | 3.75397e-06 | 6.32289e-06 | -5.13354e-06
typical | 0 | res_ff | ramp1m | 4.13561e-06 | 3.75397e-06 | 3.43883e-06 | -0.000429575
typical | 0 | res_ff | dead | 4.13561e-06 | 3.87815e-06 | 3.82994e-06 | 1.936e-08
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
