sykeisuke/asic_rd/digital/asic_digital_top/physical/final_views/nl/asic_digital_top.nl.v

module asic_digital_top (clk,
    cnt_clk,
    conversion_busy,
    conversion_done,
    data_ready,
    ramp_rst,
    rst_n,
    serial_data,
    shift_en,
    start,
    conversion_timeout,
    q,
    s0,
    s1,
    s2);
 input clk;
 output cnt_clk;
 output conversion_busy;
 output conversion_done;
 output data_ready;
 output ramp_rst;
 input rst_n;
 output serial_data;
 input shift_en;
 input start;
 output [3:0] conversion_timeout;
 input [3:0] q;
 output [3:0] s0;
 output [3:0] s1;
 output [3:0] s2;

 wire _000_;
 wire _001_;
 wire _002_;
 wire _003_;
 wire _004_;
 wire _005_;
 wire _006_;
 wire _007_;
 wire _008_;
 wire _009_;
 wire _010_;
 wire _011_;
 wire _012_;
 wire _013_;
 wire _014_;
 wire _015_;
 wire _016_;
 wire _017_;
 wire _018_;
 wire _019_;
 wire _020_;
 wire _021_;
 wire _022_;
 wire _023_;
 wire _024_;
 wire _025_;
 wire _026_;
 wire _027_;
 wire _028_;
 wire _029_;
 wire _030_;
 wire _031_;
 wire _032_;
 wire _033_;
 wire _034_;
 wire _035_;
 wire _036_;
 wire _037_;
 wire _038_;
 wire _039_;
 wire _040_;
 wire _041_;
 wire _042_;
 wire _043_;
 wire _044_;
 wire _045_;
 wire _046_;
 wire _047_;
 wire _048_;
 wire _049_;
 wire _050_;
 wire _051_;
 wire _052_;
 wire _053_;
 wire _054_;
 wire _055_;
 wire _056_;
 wire _057_;
 wire _058_;
 wire _059_;
 wire _060_;
 wire _061_;
 wire _062_;
 wire _063_;
 wire _064_;
 wire _065_;
 wire _066_;
 wire _067_;
 wire _068_;
 wire _069_;
 wire _070_;
 wire _071_;
 wire _072_;
 wire _073_;
 wire _074_;
 wire _075_;
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
 gf180mcu_as_sc_mcu7t3v3__fillcap_16 FILLER_56_107 ();
 gf180mcu_as_sc_mcu7t3v3__fillcap_8 FILLER_56_123 ();
 gf180mcu_as_sc_mcu7t3v3__fillcap_4 FILLER_56_131 ();
 gf180mcu_as_sc_mcu7t3v3__fillcap_8 FILLER_56_139 ();
 gf180mcu_as_sc_mcu7t3v3__fill_1 FILLER_56_147 ();
 gf180mcu_as_sc_mcu7t3v3__fillcap_4 FILLER_56_161 ();
 gf180mcu_as_sc_mcu7t3v3__fill_2 FILLER_56_165 ();
 gf180mcu_as_sc_mcu7t3v3__fill_1 FILLER_56_167 ();
 gf180mcu_as_sc_mcu7t3v3__fill_2 FILLER_56_172 ();
 gf180mcu_as_sc_mcu7t3v3__fill_1 FILLER_56_174 ();
 gf180mcu_as_sc_mcu7t3v3__fillcap_16 FILLER_56_177 ();
 gf180mcu_as_sc_mcu7t3v3__fillcap_16 FILLER_56_18 ();
 gf180mcu_as_sc_mcu7t3v3__fillcap_8 FILLER_56_193 ();
 gf180mcu_as_sc_mcu7t3v3__fillcap_16 FILLER_56_2 ();
 gf180mcu_as_sc_mcu7t3v3__fill_2 FILLER_56_201 ();
 gf180mcu_as_sc_mcu7t3v3__fill_1 FILLER_56_203 ();
 gf180mcu_as_sc_mcu7t3v3__fillcap_4 FILLER_56_241 ();
 gf180mcu_as_sc_mcu7t3v3__fillcap_8 FILLER_56_284 ();
 gf180mcu_as_sc_mcu7t3v3__fill_1 FILLER_56_292 ();
 gf180mcu_as_sc_mcu7t3v3__fillcap_8 FILLER_56_304 ();
 gf180mcu_as_sc_mcu7t3v3__fill_2 FILLER_56_312 ();
 gf180mcu_as_sc_mcu7t3v3__fill_1 FILLER_56_314 ();
 gf180mcu_as_sc_mcu7t3v3__fillcap_16 FILLER_56_317 ();
 gf180mcu_as_sc_mcu7t3v3__fillcap_4 FILLER_56_333 ();
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
