sykeisuke/asic_rd/(commit log)

2026-08-05 Add pinned GF180 analog design environment
    [nmos_dc.sch]
2026-08-11 Define relaxed first-prototype specification
2026-08-11 Add GF180 sampling cell baseline
    [sampling_cell.sch]
2026-08-11 Complete digital mixed-signal RTL-to-GDS flow
    [metrics.csv]
2026-08-12 Fix Xschem raw result launcher path
    [nmos_dc.sch]
2026-08-12 Plot positive NMOS drain current
    [nmos_dc.sch]
2026-08-12 Use Xschem RPN syntax for drain current
    [nmos_dc.sch]
2026-08-12 Support Xschem GUI simulation for NMOS sweep
    [nmos_dc.sch]
2026-08-12 Add working NMOS width experiment
    [nmos_dc.sch]
2026-08-12 Add Xschem waveform view for sampling cell
    [sampling_cell.sch]
2026-08-13 add detailed ASIC circuit design workbook
    [sampling_cell_tg.sch]
2026-08-13 update prototype specification in English and Japanese
2026-08-13 fully localize Japanese prototype specification
2026-08-14 define three-stage prototype and silicon test plan
2026-08-31 redefine Gate A around platform checks and add CI
    wafer.space confirmed (2026-08-30) it issues no written confirmations and
    performs DRC-only checking; COB is granted to designs passing the platform
    checks. Gate A now closes via public-repo evidence, conservative ESD design
    rules, and an empirical padring experiment. All grounds are common on the
    default COB breakout, so supply separation is reduced to AVDD only.
    Adds GitHub Actions CI: RTL simulation/synthesis/co-simulation on every push
    and PR, full analog regression weekly and on demand, all inside the pinned
    IIC-OSIC-TOOLS container.
2026-08-31 record padring-experiment local PASS for WS-06
    Second core vdd/vss pair on the 0p5x1 ring passes gf180mcu-precheck --cob
    (COB pad mask, antenna, Magic and KLayout DRC clean). Platform run remains.
2026-09-01 WS-06 platform-verified: CoB pad-mask check passed on platform.wafer.space
    Check #800 (precheck 1.7.3): hash verified, CoB pad mask, DRC, antenna all
    clean; only empty-core density errors remain, resolved by fill in a real
    build. The second core vdd/vss pair on the 0p5x1 ring is accepted.
2026-09-01 sync docs with Gate A closure: spec v0.4, AVDD-only separation, platform-verified ring
    - Specification (EN/JP) 0.3 -> 0.4: status, frozen-baseline table, test-access
    supply requirement, Gate A wording, and open external decisions reflect the
    2026-08-31 resolution (no written provider acceptance; platform CoB precheck
    passed; ESD by design rule; all grounds common on COB).
    - TOP_LEVEL_INTERFACE, TAPEOUT_BLOCKERS: supply topology frozen; next external
    gate is the slot purchase.
    - decisions/0004: addendum recording how each confirmation was resolved.
    - VERIFICATION_MATRIX: pad-ring row added; chip-top/package unblocked to OPEN;
    3.3 V digital regeneration listed.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
2026-09-01 nmos width experiment: settle on W=5u and make it reproducible
    Schematic, hand-written netlist, and README now agree on W=5u (they had
    drifted to 5u / 1u / 3u). Graph y2 raised to 0.003 to fit the measured
    2.55 mA peak. Adds scripts/run-nmos-width.sh and the nmos-width make target,
    which cross-checks both sources for W=5u, and includes it in
    analog-regression. xschem returns 10 in batch mode even on success, so the
    script tolerates that and relies on the netlist existence check.
    [nmos_dc.sch]
2026-09-26 Add mixed_signal/top_placement: digital-on-top chip on the wafer.space 0p5x1 template
    Pad ring, digital top, CMP/INV/INV_GF hard macros with generated pins,
    analog pad wires, LibreLane config, summary checkers and final-view metrics.
    [metrics.csv]
2026-09-26 Tope level placement with digital on top
    [metrics.csv]
2026-10-03 RTL: parallel 8-bit Wilkinson controller, 32-bit digital top (architecture 2026-09-18)
    Design review decisions: no analog MUX, one comparator per cell, broadcast
    ramp, 8-bit ADC. New parallel_wilkinson_controller: shared 8-bit Gray
    counter, four comparator-edge capture channels with toggle synchronizers,
    acquire/ramp_connect/ramp_reset mode outputs, per-cell timeout (code 255),
    DRAIN state for late captures after overflow. asic_digital_top now uses it
    with a 32-bit serial frame {cell3..cell0}; SDC declares compare_high[3:0]
    as one asynchronous clock group. Self-checks: 16/20/27/35 parallel,
    200/200/3/254, one never-crossing cell, capture at count 255.
    GF180 mcu7t5v0 mapping: controller 437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
2026-10-03 parallel controller: per-channel capture registers inside the generate block (Verilator MULTIDRIVEN clean)
    Each comparator-clocked capture channel now owns its Gray/toggle flops;
    the flat captured_gray/capture_toggle buses are wires assembled from them.
    Behaviour unchanged (parallel-controller and digital-top self-checks pass).
    (cherry picked from commit 2d4fbf79603fa6ad5f0e35294ae6e2715f2264b0)
2026-10-03 Digital flow retargeted to the frozen 3.3 V library (gf180mcu_as_sc_mcu7t3v3); make pdk
    The container image ships only the 5 V standard cells, so scripts/eda-pdk.sh
    (make pdk) fetches the frozen PDK commit's gf180mcu_as_sc_mcu7t3v3, fd_pr,
    fd_io and ocd_io libraries with ciel into the git-ignored .eda-tools/pdk
    (about 1 GB, cached in CI). All digital unit scripts, the STA script, the
    digital-physical flow and the digital-on-top experiment now use the 3.3 V
    library.
    Results at 3.3 V: unit tests pass (digital top 615 cells / 21776 um^2 in
    synthesis); make digital-physical clean (292 x 310 um die, 1508 std cells,
    0 routing/Magic/KLayout DRC, 0 LVS, 0 timing/antenna violations, worst
    setup 42.6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
    [metrics.csv]
2026-10-03 mixed_signal/top_placement: wire the 8-bit parallel digital top (pad map, VERILOG_FILES, README)
    Captures 1..3 take the ext_compare pad (no comparator for them on this
    chip), capture 0 the comparator or the pad under test_mode; acquire /
    ramp_connect / ramp_reset / conversion_timeout on the output pads.
    Lint-compiles with macro stubs. The run recorded in RESULTS.md used the
    6-bit MUX top.
2026-10-03 spec 0.5-draft: input window, comparator-variant decision framing, capacitor/MUX scaling path
    Proposal for review after the design-team discussion (2026-09-16): input
    window 1.5 V span (IRSX-like 0.5-2.0 V as working assumption, position free
    on 3.3 V); comparator variant to be decided together with the window using
    the widened-window sweep (NMOS +1..+3 vs PMOS +1..+6 over 0.5-2.0 V); the
    1 pF hold capacitor and the 4:1 analog MUX are Tape-out 1 choices, with the
    scaling path (comparator per cell, broadcast ramp, <= 50 fF) written down;
    GF180 MIM minimum 50 fF noted; small-capacitor test structures as Stretch.
    (cherry picked from comm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
2026-10-03 Docs: spec 0.6-draft (parallel conversion, bottom-plate sampling, 54.5 fF MIM, 8 bit), ADR 0005, matrix, interface, handoff, roadmap
    Records the 2026-09-18 design-review decisions and this repository's
    consequences: sections 5.1-5.5 rewritten (HOLD_REF-before-SAMPLE order,
    sensed-plate rule, parallel conversion, 8-bit codes, 32-bit frame), frozen
    item table updated (MUX removed, MIM 54.5 fF, comparator spec to re-derive),
    Tape-out 3 scale note (616 um^2 drawn cell vs provider slots), revision log.
    Japanese mirror updated. Verification matrix marks the MUX-path results as
    legacy and adds bottom-plate-cell / parallel-controller. Interface table
    switched to acquire/ramp_connect/ramp_reset, comp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
2026-10-03 Docs: spec 0.6-draft, ADR 0005, bottom-plate cell study, matrix/handoff/roadmap for main (references pointed at mixed_signal/top_placement and the exploration branch)
    (cherry picked from commit 0456a156c4ca5d1373830d03c9951749f64ffadc)
2026-10-03 Docs: slot changed to 1x0.5 (2026-10-02), 4 analog pads, second pair at bidir[45:44]; synchronous-capture option from the review
    ADR 0004 addendum; spec (EN/JP) header, slot row and purchase item; handoff
    deadlines/state; blockers; matrix row for the 1x0p5 fork run; interface
    pad budget; roadmap.
    (cherry picked from commit 083fae843f6e280899ef20b98a299e12acb08693)
2026-10-03 Docs: comparator and ramp items from the 2026-10-02 review (fixed trip, in-cell latch, sizing guidance, over-voltage constraint, simple ramp, pin list first)
2026-10-03 CI: nightly digital build (unit tests, STA, RTL-to-GDS of the digital top) with GDS/metrics artifacts
    Daily at 12:00 UTC (02:00 HST): the five digital unit targets and
    make digital-physical at 3.3 V, final GDS/LEF/metrics uploaded as a
    14-day artifact. The weekly analog regression keeps its Monday cron; the
    two schedules are told apart by github.event.schedule. First step toward
    the always-buildable full-chip GDS asked for in the 2026-10-02 review; the
    chip-level job follows once mixed_signal/top_placement builds from main.
2026-10-09 Docs: mixed_signal/top_placement now builds from a clean checkout (verified 2026-10-09); nightly-chip job noted
    [metrics.csv]
2026-10-10 Move unused digital blocks to digital/legacy/
    four_cell_wilkinson_controller (sequential MUX controller, superseded
    2026-09-18) and wilkinson_counter (first 6-bit counter) are no longer on the
    Tape-out 1 path. Move them under digital/legacy/ with a README, and update
    the script paths and links. Make targets are unchanged.
    wilkinson_gray_counter stays in place: the parallel controller still uses
    its capture scheme. It moves once the synchronous capture (PR #19) is redone.
    [four_cell_wilkinson_controller.v, tb_four_cell_wilkinson_controller.v, tb_wilkinson_counter.v, wilkinson_counter.v]
2026-10-26 mixed_signal: 8-bit analog blocks and the Analog_top macro, one folder per block
    The latest 8-bit true bottom-plate design, one folder per analog block with
    versionless cell names: comparator, latch (dfxtn_2), midrail_ref (midref),
    bias_gen, vrlo_ref, ramp_gen (ramp_simple), Analog_top (four cells, ramp,
    bias, VDD/2 and VR_LO references; cells 50 ns apart, one 20 MHz clock),
    cell_trannoise (one-cell VACASK transient noise) and chip_floorplan (1x0p5
    ring). analog_layout: MOM-cap generators and the PEX helper.
    Make targets, one run script each: comparator (now the 8-bit comparator),
    comparator-pvt, comparator-schematic, latch, midrail-ref, bias-gen,
    vrlo-ref, ramp-gen, analog-top, cell-tranno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
2026-10-28 Digital: Analog_top interface — synchronous q capture, on-chip sampling sequence (s0/s1/s2, ramp_rst), delay lines (ADR 0010)
    Rebuilt on main after the design team's Analog_top (PR #22). The digital top
    now implements the macro's contract (mixed_signal/Analog_top/PIN_LIST.md,
    tb_params.inc):
    - q[3:0]: the cells' dfxtn_2 latches (negative edge on cnt_clk), high before
    the crossing, one fall after it; code = count at the rising edge that first
    sees q low = floor((t_qfall - TR)/TCOUNT). No Gray capture, no CDC.
    - sampling sequence from `start`: s2[k] falls one clock apart (TS_k), s0[k]
    opens 5 ns later and s1[k] closes 10 ns after s2 through kept delay lines
    (12 / 25 dlybuff_2 stages,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
2026-11-01 PDK baseline moved to 792ef670 (provider update 2026-10-20): make pdk, CI cache, docs, ADR 0004 addendum
    wafer.space released PDK 792ef67037d74c8c51811eab3ce23cf793491296 with
    template 1.6.0 and precheck 1.7.4 and asked projects to update. Diff vs
    f6eeac7d: new KLayout DRC decks (DCF.1a, DF.11, CO.5a/b), updated
    as_sc_mcu7t3v3 (24 new cells; only nand3_2/nand4_2 re-characterized,
    dfxtn_2/dlybuff_2 identical), ocd_io LEF identical / GDS changed, ngspice
    models differ only in the fox_sub syntax, Magic tech changed.
    Verified: precheck 1.7.4 with the new PDK passes on the last full-chip GDS
    (pad mask, density, antenna, Magic DRC, KLayout DRC 733 rules); on this
    branch make pdk fetches 792ef670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
2026-11-01 Template pin → release 1.6.0 (d99f6e1b): fork 1x0.5 branch rebased onto it builds clean on PDK 792ef670 and passes precheck 1.7.4
2026-11-02 chip_integration: digital-on-top chip flow as its own folder
    A stand-alone flow that follows the digital-on-top figure
    (flow/fig11_digital_on_top.svg) from copied inputs to a signed-off
    1x0p5 chip:
    - inputs/: the hardened digital top (GDS, LEF, netlist), the analog top
    GDS with its pin contract, and the wafer.space template files at
    0de7e394 (slot, config, PDN, ID cells), listed in MANIFEST.sha256 and
    refreshed only by scripts/fetch_inputs.sh;
    - scripts/macros.py: analog GDS -> hard macro (LEF, liberty, Verilog and
    SPICE black boxes) from its PR boundary and pin labels; liberty timing
    models of the digital top (OpenSTA); macro KLayout DRC and Magic bbox;
    - librelane/: the LibreLan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
2026-11-03 mixed_signal: ramp_simple + ic_source ramp, sample_seq, Analog_top v7, testbench drawings
    - ramp_simple (new): the shared ramp as 73 unit MIMs + reset switch on the
    ADR 0025 code grid (LSB 6.70 mV, pre-roll at VR_LO = 7/55 AVDD).
    - ic_source (new): I/C switched-capacitor current source that sets the ramp
    slope as a unit-MIM ratio (54.52 fF x 5/33 AVDD x 20 MHz).
    - sample_seq (new): on-chip S2 / S0 / S1 sequencer of the four cells from the
    20 MHz clock and acquire, frozen standard cells on DVDD, >= 5 ns between
    phases over 45 PVT cells.
    - Analog_top v7: ramp_simple + ic_source replace ramp_simple_d, vrlo_ref at
    7/55 AVDD, sample_seq inside (12 switch-control ports -> acq); frozen v5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
2026-11-03 Digital: Analog_top v7 interface — acq replaces the s0/s1/s2 switch outputs; delay lines retired (ADR 0027)
    Analog_top v7 (PR #25) contains the sampling sequencer sample_seq, which
    makes the twelve cell switch controls from the count clock and the
    controller's acquire level. The digital top therefore drives acq (HIGH =
    track, a flop on the rising edge) instead of s0/s1/s2[3:0]; cell k samples
    at the k-th rising edge after the edge that first sees acq low, TR = TS_3 +
    6 clocks and the capture rule are unchanged. delay_line.v moves to
    digital/legacy/ (no kept delay stages, no 5 V define in the chip flow).
    Verified: make parallel-controller / digital-top pass (testbench models the
    sequencer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
2026-11-03 top_placement: final views from the full-chip run with the acq interface (PDK 792ef670; 0 DRC/LVS/antenna/timing violations)
